fvilla-edge/Sand-Monitoring/relay/modulo-rele-biestable-flip-flop-12v.jpg

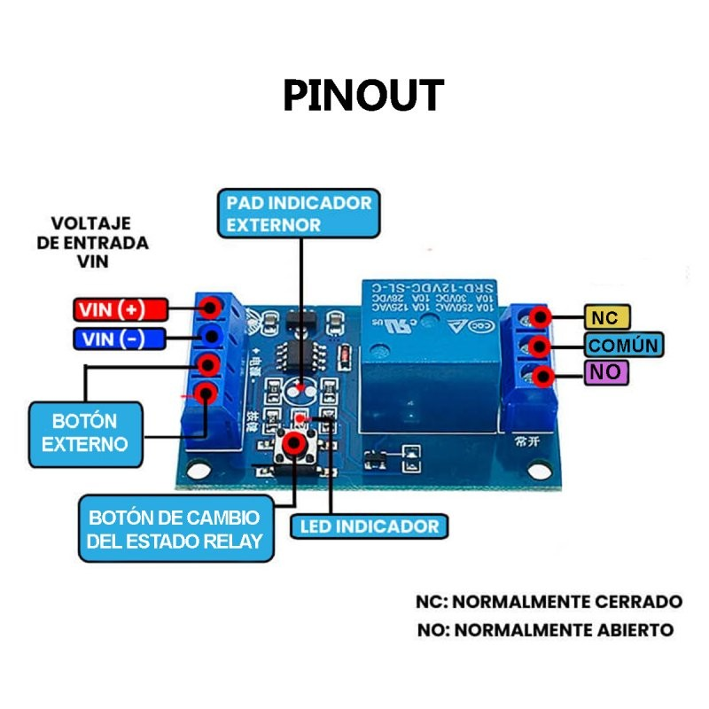
relay/modulo-rele-biestable-flip-flop-12v.jpg
