fvilla-edge/Sand-Monitoring/starlink_api/README.md

# Telemetria del dish Starlink (GPS + estado del link) para Losant

`starlink_get_location.py` lee posicion GPS y estado del link de la antena
Starlink via su API gRPC no oficial (`192.168.100.1:9200`), y expone
`build_telemetry_payload()` + `to_losant_data()` para convertir eso al formato
plano que espera Losant.

**Este modulo no corre solo en produccion.** Lo consume
`panel_solar_ble/publicar_losant.py`, que publica el estado a Losant en el
mismo Device que ya usa el panel solar (mismo `DEVICE_ID`, a proposito — ver
`panel_solar_ble/losant_config.py`). No hay un servicio ni credenciales
propias en esta carpeta: dos conexiones MQTT simultaneas con el mismo
`client_id` se pisarian entre si.

`publicar_losant.py` publica el estado de Starlink una sola vez por cada
evento `connect`/`reconnect` de Losant (la señal mas directa de "hay
internet y llega a destino") — no hay reporte periodico para esto, a
diferencia del panel solar.

## Modo hardcoded vs live

Controlado por `starlink_api.modo` en `config_campo.json` (`"hardcoded"` o
`"live"`), leido una sola vez al importar `publicar_losant.py` (mismo
reinicio de servicio que cualquier otra config leida asi, ver
`DESPLIEGUE.md`).

- **`hardcoded`** (default): usa `HARDCODED_TELEMETRY` de este archivo — un
  ejemplo real capturado el 2026-08-24. Sirve para probar toda la cadena
  (config → Losant → dashboard) sin estar conectado a la antena.
- **`live`**: llama a `build_telemetry_payload()`, que habla de verdad con el
  dish por gRPC.

## Por que `grpcurl` por subprocess y no la libreria `grpcio`

`pip install grpcio` en la placa (Red Pitaya, `armv7l`, Python 3.12) SI
encuentra un wheel binario en PyPI (`grpcio-1.83.0-cp312-cp312-linux_armv7l.whl`)
y se instala sin compilar nada — pero al importarlo tira `Illegal
instruction`. El Cortex-A9 de esta placa no soporta alguna instruccion que
ese wheel generico da por sentada (confirmado en la placa real, no una
suposicion). `piwheels` tampoco sirve: no publica `grpcio` para esta
combinacion de plataforma/version de Python.

El binario estatico `grpcurl` (Go, build `linux_armv7`) corre limpio en esta
misma placa — sin compilacion C, sin el problema de instrucciones del wheel
de `grpcio`. `build_telemetry_payload()`/`get_dish_location()` lo invocan
por `subprocess` (`bin/grpcurl`, o el del `PATH` si existe) y parsean su
salida JSON — validado contra el dish real (ver mas abajo), incluyendo el
modo `live` end-to-end.

**Ojo con las claves:** `grpcurl` devuelve JSON en **camelCase**
(`getLocation`, `dishGetStatus`, `gpsStats`, `popPingLatencyMs`, etc. — el
mapeo estandar de proto3 a JSON), no en snake_case como devolvia
`MessageToDict(..., preserving_proto_field_name=True)` de la libreria
`grpcio` que se uso originalmente. El parseo de `starlink_get_location.py`
ya usa los nombres camelCase correctos — si el dish cambia de firmware y el
esquema cambia, `grpcurl -plaintext <host> describe SpaceX.API.Device.Response`
sirve para volver a inspeccionarlo.

**Instalar el binario en una placa nueva** (no viene en git, es un binario
externo):
```bash
mkdir -p /root/starlink_api/bin && cd /root/starlink_api/bin
curl -sL -o grpcurl.tar.gz https://github.com/fullstorydev/grpcurl/releases/download/v1.9.3/grpcurl_1.9.3_linux_armv7.tar.gz
tar xzf grpcurl.tar.gz grpcurl && rm grpcurl.tar.gz && chmod +x grpcurl
```

## Atributos que hay que crear en Losant

Mismo Device que panel solar. Nombre → tipo, segun `to_losant_data()`:

| Atributo | Tipo |
|---|---|
| `posit` | string ("lat,lon") |
| `altitude` | number |
| `gps_valid` | boolean |
| `gps_satellites` | number |
| `ping_ms` | number |
| `ping_drop_rate` | number |
| `downlink_bps` | number |
| `uplink_bps` | number |
| `obstruction_fraction` | number |
| `alerts` | string |
| `uptime_s` | number |
| `hardware_version` | string |
| `software_version` | string |
| `starlink_device_id` | string |
| `software_update_state` | string |
| `software_update_progress` | number |
| `disablement_code` | string |
| `starlink_error` | string |

Si no existen en el Device antes del primer publish, Losant probablemente
los descarta silenciosamente.

**`disablement_code`** — por que el dish no esta dando servicio (viene de
`dishGetStatus.disablementCode`, enum `SpaceX.API.Satellites.Network.UtDisablementCode`,
confirmado contra el dish real via `grpcurl describe`). En operacion normal
vale `OKAY`. Valores posibles:

| Valor | Significado |
|---|---|
| `OKAY` | Sin problema, dando servicio normalmente |
| `UNKNOWN_STATE` | Sin dato todavia (recien arrancando, etc.) |
| `NO_ACTIVE_ACCOUNT` | La cuenta de Starlink asociada no esta activa |
| `ACCOUNT_DISABLED` | Cuenta deshabilitada |
| `TOO_FAR_FROM_SERVICE_ADDRESS` | El dish se movio lejos de la direccion de servicio registrada |
| `IN_OCEAN` | Detectado en el oceano, fuera de zona de servicio |
| `UNKNOWN_LOCATION` | No pudo determinar la ubicacion para validar el servicio |
| `BLOCKED_COUNTRY` | Pais bloqueado por Starlink |
| `BLOCKED_AREA` | Zona especifica bloqueada (aunque el pais no lo este) |
| `ROAM_RESTRICTED` | Roaming no permitido para este plan/cuenta en esta ubicacion |
| `DATA_OVERAGE_SANDBOX_POLICY` | Cortado por politica de exceso de datos |
| `CELL_IS_DISABLED` | La celda satelital que le corresponde esta deshabilitada |
| `MOVING_TOO_FAST_FOR_POLICY` | Se esta moviendo mas rapido de lo que permite la politica del plan |
| `UNDER_AVIATION_FLYOVER_LIMITS` | Restringido por limites de sobrevuelo (uso aviacion) |
| `UNSUPPORTED_VERSION` | Version de software del dish no soportada |

Util para diagnostico remoto: si Losant deja de recibir datos, este campo
(en el ultimo reporte que si llego) puede explicar si fue un corte de
conectividad comun o si Starlink dejo de dar servicio por una causa
puntual (cuenta, ubicacion, politica de uso).

`starlink_error` no viene de `to_losant_data()` — lo agrega
`publicar_losant.py` aparte: `None` cuando el informe salió bien, mensaje de
la excepción (string) cuando falló obtener o publicar la telemetría (ver
`_publicar_starlink`). Es la forma de enterarse en campo, sin SSH a mano,
de que algo del lado Starlink dejó de funcionar.

## Probar la transformacion sin la placa ni grpcio instalado

```bash
python3 -c "from starlink_get_location import to_losant_data, HARDCODED_TELEMETRY; print(to_losant_data(HARDCODED_TELEMETRY))"
```
