fvilla-edge/Sand-Monitoring/docs/modo_evento.md

# Modo evento — captura continua 24h, guardando solo lo que importa

Estado al 2026-11-02:

- **Campo (`rp-f0fbda`):** instalada en el sitio (PAD-118) desde el 29/10, en
  **dual** (IN1 + IN2, dec 64) con el bitstream del IN2 `20ac88b` y el
  paquete `ff47f40` (tag `campo-2026-10-21b`). Starlink en modo ventana: los
  CSV suben a GCS cada 2 h y se ven en SandVision.
- **Lab (`rp-f0fd8c`):** mismo software; ahí se prueba todo antes de campo.
- Falta: calibrar el umbral del IN2 con arena real (hoy usa el del IN1) y
  explicar los picos sueltos del IN2 de la primera noche en el sitio
  (29-30/10, kurtosis 5-850 en un solo punto, sin pase en el IN1).

Historia de cada parte en los planes: `plan_dos_canales.md` (primera versión,
IN2 de referencia; reemplazada), `plan_in2_independiente.md`,
`plan_in2_asociado.md`, `plan_cambio_canales_remoto.md`,
`plan_canales_por_tag.md`. Este documento describe **cómo funciona hoy**.

## Idea

Capturar la señal del sensor **todo el tiempo**, sin cortes, pero sin guardar
~230MB cada 30s. La FPGA calcula área y kurtosis de cada ventana de 50ms en
tiempo real; el programa de la placa guarda:

| Qué | Cuándo | Tamaño aprox. |
|---|---|---|
| Área + kurtosis de **cada** ventana (CSV) | siempre, 24h | ~30MB/día |
| Señal cruda de la ventana ±10ms (`evento_*.bin` + `.json`) | solo si kurtosis ≥ umbral (default 3.4 desde el 5/10/2026, antes 5) | ~0.5MB por evento a dec32 |

En dual, el IN2 tiene lo mismo (su CSV y sus eventos) en `<destino>/in2/`
(ver "Mono y dual").

Por qué guardar siempre el área y la kurtosis, además de los eventos:

1. **Señal de vida.** Sin el registro continuo, una carpeta sin eventos puede
   significar "no pasó arena" o "el sensor se desconectó" — no hay forma de
   distinguirlo. Con el registro, un sensor muerto se ve (área en cero o
   anormal).
2. **Historia completa del pozo**: duración de los pases, horarios,
   tendencias; no solo picos sueltos.
3. **Reanalizar hacia atrás.** Si el umbral correcto resulta ser otro (el 21/9
   el criterio viejo `fa%>25%` no vio arena real), se recalcula con los datos
   ya grabados. Lo que quedó bajo el umbral no se pierde.
4. **Validar contra el campo**: cuando el pozo dice "hubo arena de 14:50 a
   15:17", se ve qué midió el sensor en todo ese intervalo.
5. **Reconstruir la señal** en la PC con un relleno realista (ver abajo).

## Piezas

```
Placa (rp-f0fd8c / campo)                      PC
─────────────────────────                      ──
FPGA (bitstream port-2026.1)                   ventanas_a_paquete.py
  pasabanda 50-400kHz + área/kurtosis            CSV -> paquete liviano (JSON)
  por ventana (registros 0x40000328..;          ver_paquete.py
  IN2 desde 0x4000034C, bitstream 20ac88b)
        │ registros                              visor área/kurtosis, horas/días
        ▼                                      reconstruir_senal.py
scripts_campo/c/capturar_eventos (C++)           eventos + CSV -> señal continua
  - stream NET de la señal CRUDA -> buffer        (dominio filtrado, relleno
    circular en RAM                                con ruido de fondo)
  - sondea los registros de la FPGA c/2ms      verificar_etapaB.py
  - kurtosis >= umbral -> guarda la cruda        banco: eventos vs tramo real
  - escribe el CSV de todas las ventanas
scripts_campo/capturar_eventos.py (lanzador)
```

- `scripts_campo/c/capturar_eventos.cpp` — núcleo. Compilar **en la placa**:
  `make -C /root/scripts_campo/c` (usa `/root/rpsa_client/streaming_api`).
  Está en C++ porque en Python el callback no daba abasto (~63% de muestras
  perdidas, ver el comentario de cabecera).
- `scripts_campo/capturar_eventos.py` — lanzador (bitstream + streaming-server
  + `exec` del binario).
- `analisis/placa/ventanas_a_paquete.py`, `analisis/placa/reconstruir_senal.py`,
  `analisis/visores/ver_paquete.py`, `analisis/placa/verificar_etapaB.py` — PC.

## Supervisor (`modo-evento.service`)

`scripts_campo/systemd/modo-evento.service` + `scripts_campo/supervisor_eventos.sh`.

- **Arranca solo al encender** (después de `redpitaya_startup` y
  `redpitaya_e3_controller`: si carga el overlay a la vez que el del vendor,
  `overlay.sh` falla con `overlays/Full: File exists` y el acumulador no
  aparece).
- **Relanza siempre** que el proceso se cae, **sin rendirse**
  (`StartLimitIntervalSec=0`), con **60s** de espera (`RestartSec`). Cada
  relanzamiento recarga el bitstream → `window_count` vuelve a empezar → el
  CSV queda con un hueco de **~74s** y `ventanas_a_paquete.py` lo separa en
  tramos.
- Cada fin de corrida queda en `/root/logs_campo/modo_evento_reinicios.log`
  (`resultado=core-dump estado=SEGV` = caída, `success` = parada limpia).
  Core dumps en `/root/logs_campo`, podados al límite de `config_campo.json`.
- **Destino: `/mnt/usb/eventos`** (storage externo, automontaje de
  `scripts_campo_comun/udev-automount/`). La señal cruda **nunca va a la SD**:
  - al arrancar (`supervisor_eventos.sh arrancar`, el `ExecStart`), si
    `/mnt/usb` no es un disco (carpeta de la SD o `tmpfs`) **mide igual, solo
    el CSV de ventanas**, en `rutas.eventos_sd` (`/root/eventos_sd`) con la
    cruda siempre pausada (~3MB/h; queda `sin_disco` en el log de reinicios).
    El destino real queda en `/run/modo-evento/destino` (`<carpeta>` o
    `<carpeta> sin_disco`) para el anotador. Cuando el disco vuelve,
    `automount_usb.sh` relanza `modo-evento` y vuelve solo a `/mnt/usb/eventos`
    (desde el 2026-10-01; antes no arrancaba y la placa quedaba sin medir
    hasta entrar por SSH, como el 30/9 y el 1/10 con el disco de campo caído);
  - durante la corrida, `capturar_eventos` verifica antes de cada escritura
    que el destino siga en el mismo dispositivo; si el USB se desconecta
    (el automontaje hace `umount -l` y `/mnt/usb` pasa a ser carpeta de la
    SD) corta con código 4 en el mismo segundo.
  - Probado con `umount -l`: corte inmediato, 0 archivos en la SD, al
    remontar retomó solo en el siguiente reintento.
- **Espacio libre** (`modo_evento.minimo_libre_mb` en `config_campo.json`,
  default 2048; 0 = sin control): por debajo se **pausa la señal cruda** de
  los eventos y el CSV sigue (~3MB/h: la línea de tiempo no se pierde); se
  reanuda con un 25% de margen (2560MB). Mientras está pausada existe
  `/run/modo-evento/cruda_pausada`, que el anotador manda a Losant como
  `me_cruda_pausada`, y la línea `ESTADO` dice `CRUDA PAUSADA` (siempre trae
  `libre_mb=`). Si igual se llena el disco, un evento que no entra se borra y
  se cuenta (`fallidos`, en el log el 1ro y 1 de cada 100), y el CSV avisa
  una vez, se recorta a la última fila completa y retoma solo al haber lugar.
- Umbral: `Environment=UMBRAL=...` en la unit.
- **El server acepta un solo cliente**: para usar `capturar_stream.py` en la
  misma placa, antes pasar a modo clásico (`cambiar_modo.sh clasico`, abajo).
- **Mono/dual y modo del IN2** salen de `config_campo.json`
  (`modo_evento.canales`, `modo_evento.in2_modo`); ver "Mono y dual". Un
  drop-in con `Environment=CANALES=` o `DEC=` gana sobre el config (solo para
  pruebas). `UMBRAL2` (opcional) = umbral del IN2; sin él, el del IN1.
- **Archivos de estado** (`/run/modo-evento/`, RAM, los lee el anotador):
  `destino` (carpeta, `sin_disco`), `medicion` (`canales=2 dec=64
  in2=independiente`, lo escribe el supervisor al arrancar), `in2` (`si`/`no`:
  si el bitstream calcula el IN2, lo escribe `capturar_eventos`), `cruda_pausada`.
  El supervisor borra `medicion` e `in2` al parar: mientras reinicia, el
  resumen no trae `me_canales`.

```bash
cp /root/scripts_campo/systemd/modo-evento.service /etc/systemd/system/
systemctl daemon-reload && systemctl enable --now modo-evento
systemctl status modo-evento            # estado
journalctl -u modo-evento -f            # log en vivo
systemctl stop modo-evento              # parar (no lo relanza)
```

### Vuelta atrás: modo clásico (`cambiar_modo.sh`)

Si el modo evento se porta mal en campo, se vuelve al esquema anterior
(bitstream del vendor, capturas a pedido con el comando "capturar" de Losant
o `capturar_stream.py`/`repetir_captura.sh`) y después se retoma:

```bash
bash /root/scripts_campo/cambiar_modo.sh clasico   # o: evento
journalctl -u cambiar-modo -f                      # seguirlo
cat /root/logs_campo/cambiar_modo.log              # historial de cambios
```

- **El bitstream lo elige el modo**: `asegurar_servidor(bitstream_propio=True)`
  en `capturar_eventos.py` carga `/opt/stream_app/fpga.bin`
  (`overlay.sh stream_app propio`); `capturar_stream.py` carga el stream_app
  del vendor. No hay que tocar nada más para cambiar de bitstream.
- Corre como unidad transitoria de systemd (`cambiar-modo`): un corte de SSH
  o de Starlink en el medio no lo interrumpe; un segundo cambio mientras hay
  uno en curso se rechaza; repetir el mismo modo no reinicia nada.
- `clasico`: `disable --now modo-evento` (no vuelve al reiniciar), carga el
  stream_app del vendor y verifica `/tmp/loaded_fpga.inf` = `stream_app` y el
  registro del acumulador (0x40000328) en 0.
- `evento`: rechaza si hay un `capturar_stream.py` corriendo;
  `enable --now modo-evento`, espera el primer `ESTADO` (tope 4 min, cubre la
  espera de 90s de uptime al boot) y verifica `stream_app_propio` y el
  registro en 195312.
- `resumen-modo-evento` sigue en los dos modos: en clásico manda
  `me_activo=false` (y `me_seg_sin_datos` crece, es esperable) junto con la
  salud de la placa.
- Al reiniciar en clásico la placa queda con el bitstream del arranque del
  vendor (`v0.94`); cada captura carga el stream_app del vendor.

Probado en `rp-f0fd8c` (2026-09-28): evento → clásico en 7s; captura clásica
de 1 min (2 chunks, 97%/94% de eficiencia, acumulador en 0); reboot en clásico
(sigue deshabilitado); clásico → evento en 30s con la sesión SSH cortada
(`kill -9`) al segundo de lanzarlo: midiendo al 100%, `NRestarts=0`;
repetir `evento` no reinició el servicio; un segundo cambio simultáneo fue
rechazado.

## Mono y dual

| Modo | Qué mide | Decimación | Eventos |
|---|---|---|---|
| Mono (`canales` 1) | IN1 | 32 (fs 3.906MHz) | IN1 en `<destino>/` |
| Dual independiente (`canales` 2, `in2_modo` independiente) | IN1 + IN2 | 64 (fs 1.953MHz) | cada sensor dispara por **su** kurtosis y **su** umbral: IN1 en `<destino>/`, IN2 en `<destino>/in2/` |
| Dual asociado (`in2_modo` asociado) | IN1 + IN2 | 64 | el IN2 graba su cruda **solo cuando graba el IN1**, el mismo tramo y con el **mismo nombre** en `in2/` |

- **Por qué dec64 en dual:** escribiendo 1 evento/s, dual a dec32 perdió
  0.12% de muestras y 5 ventanas en 15 min; a dec64, 0.00045% y 0 (pruebas
  W15/W15d64, 2026-10-06). La banda 50-400kHz entra entera (Nyquist 976kHz).
  Al arrancar, `capturar_eventos` escribe en la FPGA el largo de ventana (50ms)
  y los coeficientes del pasabanda para esa fs y los verifica. **Mono sigue a
  dec32.**
- **Los dos canales se calculan igual** en la FPGA (filtro + acumulador propios,
  mismos coeficientes y largo de ventana), con `window_count` común: las filas
  de los dos CSV se emparejan por `window_count`.
- **El IN2 sigue con su CSV** en los dos modos de dual; asociado solo cambia qué
  dispara la grabación de su cruda. En asociado el `.json` del IN2 trae
  `"disparo": "IN1"` y el área/kurtosis **del IN2** en esa ventana. Si la cruda
  del IN1 no se pudo guardar (espacio, buffer pisado), el IN2 sigue con lo suyo
  (puede quedar uno sin el otro).
- **Bitstream sin el IN2** (`7f23f7d`, ID `0x00000000`; el del IN2 tiene
  `0x534D0002` en `0x4020007C`): en independiente mide **solo el IN1** (log
  `WARNING bitstream sin calculo del IN2`), sin CSV del IN2; en asociado graba
  igual la cruda del IN2 (el stream trae los dos canales) pero sin su
  área/kurtosis (`null`) ni su CSV. Losant informa `me_canales = 1` en
  independiente.
- **A dec64 los números no son comparables con dec32 sin recalibrar:** el umbral
  3.4 se eligió a dec32 (reposo dec64 en el lab: kurtosis mediana 2.998, máx
  3.06); `ESCALA_FPGA_DEFAULT` / `PISO_FPGA_DEFAULT` están medidos a dec32. El
  umbral del IN2 es hoy el del IN1, sin calibrar con su sensor real.
- **Asociado duplica la escritura** de cruda en cada evento (IN1 + IN2): con
  mucha arena, el doble de disco y de E/S en el mismo instante.
- En el lab el IN2 solo vio ruido: falta ver los dos sensores con arena real.

### Cambiar de modo

No editar el config a mano (comandos y ejemplos en `COMANDOS.md`, sección
"Mono / dual y modo del IN2"):

- **En la placa:** `cambiar_canales.sh 1` / `2` / `2 independiente|asociado`.
- **Losant, comando `canales`:** `{"canales": 1}`, `{"canales": 2, "in2":
  "asociado"}` (`"in2"` opcional, solo con 2). Lo recibe `publicar_losant.py`
  y lanza el script.
- **Losant, tags del Device** `canales` / `in2_modo`: el workflow los compara
  con lo que la placa informa y manda el comando solo si difieren. **En modo
  ventana usar los tags**: Losant no guarda comandos, y uno mandado con la placa
  desconectada se pierde (`plan_canales_por_tag.md`). Con los tags puestos, un
  comando a mano distinto lo deshace el workflow al minuto.

`cambiar_canales.sh` corre desacoplado (`systemd-run --unit=cambiar-canales`:
sigue aunque se corte el SSH o Starlink; un segundo cambio en curso se rechaza),
toma el lock del relé (espera hasta 200 s), escribe las claves de forma atómica
(`cfg.py --poner`: temporal + fsync + rename), reinicia **solo** `modo-evento`
(hueco de ~1-2 min en el CSV) y espera hasta 4 min a que `medicion` diga lo
pedido. Si no, **vuelve solo al modo anterior**. Pedir lo que ya mide responde
`ok ... (ya estaba)` sin reiniciar; en modo clásico no hace nada. Tarda ~30 s;
~1 de cada 10 arranques la librería del vendor se cae en `startStreaming` y
systemd la relanza a los 60 s (el cambio tarda ~1,5 min y termina igual).
Resultado en `/root/logs_campo/cambio_canales_estado` (= `me_cambio`) y
historial en `cambiar_canales.log`.

### Qué llega a Losant (anotador `resumen_modo_evento.py`, cada minuto)

Además de lo de siempre (`me_activo`, `me_estado`, `me_ventanas_1min`,
`kurt_max_1min`, `area_*`, `me_cruda_pausada`, salud de la placa):

| Atributo | Qué es |
|---|---|
| `me_canales` | lo que **se mide**: 1 o 2 (dual con bitstream sin IN2 → 1); no viene mientras la captura reinicia |
| `me_in2_modo` | `independiente` / `asociado`, solo con `me_canales` = 2 |
| `me_dec` | 32 o 64 |
| `me_cambio` | resultado del último cambio (`ok 2 asociado <hora>`, `error: ... (volvio a 1)`, ...) |
| `kurt_max_1min_in2`, `area_max_1min_in2` | del IN2, en dual, **desde el segundo minuto** (el lector arranca al final del CSV) |

Los CSV del IN2 suben a GCS con sufijo `_in2` (`_sd_in2` sin disco), porque
tienen el mismo nombre que los del IN1.

## Formatos

### Registro continuo: `ventanas_AAAAMMDD_HH.csv` (uno por hora UTC)

En la carpeta `--destino`, junto a los eventos. Se apaga con `--sin-registro`.

```
window_count,t_utc_ms,area,kurtosis,estado,perdidas_fpga,dec
7995,1790257893778,0.634819,3.24481,ok,0,32
7217,1790258000123,,,saltada,0,32
```

- `dec` (desde 2026-10-06): la escala del área cambia con la decimación. Los
  CSV viejos (6 columnas, sin `dec`) son todos dec32; la hora en que se
  actualiza el software puede mezclar filas de 6 y 7 columnas (los lectores de la PC lo
  soportan).
- El del IN2 (`<destino>/in2/ventanas_*.csv`) tiene el mismo formato y nombre.

- `window_count`: contador de ventanas de la FPGA. **Es la referencia de
  tiempo exacta** (cada ventana dura 50ms justos). No es continuo entre
  corridas (reinicios de captura/bitstream).
- `t_utc_ms`: hora UTC en que el programa **leyó** la ventana (jitter de
  ~±35ms). Sirve para anclar a la hora real, no para ubicar muestras.
- `estado=saltada`: el sondeo no llegó a leer esa ventana (el registro de la
  FPGA solo guarda la última). Área y kurtosis vacías: no hay dato.
- `perdidas_fpga`: muestras que el streaming-server reportó perdidas desde la
  fila anterior.
- Escritura en un hilo propio (flush cada 1s, cota de 10 min en RAM) para que
  la SD no frene el sondeo.

### Evento: `evento_<fecha>_<hora>_<us>_wc<window_count>.bin` + `.json`

`.bin`: int16 little-endian, señal **cruda** (sin filtrar), ventana oficial +
margen a cada lado. `.json`:

| Campo | Qué es |
|---|---|
| `window_count` | ventana de la FPGA que cruzó el umbral |
| `fs_hz`, `dec` | frecuencia de muestreo y decimación |
| `ventana_muestras`, `margen_muestras` | 195312 y 39062 a dec32, 97656 y 19531 a dec64 (50ms, ±10ms) |
| `inicio_ventana_en_archivo` | dónde empieza la ventana oficial dentro del `.bin` (ver "alineación" abajo) |
| `area`, `kurtosis` | los que calculó la FPGA para ese canal (`null` si el bitstream no calcula el IN2) |
| `con_hueco` | `true` si faltaron muestras en ese tramo (ver "huecos") |
| `canales` | 1 o 2 (corrida mono o dual) |
| `canal` | sensor guardado en ese `.bin`: `IN1` o `IN2` (este en `<destino>/in2/`) |
| `disparo` | sensor que hizo grabar: `IN1`, o `IN2` en independiente; en asociado el del IN2 dice `IN1` |
| `timestamp_iso` | hora de la detección (desde el 2026-10-15 se fija al detectar, no al escribir: así el par IN1/IN2 asociado tiene el mismo nombre) |

## Comandos

En la placa (compilar una vez):
```bash
make -C /root/scripts_campo/c
```

Captura a mano, solo para pruebas con `modo-evento` parado (umbral 3.4,
destino por defecto `/root/eventos`; en la placa la corre el servicio):
```bash
python3 /root/scripts_campo/capturar_eventos.py --umbral 3.4 --destino /root/eventos
```

Pruebas de banco (loopback OUT1->IN1 con cable, reproduciendo un tramo real
por el DAC): scripts en `/root/prueba_eth0/` de `rp-f0fd8c` (fuera de git):
`etapaB_lv.sh T RATE` (umbral 5, a la SD), `etapaB_lv_todo.sh` (umbral 1),
`etapaB_lv_shm.sh` (umbral 1, a RAM), `larga.sh T SEGUNDOS` (sin DAC, con
monitor de RAM/CPU), `pase_u1.sh T SEGUNDOS` (umbral 1 a `/mnt/usb`, peor
caso de escritura). `--dac-repetir N` repite el tramo N veces seguidas (pase
largo por cable). **El loopback digital (`--pulso-loopback-digital`) NO sirve
para reproducir el tramo con el bitstream 2026.1** (kurtosis fija ~2.99, K1 del
23/9 y PASE1 del 24/9): usar el cable OUT1->IN1 con el jumper en LV.
Antes de estas pruebas, `systemctl stop modo-evento` (un solo cliente). **Antes de lanzar, verificar que el nombre `T` no exista**
(los scripts borran `ev_T` y pisan los logs), y **espaciar las corridas
~60s** (el streaming-server queda residual si se lanzan en ráfaga).

Dos sensores con un T de OUT1 a IN1 + IN2 (2026-10-16): `etapa5_t.sh NOMBRE
partes` en el mismo directorio (humo, reposo, p64, p32, arena, tonos,
tonos32; para y vuelve a arrancar `modo-evento` solo). Análisis en la PC:
`analisis/placa/comparar_in1_in2.py` (IN1 vs IN2 por `window_count`) y
`analisis/placa/tonos_banda.py` (forma de banda). Resultados en la bitácora
de `docs/plan_in2_independiente.md`.

En la PC:
```bash
# CSV -> paquete liviano (uno por hora, o todos juntos)
.venv/bin/python analisis/placa/ventanas_a_paquete.py CARPETA/ventanas_20260924_15.csv
.venv/bin/python analisis/placa/ventanas_a_paquete.py CARPETA --unir -o dia.paquete.json

# visor (abrir el .paquete.json)
./analisis/visores/abrir_paquete.sh

# reconstruir un tramo (máx. 300s) + vista rápida
.venv/bin/python analisis/placa/reconstruir_senal.py CARPETA --desde 120 --duracion-s 10 --png

# banco: eventos guardados vs el tramo reproducido por el DAC
.venv/bin/python analisis/placa/verificar_etapaB.py tramo.bin CARPETA
```

## Reconstrucción de la señal

Idea: unir las ventanas crudas guardadas con ruido de fondo para ver una
señal continua. Decisiones:

- **Dominio filtrado.** El área de la FPGA es de la señal filtrada (50-400kHz),
  así que solo se puede imitar la parte dentro de la banda. Pegar relleno entre
  ventanas **crudas** deja un salto en cada unión (la cruda trae continua y baja
  frecuencia que el relleno no tiene). Los eventos se filtran en la PC
  (`area_kurtosis._filtrar_pasabanda`); la cruda queda en cada `.bin` para
  estudios aparte. No se guarda la filtrada de la FPGA: el DMA lleva una sola
  señal (la cruda), y guardar las dos duplicaría SD y Starlink.
- **Relleno**: ruido gaussiano pasado por el mismo pasabanda, con una
  envolvente que sigue el área de cada ventana del CSV (interpolada entre
  centros, sin escalones cada 50ms).
- **Uniones**: cada evento con peso 1 en su ventana oficial y rampa en el
  margen; eventos consecutivos se promedian (son copias del mismo stream).
- **Máscara**: 1 = real, 0 = relleno, 2 = relleno sin dato (ventana saltada).
  **El relleno es inventado: sirve para ver, no para calcular.**
- **Tamaño**: 15.6MB por segundo (float32) — una hora serían ~56GB. Se
  reconstruyen tramos de hasta 300s; para mirar días enteros está el paquete
  liviano en `ver_paquete.py`.
- **Área FPGA -> software**: `sw = sqrt((c·fpga)² − q²)`. Con señal fuerte
  c ≈ 0.999; en reposo la FPGA mide de más (piso de ruido). `c` se mide con ≥5
  eventos fuertes y `q` con eventos de reposo real (kurtosis < 4); si no hay,
  se usan los valores del banco `ESCALA_FPGA_DEFAULT = 0.9992` y
  `PISO_FPGA_DEFAULT = 0.3074` (bitstream port-2026.1, decimación 32, **jumper
  HV** como en campo; en LV da 0.2333 — **re-medir si cambia el bitstream o el
  jumper**). Que el piso cambie con el jumper indica que no es solo redondeo
  interno de la FPGA (causa sin confirmar). En HV, `c` no está medido (falta
  una prueba con señal fuerte en HV). Con umbral 5, casi nunca hay reposo
  guardado.

Validación (R2, umbral 1, simulando umbral 5): nivel del relleno +4% de
mediana (p10-p90 0.996-1.057), kurtosis del relleno 3.00 (real 3.05), 0
ventanas de relleno ≥5, uniones sin salto.

## Pruebas en la placa de pruebas (2026-09-23/24)

Todas en `rp-f0fd8c`, bitstream port-2026.1, decimación 32, loopback por cable
OUT1->IN1 (jumper IN1 en LV) reproduciendo el tramo real
`campo_reposo_20260903_144456` (10s) por el DAC, salvo L1.

| Corrida | Condición | Resultado |
|---|---|---|
| Etapa A | pulsos conocidos | alineación OK, 0 eventos sin pulso, corte de eth0 60s sin recalibrar |
| V2 | umbral 1, a SD | 11 saltadas, 1.96M muestras perdidas — la SD a ~10MB/s tira todo abajo |
| W1, W3 | umbral 1, a RAM | 0 saltadas, **0 pérdidas de sensibilidad**, 200/200 ventanas del tramo |
| W2, R1, P1 | umbral 5, a SD (como producción) | 0 saltadas; W2: 3 "pérdidas", 2 explicadas por la alineación y 1 en el umbral (5.15) |
| R2 | umbral 1, a SD | 2 saltadas marcadas en el CSV, `perdidas_fpga` = total del log |
| **HV15** | umbral 5, a SD, sin DAC, **jumper HV**, 15 min | 18000 ventanas, 0 saltadas, 0 muestras perdidas, **0 eventos**, kurtosis p50 2.98 / máx 3.06, área de reposo 0.515 |
| Supervisor | 5 SIGSEGV, matar el server, stop/start, 2 reinicios de la placa | 5/5 recuperados (~74s de hueco c/u); server caído -> el cliente muere (SIGSEGV del vendor) y se recupera; `stop` no relanza; al boot arranca solo (1er reinicio falló por la carrera con el overlay del vendor y se recuperó en el reintento; con `After=` arrancó al primer intento) |
| **PASE2** | **peor caso de escritura**: umbral 1 (todas las ventanas) a `/mnt/usb`, 30 min, HV | 35981 eventos (19GB, ~10.8MB/s), 0 perdidos por cola, **0 errores de USB/ext4**, RAM estable; **0.59% de muestras perdidas** (en ráfagas) y **18 ventanas saltadas** (0.05%) |
| **L1** | umbral 5, a SD, **sin DAC, 90 min** (15:06-16:36 UTC) | 107999 ventanas, 0 saltadas, 100% muestras; **rotación de hora OK**; RAM/CPU planas (29.6MB / 21.5%); 1 evento (pico aislado de ~1ms, probable interferencia del banco) |
| **Espacio** (2026-09-25) | disco de prueba de 400MB (ext4 en loop), umbral 1 (~11MB/s) | A, mínimo 100MB: pausa a 97MB libres, 480 eventos completos + 1319 no guardados, CSV 1800/1800. B, sin control: disco al 100%, 535 eventos fallidos borrados, 0 archivos a medias, sin caída. C/D, arranca lleno y se libera en marcha: el CSV avisa una vez, sin líneas cortadas, con encabezado, retoma solo al liberar |

Detector (FPGA vs software sobre las mismas muestras que llegaron): mediana
0.12-0.26%, 0 desacuerdos de clasificación, con la alineación corregida.

## Hallazgos y limitaciones conocidas

- **Alineación ventana FPGA vs buffer propio**: `inicio_ventana_en_archivo`
  queda **1.5-3.2ms antes** de la ventana real de la FPGA, y **varía entre
  corridas**. Causa probable: `calibrar()` toma el mínimo de
  `wc·N − muestras_recibidas` y no puede ver la latencia mínima de entrega
  DMA -> callback. El margen de ±10ms lo cubre (no se pierde señal). Decisión
  (2026-09-24): quedarse con el margen; la calibración por contenido al
  arranque no funcionaría en campo (casi todo reposo, sin contraste).
  Propuesto: alinear cada evento después, en la PC, y usarlo como monitor
  (si el desfase se acerca a 10ms, agrandar el margen).
- **Huecos** (`con_hueco: true`): en el tramo que no llegó, el `.bin` tiene
  **datos viejos** del buffer circular (~300ms antes), no ceros, y el JSON no
  dice dónde. `reconstruir_senal.py` omite esos eventos. Pendiente: guardar la
  posición del hueco en el JSON.
- **Escribir mucho hace perder muestras**: a la SD (V2) mucho; al USB
  (PASE2, ~10.8MB/s, el doble de un pase real) 0.59% de muestras y 0.05% de
  ventanas. Causa probable: el kernel vacía de golpe ~30MB de páginas sucias
  y frena la captura. Sin probar: `vm.dirty_bytes` más chico o `fsync` más
  seguido. Con umbral 5 en reposo no pasa.
- **`pkill -f streaming-server` mataba cualquier proceso** con ese texto en
  su línea de comando (una sesión SSH, un `grep`). Arreglado a
  `pkill -x streaming-serve` en `campo_common.asegurar_servidor` y
  `relanzar_captura.sh` (2026-09-24). En la placa de campo sigue el código
  viejo hasta que se actualice.
- **El streaming-server acepta una sola conexión de configuración**: un
  segundo cliente tira al primero y la librería del vendor muere por SIGSEGV.
  No correr otro cliente contra el server a la vez.
- **El DAC por red no es exacto en tiempo** (mete silencios, lee el archivo
  antes de reproducirlo): sirve para inyectar señal, no como referencia de
  tiempo. `--prueba-archivo` espera la duración real del replay antes de
  cortar.
- **Reposo del banco**: el 23/9 dio kurtosis ~5.3 (HV) / ~6.4 (LV); el 24/9
  ~3.0 en LV y 2.98 (máx 3.06, 15 min) en HV. Sin explicar qué cambió.
- **Sesgo +4%** del nivel del relleno en la reconstrucción, sin explicar.

## Pendientes

- Lab (`rp-f0fd8c`) desde el 16/10 ~20:00 UTC: jumpers de IN1 e IN2 en **HV**
  (como campo) y el **T de OUT1 a IN1 + IN2 queda puesto**: lo que captura
  el IN2 del lab es OUT1 en reposo, no un sensor. Para una prueba fina de
  banda con tonos, pasar a LV solo ese rato (en HV 0.8 V es ~4% del rango).
- Posición del hueco en el JSON del evento.
- Herramienta de alineación por evento en la PC (monitor del margen).
- Dos sensores en campo (va con el paquete integrado, `actualizar_placa_campo.md`
  sección 7): antes confirmar físicamente qué hay en el IN2 de campo y su
  jumper; probar asociado con señal en los dos sensores; calibrar el umbral
  del IN2 y re-medir escala/piso de la FPGA a dec64 con datos de campo.
- Recalibrar `FA_THRESH` / `INTERPRETACION_RESULTADOS.md` con los eventos
  reales confirmados del 21/9.
