fvilla-edge/Sand-Monitoring/docs/plan_in2_independiente.md

# Plan — IN2 como sensor independiente (área/kurtosis en la FPGA)

Estado: **etapas 1-8 hechas en lab; etapa 5 (T) hecha el 2026-10-16**
(reposo con el T cerrado el 2026-10-19 con los datos del fin de semana). Reemplaza la "opción A" de
`docs/plan_dos_canales.md` (FPGA solo IN1, IN2 crudo): el IN2 tiene que
funcionar **igual que el IN1**, como un segundo sensor. Todo en la placa de
pruebas (`rp-f0fd8c`) hasta la última etapa; la placa de campo no se toca.

Regla del plan: **una etapa a la vez, cada una con un criterio de paso
medible y una vuelta atrás probada**. Si una etapa falla, se para ahí y se
entiende antes de seguir. Ninguna etapa mezcla FPGA y software nuevos a la
vez en el hardware.

## Punto de partida (verificado 2026-10-06)

- Bitstream en las dos placas: repo `fpga_pitaya`, rama `lectura-dio`,
  `7f23f7d` (Master fijo), Vivado 2025.1 (`~/vitis/2025.1`).
- `rp_oscilloscope.v` ya instancia `osc_top` **una vez por canal**
  (`generate` sobre `NUM_CHANNELS = 2`): cada canal tiene su decimador,
  su pasabanda y su acumulador. Pero `scope_cfg.sv` solo conecta a
  registros las sumas del **canal 0** (`0x328-0x348`). Las del canal 1 no
  salen a ningún lado, así que probablemente Vivado las eliminó al
  sintetizar (a confirmar, etapa 1a).
- Coeficientes del pasabanda (`0x300-0x324`) y largo de ventana (`0x328`)
  son **compartidos** por los dos canales: el C++ actual ya los configura
  para los dos sin cambios.
- Recursos del build actual: DSP 41/80 (51%), LUT 51%, BRAM 32%. Un
  segundo filtro + acumulador suma [Suposición] ~15-25 DSP -> ~70-80%.
  Entra, pero el timing ya costó cerrarlo una vez (port a 2026.1).
- Registro de ID `0x4020007C = 0x534D0001`: sirve para que el software sepa
  qué bitstream está cargado.

## Decisiones (usuario, 2026-10-06)

1. **Eventos independientes:** cada canal dispara y guarda **sus propios**
   eventos, sin interferir con el otro. Un evento del IN1 guarda solo el
   IN1 y uno del IN2 solo el IN2 (en dual, el IN1 deja de llevar el
   `_ch2.bin` de la Fase 1).
2. **Umbral del IN2:** propio (`UMBRAL2`), con el mismo valor que el IN1
   (hoy 3.4).
3. **CSV del IN2 aparte**, mismo formato. Propuesta de implementación:
   carpeta propia del IN2 (`<destino>/in2/`) con exactamente la misma
   estructura que la del IN1 (`evento_*.bin/.json`, `ventanas_*.csv`), así
   el visor, el organizador y el conversor a paquete sirven sin cambios.
   Hay que agregarla a la subida a GCS, al anotador y al control de
   espacio.
4. **Losant:** del IN2 alcanza con `kurt_max_1min_in2` y
   `area_max_1min_in2` (el detalle queda en los CSV).
5. **Mono** (`CANALES=1`): el IN2 no se calcula ni se reporta.

## Etapas

### Etapa 1 — RTL (repo `fpga_pitaya`, rama nueva desde `lectura-dio`)

- 1a. Confirmar en el reporte de síntesis jerárquico si el filtro +
  acumulador del canal 1 existen o fueron eliminados (cuánto agregan).
- 1b. 9 registros de solo lectura para el canal 1 a continuación de los del
  canal 0 (`0x34C-0x36C`: `window_count`, sumas |x|, x², x⁴), mismo
  formato. Verificar antes que esas direcciones estén libres.
- 1c. Subir el ID a `0x534D0002` (bitstream con IN2).
- **Paso:** compila la simulación sin warnings nuevos.
- **No cambia nada del canal 0** (mismas direcciones, misma lógica).

### Etapa 2 — Simulación (flujo `xsim` standalone que ya usamos)

- 2a. Regresión del canal 0: los mismos testbenches de siempre
  (`etapa4c_sim_bandpass.sh`, `etapa_simD_*`) tienen que dar lo mismo que
  antes, bit a bit.
- 2b. Canal 1 con **otra señal** que el canal 0 (p.ej. arena real en uno,
  reposo en el otro): cada canal coincide con el modelo Python y no se
  mezclan.
- 2c. `window_count` de los dos canales avanzan juntos.
- **Paso:** 2a idéntico, 2b dentro de lo ya aceptado para el canal 0.

### Etapa 3 — Build (Vivado 2025.1)

- Bitstream + `bootgen` (`.bit.bin`). Revisar timing (no peor que el build
  del 30/9) y recursos (DSP, LUT).
- **Si no cierra timing:** parar. Opciones a evaluar en ese momento
  (pipeline extra en el acumulador del canal 1, etc.), no improvisar.

### Etapa 4 — Placa de pruebas, solo registros (sin software nuevo)

- Cargar el bitstream nuevo en `rp-f0fd8c` con el método de siempre
  (`/opt/stream_app/fpga.bin`).
- 4a. **Compatibilidad hacia atrás:** el `capturar_eventos` actual (que no
  sabe nada del IN2) tiene que andar igual que hoy en mono y dual
  (mismos números de reposo, 0 saltadas). Esto es lo que permite
  actualizar campo sin cambiar el software a la vez.
- 4b. Con el stream corriendo en dual, leer a mano los registros nuevos
  (`window_count` del canal 1 avanza a 20/s junto con el del canal 0;
  área/kurtosis de reposo del IN2 con valores razonables).
- **Vuelta atrás:** volver a cargar el `fpga.bin` de `7f23f7d`.

### Etapa 5 — Loopback (necesita el T de OUT1 a IN1 + IN2)

- La misma señal entra a los dos canales: las sumas del IN1 y del IN2
  tienen que coincidir (salvo diferencias de ganancia de cada entrada).
- Pulsos y un tramo real de arena: kurtosis alta en los dos a la vez, en
  la misma ventana.
- Aprovechar para la prueba de forma de banda a dec64 con tonos (pendiente
  de la Fase 1b).

### Etapa 6 — C++ (`capturar_eventos`)

- Leer el ID; si es `0x534D0002` y `--canales 2`, leer también las sumas
  del canal 1. Con el bitstream viejo, seguir como hoy (sin IN2).
- Área/kurtosis del IN2 por ventana, disparo propio con `--umbral2`,
  eventos y CSV del IN2 en su carpeta (decisiones 1 y 3). El IN1 deja de
  guardar `_ch2.bin`.
- Pruebas en lab: reposo dual, escritura sostenida (tipo W15d64), disco
  lleno, mono después de dual.

### Etapa 7 — Anotador, Losant, PC

- `resumen_modo_evento.py`: `kurt_max_1min_in2` y `area_max_1min_in2`.
  `subir_csv_gcs.py`: la carpeta del IN2. Visor y organizador: sin cambios
  (misma estructura de carpeta).
- Crear los atributos en Losant (`test_SC` primero).

### Etapa 8 — Prueba larga en lab y vuelta atrás completa

- Una noche en dual con todo nuevo.
- Ensayar la vuelta atrás entera: bitstream `7f23f7d` + binario anterior.

### Etapa 9 — Campo (fecha a decidir)

- Bitstream con el procedimiento de actualización remota segura (Punto 5
  del repo `fpga_pitaya`).
- Primero **solo el bitstream con el software actual en mono** (etapa 4a
  en campo); recién después el software nuevo; recién después dual.
- Antes de dual: confirmar físicamente qué hay en el IN2 de campo y su
  jumper. El umbral del IN2 se calibra con datos de campo.
- **Cambio (2026-10-15):** la placa de campo vuelve a la empresa y se instala
  todo junto en un paquete (bitstream + software + dual), sin escalonar: el
  escalonamiento era para cuando el único acceso era Starlink. Procedimiento
  en `scripts_campo/plan_campo/actualizar_placa_campo.md`, sección 7.

## Riesgos conocidos

- **Timing/recursos** (etapa 3): es donde más puede trabarse.
- **Bitstream de campo**: es la operación más delicada de todo el plan; por
  eso va sola y con el software viejo primero.
- El umbral y la escala del IN2 no se conocen hasta medir su sensor real.

## Bitácora

- 2026-10-06, etapa 1 (repo `fpga_pitaya`, rama `in2-sensor` desde
  `lectura-dio 7f23f7d`, sin commitear): `scope_cfg.sv` +32 líneas
  (registros del canal 1 `0x34C-0x368`, `AREA_ID` `0x36C = 0x534D0002`),
  `rp_oscilloscope.v` +8 líneas (cableado del canal 1 que ya instanciaba el
  `generate`). Camino de datos (`osc_top`, filtro, acumulador) sin tocar.
  OJO: `rp_oscilloscope.v` mezcla CRLF y LF; editar en binario.
- 2026-10-06, etapa 2: simulación nueva `etapa_simE_in2.sh` /
  `tb_rp_oscilloscope_simE.sv` (`rp_oscilloscope` completo, decimación 32
  por AXI, tono de 150kHz con el IN2 al doble de amplitud): **8/8 OK**,
  cocientes canal1/canal0 = 2.0014 (|x|), 4.0055 (x²), 16.04 (x⁴); ID ok;
  window_count iguales; AXI del canal 1 = salidas internas del 2.º
  `osc_top`. Regresión: diag5 7/7, bandpass 45897/45897, área 4/4, simB
  2/2, simC 2/2, dio 12/12, simD (4) completas sin error (no compilan los
  archivos tocados: idénticas por construcción).
  - Con el factor de decimación por defecto (0 = una muestra por ciclo) el
    biquad se descontrola (sumas que no dependen de la entrada): modo que
    la placa no usa; la simulación D ya corría con 32 por eso.
  - Vivado 2025.1 (`~/vitis/2025.1`) fuerza `LC_ALL=en_US.UTF-8`, que hoy no
    está instalado en la PC (aborta con `locale::facet::_S_create_c_locale`).
    Arreglo sin tocar el sistema: `localedef -i en_US -f UTF-8 DIR/en_US.UTF-8`
    y `export LOCPATH=DIR` antes de correr.
- 2026-10-06, etapa 3 (commit `20ac88b`): build Vivado 2025.1, ~20 min.
  **Timing cumplido** (WNS +0.157ns, antes +0.155ns). DSP 58/80 (72.5%,
  antes 41: +17 = filtro + acumulador del canal 1, que antes Vivado
  eliminaba), LUT 52.6% (51.5%), registros 37.2% (35.5%).
  `out/red_pitaya.bin` md5 `b34cd26f…`, mismo encabezado que el de campo.
  Copias: `~/bitstreams/in2_20ac88b_red_pitaya.bin` y
  `~/bitstreams/campo_7f23f7d_red_pitaya.bin` (md5 `1e6b2cf2…`, el de las
  placas); carpeta `out/` del 30/9 completa en
  `~/respaldo_bitstream_7f23f7d_out`. Tropiezos (documentados en
  `COMPILAR.md` del repo fpga): el objetivo es `out/red_pitaya.bin` (no
  `.bit.bin`) y `write_cfgmem` falla si quedó un `.prm` viejo.
- 2026-10-06, etapa 4 (`rp-f0fd8c`): `/opt/stream_app/fpga.bin` = bitstream
  IN2 (md5 `b34cd26f…`), respaldo `fpga.bin.bak_7f23f7d_20261006`.
  **Software actual sin tocar**: mono (dec32) y dual (dec64) andan igual que
  con el bitstream viejo (20 ventanas/s, 100% muestras, 0 saltadas, IN2 del
  stream al 100% y desfase 0). Registros nuevos (`leer_in2.py`, solo
  lectura): ID `0x534d0002`; `window_count` del canal 1 = canal 0 en cada
  ventana; reposo IN2 área ~0.507 / kurtosis ~2.97 a dec32 y ~0.563 / ~3.0
  a dec64 (IN1: ~0.515 y ~0.578), valores propios ventana a ventana.
  - **Reinicio de la placa por error mío:** leí los registros (`/dev/mem`)
    segundos después de `systemctl start`, mientras `overlay.sh` recargaba
    el bitstream. Lectura AXI con el PL reconfigurándose -> CPU colgada ->
    watchdog a los 30s (18:10:56 -> reinicio 18:11:26). El drop-in recién
    escrito quedó con 85 bytes en cero (sin `sync`). Repetido bien (leer
    recién después de "Calibracion"): sin problemas. Regla: nunca leer
    registros del PL durante un arranque de modo-evento; `sync` después de
    escribir configs en las placas.
  - Placa de pruebas queda en **mono con el bitstream IN2** y el software
    actual (prueba de compatibilidad corriendo).
- 2026-10-06, etapa 6 (rama `in2-sensor` de Sand Monitoring, binario en
  `rp-f0fd8c:/root/staging_fase1/`, sin instalar en el servicio; se
  adelantó a la 5 porque el T tarda unos días):
  - 6a: `Registros::tiene_in2()` (base 2026.1 y ID `0x534D0002`) y
    `leer(..., canal)` (canal 1 = +0x20). ESTADO del IN2 con
    `kurt_max`, `area_max` y `otra_ventana` (lectura del canal 1 en otra
    ventana que el 0: 0 en todas las corridas). 60s dual dec64: IN2
    kurt_max ~3.05, area_max ~0.568.
  - 6b: CSV del IN2 en `<destino>/in2/` (mismo formato, columna `dec`,
    pérdidas del stream del IN2). 60s: 1200 filas en cada CSV, mismos
    `window_count` y hora, valores propios.
  - 6c: eventos propios del IN2 (`--umbral2`, default = `--umbral`; en la
    unit `UMBRAL2` opcional) en `<destino>/in2/`, escritor propio. El IN1
    ya no guarda `_ch2.bin`. `.json` suma `"canal": "IN1"|"IN2"`. Log
    `[EVENTO IN1]` / `[EVENTO IN2]` (nada lee esa marca). 120s dual dec64
    umbral 3.03: IN1 81 eventos = sus 81 ventanas ≥3.03 del CSV, IN2 132 =
    sus 132; todos bien formados; solo 6 ventanas en común (por azar ~4-5):
    independientes.
  - 6d (`in2_6d.sh`): mono igual que antes (sin carpeta `in2/`); disco lleno
    en dual (tmpfs 12MB): IN1 25 escritos / 27 fallidos, IN2 20 / 36, sin
    archivos sueltos en ninguna carpeta, medición sigue; dual con el
    bitstream viejo (7f23f7d): "WARNING bitstream sin calculo del IN2 (ID
    0x00000000): se mide solo el IN1", 48 eventos del IN1, sin `in2/`, sin
    `_ch2.bin`. Al final bitstream IN2 de vuelta (md5 verificado).
- 2026-10-06, etapa 7: `resumen_modo_evento.py` lee también
  `<destino>/in2` (solo si la corrida actual es dual según
  `/run/modo-evento/medicion` y la carpeta existe) y manda
  `kurt_max_1min_in2` y `area_max_1min_in2`. `subir_csv_gcs.py`: orígenes
  `<eventos>/in2` (sufijo `_in2`) y `<eventos_sd>/in2` (`_sd_in2`), así el
  CSV del IN2 (mismo nombre de archivo) no choca con el del IN1 en el
  bucket ni en el registro. Probado en local (resumir con/sin filas del
  IN2; horas_cerradas con disco, sin disco y con el `_in2` ya subido).
  Lab (19:08 UTC, respaldo `/root/respaldo_in2_etapa7_20261006/`): todo el
  software de las etapas 6-7 instalado en el servicio; dual por drop-in:
  `canales=2 dec=64`, ESTADO con el IN2, CSV en `/mnt/usb/eventos/in2/`,
  resumen con `kurt_max_1min_in2` 3.072 y `area_max_1min_in2` 0.5705.
  - GCS en la placa de pruebas está deshabilitado por config
    (`gcs.habilitado: false`): el timer corría pero no subía nada ("no se
    sube nada" cada 5 min hasta las 18:06). El reinicio de las 18:11 solo lo
    dejó parado (no estaba habilitado al arranque); no se perdió ninguna
    subida. Para ver el IN2 en el bucket: `/root/prueba_eth0/subir_in2_prueba.py
    AAAAMMDD_HH [--subir]` (sube solo esa hora del IN1 y del IN2, sin tocar
    la config).
- 2026-10-06, etapa 8 (parte): escritura sostenida con los dos sensores
  disparando (`fase1_dual.sh W15in2 900 3.03 2 64`, 19:17-19:32 UTC): IN1
  702 + IN2 1125 eventos (~2 ev/s, ~6x el peor caso de campo de un sensor),
  todos bien formados en su carpeta, 0 fallidos, 0 perdidos, 0 saltadas,
  `otra_ventana` 0, CSV 17999 filas cada uno; pérdidas del stream 0.00056%,
  deriva máx. ~33ms (W15d64 con un solo escritor: 0.00045%, ~28ms). El
  segundo escritor no cambia nada medible.
- 2026-10-06, etapa 8 (parte): **ensayo de vuelta atrás completa** en
  `rp-f0fd8c` (19:37 UTC). Versión de campo = tag `campo-2026-10-05b`
  (`capturar_eventos.cpp/.py`, `resumen_modo_evento.py`,
  `subir_csv_gcs.py`, `supervisor_eventos.sh`, unit; binario compilado en
  la placa en `/root/rollback_campo/`) + bitstream `7f23f7d`, sin drop-in de
  dual. Anduvo como campo: log viejo (sin "Pasabanda"/"Ventana" ni
  canales), mono dec32, 100% muestras, 0 saltadas, CSV de 6 columnas,
  resumen sin `me_canales`, área ~0.515. Vuelta a lo nuevo
  (`/root/nuevo_in2/` + bitstream IN2 + `canales.conf`, 19:38): dual dec64
  con el IN2 al toque. El CSV de la hora 19 del IN1 quedó con filas de 6 y
  7 columnas mezcladas (los lectores de la PC lo soportan).
- 2026-10-16, **etapa 5 (T de OUT1 a IN1 + IN2)** en `rp-f0fd8c`, 19:05-19:39
  UTC. Jumpers de IN1 e IN2 en **LV** (el binario igual pide `A_1_20`/HV al
  streaming: no afecta, las sumas de la FPGA son cuentas crudas y la
  kurtosis no depende de la escala). Bitstream `b34cd26f`, binario
  `74b88bb2`. Script de lab `/root/prueba_eth0/etapa5_t.sh NOMBRE partes`
  (no versionado, como los otros de `prueba_eth0`): dual, IN2
  independiente, umbral 3.4/3.4, para `modo-evento` al empezar y lo vuelve
  a arrancar al terminar. Logs `etapa5_T1.log` (humo), `etapa5_T2.log`
  (reposo, p64, p32, arena), `etapa5_T3.log` (tonos); datos en
  `/mnt/usb/etapa5_T*`. Comparación ventana por ventana con
  `analisis/placa/comparar_in1_in2.py` (cruza por `window_count`).
  - **OUT1 físico anda con el bitstream del IN2** (el comentario del C++
    de que no andaba era del bitstream etapa7).
  - Pulsos por OUT1, siempre en la **misma ventana** en IN1 e IN2, kurtosis
    ~3600 en los dos: humo 4/4, p64 20/20, p32 14/14 (los otros 6 cayeron
    en ventanas saltadas por sobrecarga de escritura, ver ruido abajo).
  - Arena (tramo real 144456, `--dac-escala 8`, dec64): 205 ventanas
    >= 3.4 en los dos, **ninguna en un solo canal**; kurtosis máx. 203.7
    (IN1) / 203.5 (IN2).
  - Ganancia IN2/IN1 con la señal dominando: 0.977-0.991 (diferencia
    normal entre entradas, constante con la frecuencia, ver tonos).
  - **Ruido externo intermitente** durante la tanda T2 (también en
    `modo-evento` entre corridas: 19:02-19:03, 19:05, 19:08-19:19; limpio
    19:04, en el humo y 19:20): kurtosis de reposo IN1 4.6 / IN2 3.6, área
    IN2/IN1 0.84 -> casi toda ventana es evento. Llega más fuerte al IN1.
    Por eso p64 da 174 ventanas "solo IN1" (ruido, no pulsos) y el
    **reposo de esta tanda no sirve**: repetirlo con el ambiente limpio.
    No se investigó el origen (decisión del usuario).
  - **Forma de banda con tonos** (pendiente de la Fase 1b de
    `docs/plan_dos_canales.md`): `analisis/placa/tonos_banda.py generar`
    -> `tonos.bin` (marcador 150 kHz + 20 tonos de 5 a 900 kHz, 0.4 s
    cada uno, amplitud 12000, DAC a 3906250 Hz), partes `tonos` (dec64) y
    `tonos32` (dec32) del script. Área por tono relativa a 150 kHz contra
    el diseño (Butterworth orden 2, 50-400 kHz, Q20):

    | | 50-400 kHz vs diseño | -3 dB en 50k / 400k | IN2 vs IN1 |
    |---|---|---|---|
    | dec64 | máx. 0.19 dB | -2.9 / -3.2 dB | <= 0.15 dB (0.991 constante) |
    | dec32 | máx. 1.3 dB | -2.9 / -1.7 dB | <= 0.01 dB |

    dec64 confirma medido que los coeficientes que escribe el C++ dan la
    banda diseñada (antes solo había lectura de registros + RTL). dec32 queda
    limitado por la medición: el DAC por red tuvo cortes en esa corrida y
    la meseta de referencia de 150 kHz salta 0.6 dB; además dec32 mono es
    la configuración que ya corre en campo. Arriba de 600 kHz la medición
    se aparta 2-5 dB a -20/-40 dB (piso/decimador del vendor; fuera de la
    banda de análisis). Hallazgo de método: el DAC por red **no respeta una
    grilla fija de tiempo** (cortes y corrimientos de algunas ventanas): el
    análisis separa por mesetas. Los 141 eventos de la corrida dec64 son
    transitorios de esos cortes (artefacto de la prueba).
  - Decisión vigente que esto respalda: **mono = dec32, dual = dec64**.
  - Placa al terminar: `modo-evento` activo, **jumpers en LV y T puesto**
    (volver a HV para capturar como campo).
- 2026-10-19, **reposo dual con el T, ambiente limpio** (cierra el reposo
  que no sirvió el 16/10). No se corrió `etapa5_t.sh`: `modo-evento` quedó
  capturando todo el fin de semana con el T puesto y jumpers en **HV**
  (dual, IN2 independiente, umbral 3.4/3.4), así que se usaron los CSV de
  ventanas de `/mnt/usb/eventos` (IN1) y `eventos/in2`:

  | Día | Ventanas c/canal | Kurtosis media IN1 / IN2 | Máx. IN1 / IN2 | Eventos >= 3.4 | Área IN1 / IN2 |
  |---|---|---|---|---|---|
  | 17/10 | 1727985 | 3.006 / 3.010 | 3.11 / 3.11 | 0 / 0 | 0.565 / 0.550 |
  | 18/10 | 1727985 | 3.005 / 3.010 | 3.10 / 3.10 | 0 / 0 | 0.565 / 0.550 |
  | 19/10 (0-12 UTC) | ~872000 | 3.004 / 3.012 | 5.05 / 3.99 | 1 / 1 | 0.566 / 0.550 |

  - Cero ventanas con estado distinto de `ok` en los dos canales.
  - Ningún evento de un solo canal: el único (19/10 11:48:40 UTC) cae en
    la misma ventana en IN1 e IN2 (externo).
  - Área IN2/IN1 en reposo 0.973, coherente con la ganancia 0.977-0.991
    medida con señal (con el ruido del 16/10 había bajado a 0.84).
  - Sin muestra cruda ventana por ventana (`comparar_in1_in2.py`): para
    la pregunta del reposo alcanzan ~3.5 millones de ventanas por canal.
