fvilla-edge/Sand-Monitoring/scripts_campo/plan_campo/setup_placa.md

# Setup inicial en la placa (una sola vez)

Estos pasos se hacen una vez por placa. Después de un reset de firmware hay que repetirlos.
IPs según topología de red: ver `../PLAN_CAMPO.md` → "IPs según topología de red".

> **Alcance (2026-11-02):** esto es el setup **base** de la placa (librería de
> streaming, USB, journal, SSH, relé, RTC, panel solar). Lo que corre hoy en campo
> — modo evento (`modo-evento`, `resumen-modo-evento`, `subir-csv-gcs`), bitstream
> propio, modos de Starlink ventana/permanente, cambio de canales, registro de energía —
> se instala **por paquete** sobre una placa ya preparada: `actualizar_placa_campo.md`
> secciones 6 (procedimiento) y 7 (paquete integrado). El paquete exige USB montado y
> Starlink en permanente, así que va después de estos pasos. [No ensayado sobre una
> placa recién flasheada: la última instalación completa fue sobre la de campo, que
> ya tenía el setup base.]
>
> El paso 1 copia lo mínimo del **modo clásico** (`capturar_stream.py`); con el paquete
> eso se pisa con el árbol completo de `scripts_campo/`.

## 1. Copiar los scripts a la placa

```bash
scp scripts_campo/capturar_stream.py scripts_campo_comun/campo_common.py root@<IP_PLACA>:/root/scripts_campo/
scp scripts_campo_comun/relanzar_captura.sh root@<IP_PLACA>:/root/scripts_campo_comun/
scp scripts_campo_comun/cfg.py scripts_campo_comun/config_campo.json root@<IP_PLACA>:/root/scripts_campo_comun/
```

`cfg.py` tiene que vivir junto a `config_campo.json` en `/root/scripts_campo_comun/` — esa ruta
está hardcodeada tanto en los scripts Python (`sys.path.insert(0, '/root/scripts_campo_comun')`
en `capturar_stream.py`) como en los de Starlink (`CFG=/root/scripts_campo_comun/cfg.py` en
`control_starlink.sh` y `decidir_objetivo.sh`), y `cfg.py` busca `config_campo.json` en su propio
directorio. Sin este paso, la captura falla en el primer arranque con
`ModuleNotFoundError: No module named 'cfg'`.

## 2. Librería de streaming — persistencia automática

La placa tiene un servicio systemd (`rpsa-lib`) que extrae automáticamente la librería
`rpsa_client` al arrancar si no está presente. No hay que hacer nada en cada reinicio.

**Verificar que está activo:**
```bash
ssh root@<IP_PLACA> "systemctl is-enabled rpsa-lib && ls /root/rpsa_client/python_lib/_python_lib.so"
# Debe responder: enabled + la ruta del archivo
```

**Si la placa fue reflasheada** (firmware nuevo), reinstalar el servicio:
```bash
ssh root@<IP_PLACA> "
unzip -o /opt/redpitaya/streaming/rpsa_client-*-rp.zip -d /root/rpsa_client/
cat > /etc/systemd/system/rpsa-lib.service << 'EOF'
[Unit]
Description=Extract RPSA streaming library
Before=network.target
ConditionPathExists=!/root/rpsa_client/python_lib/_python_lib.so

[Service]
Type=oneshot
ExecStart=/bin/sh -c 'unzip -o /opt/redpitaya/streaming/rpsa_client-*-rp.zip -d /root/rpsa_client/'
RemainAfterExit=yes

[Install]
WantedBy=multi-user.target
EOF
systemctl daemon-reload && systemctl enable rpsa-lib.service"
```

## 2b. Interfaz `dummy0` — discovery de streaming resiliente a cortes de `eth0` (2026-09-22)

**Por qué hace falta:** el cliente (`capturar_stream.py`) y el `streaming-server` — aunque
corren en la MISMA placa — no se conectan por `127.0.0.1` ni por hostname/DNS/avahi. Se
descubren por un **broadcast UDP propio del vendor**: el servidor manda cada 1s un paquete a
`255.255.255.255:18902` anunciando su MAC/IP, y el cliente escucha ese broadcast para saber a
qué IP conectarse por TCP (puerto 18901). Confirmado con `strace -f -e trace=network`.

Si `eth0` no tiene una ruta válida (cae la interfaz, se pierde el lease DHCP durante el corte de
apagado del relé de Starlink, etc.), ese `sendto()` falla con `ENETUNREACH` — el cliente nunca
ve el anuncio y la captura entera falla con `ERROR: no se pudo conectar al streaming-server` /
`Host not found` (mensaje genérico del vendor, **no** es un error real de DNS pese al nombre).
Sin esta interfaz, una captura larga que atraviesa un apagado del relé de Starlink agota los 10 reintentos
del supervisor y **abandona el lote entero** — pasó de verdad en `rp-f0fbda` el 2026-09-21.

**Fix:** una interfaz `dummy0` local, siempre arriba, con su propia IP, le da a ese broadcast un
camino que no depende de `eth0`. Es aditivo — no toca `eth0`, el relé ni la configuración de
Starlink existente.

```bash
ssh root@<IP_PLACA> "cat > /etc/systemd/network/25-dummy-discovery.netdev << 'EOF'
[NetDev]
Name=dummy0
Kind=dummy
EOF
cat > /etc/systemd/network/25-dummy-discovery.network << 'EOF'
[Match]
Name=dummy0

[Network]
Address=10.250.250.1/24
LinkLocalAddressing=no

[Route]
Destination=255.255.255.255/32
EOF
networkctl reload"
```

**Verificar que quedó activa:**
```bash
ssh root@<IP_PLACA> "networkctl status dummy0 && ip route show | grep 255.255.255.255"
```

**Validado (2026-09-22, en `rp-f0fd8c` y `rp-f0fbda`):** con `eth0` completamente abajo 150s y
una captura corriendo de fondo, 0 fallos (antes: 10/10 fallos y abandono del lote). En operación
normal (`eth0` arriba, sin corte), 3 capturas de sanidad espaciadas 60s dieron 92%/84%/91% de
eficiencia — igual que sin `dummy0`, no interfiere.

**Trampa de testing, si se repite esta validación:** lanzar capturas de prueba en ráfaga rápida
(cada pocos segundos, sin pausa) puede dejar un `streaming-server` residual corriendo y dar
`Operation aborted`/baja eficiencia — esto es un punto débil ya conocido del vendor con
reconexiones muy seguidas, **no** un síntoma de que `dummy0` esté mal. Espaciar las pruebas
al menos 45-60s entre sí.

**Si la placa fue reflasheada:** esta interfaz no sobrevive un reflash (solo el `.so` de la
librería de streaming se restaura solo, vía el servicio del paso 2) — repetir este paso.

## 3. Montaje automático del USB (una sola vez)

Evita tener que hacer `lsblk` + `mount` a mano cada vez que se reconecta la placa o el
storage — apenas el kernel detecta la partición (`sd[a-z][0-9]`), una unidad systemd
dispara el montaje en `/mnt/usb`; al desconectarla, la misma unidad se para sola
(`BindsTo=dev-%i.device`) y su `ExecStop` libera el punto de montaje.

```bash
scp scripts_campo_comun/automount_usb.sh root@<IP_PLACA>:/root/scripts_campo_comun/
scp scripts_campo_comun/udev-automount/99-automount-campo.rules root@<IP_PLACA>:/etc/udev/rules.d/
scp scripts_campo_comun/udev-automount/mnt-usb-automount@.service root@<IP_PLACA>:/etc/systemd/system/

ssh root@<IP_PLACA> "
chmod +x /root/scripts_campo_comun/automount_usb.sh
udevadm control --reload-rules
systemctl daemon-reload
"
```

**Probar sin desconectar nada** (dispara el mismo evento que un hotplug real —
ajustar `sda1` según lo que muestre `lsblk`):

```bash
ssh root@<IP_PLACA> "udevadm trigger --action=add /sys/class/block/sda1 && sleep 2 && df -h /mnt/usb"
```

**Si algo no monta:** revisar el log dedicado (separado de `logs_campo/log_*.txt` de
captura, mismo directorio):

```bash
ssh root@<IP_PLACA> "cat /root/logs_campo/automount_usb.log"
```

Si el filesystem es exFAT, `exfatprogs` tiene que estar instalado en la placa (ver
"El USB no aparece con lsblk, o aparece pero no monta" en `troubleshooting.md`) — sin eso
`mount` falla silenciosamente para ese tipo de filesystem y queda registrado en el log.
Solo monta un dispositivo a la vez: si `/mnt/usb` ya está ocupado, el script lo deja
así y no pisa nada (ver el log para confirmarlo).

**Por qué no hay una unidad separada de desmontaje:** `systemd` ignora
`ENV{SYSTEMD_WANTS}` en eventos `remove` (solo lo procesa en `add`/`change` — limitación
documentada, no un bug de la regla). Por eso el desmontaje no se dispara con una segunda
regla udev sino con `BindsTo=` + `ExecStop=` en la misma unidad de montaje: cuando el
device unit desaparece, `systemd` para la unidad automáticamente y corre el `ExecStop`.

## 3b. Desactivar autosuspend en los hubs USB (una sola vez)

Sin esto, el kernel puede autosuspender el root hub o el hub externo alimentado a mitad
de una escritura pesada — visto en campo como `cannot reset (err=-110)` / "Maybe the USB
cable is bad?" en los puertos, journal de ext4 abortado, y en el peor caso el hub sin
volver a enumerar hasta un reboot físico de la placa (ver "El USB/SSD se desconecta solo"
en `troubleshooting.md`).

```bash
scp scripts_campo_comun/udev-automount/90-usb-autosuspend-hubs.rules root@<IP_PLACA>:/etc/udev/rules.d/

ssh root@<IP_PLACA> "
udevadm control --reload
udevadm trigger --action=add --subsystem-match=usb
cat /sys/bus/usb/devices/1-1/power/control /sys/bus/usb/devices/usb1/power/control
"
```

Ambos deben quedar en `on`. La regla matchea por `bDeviceClass==09` (clase hub) en vez
de por nombre de dispositivo (`usb1`, `1-1`), porque el devpath puede cambiar entre
boots — cubre el root hub y cualquier hub externo que se conecte, y se re-aplica sola en
cada `add` (incluido el boot), sin necesitar `echo on` a mano.

## 3c. Journal persistente en la SD (una sola vez)

`/var/log` es un tmpfs de 5MB a propósito (no desgastar la SD), así que por defecto el
journal vive en RAM: se pierde en cada reboot y rota en ~1 día. Sin esto no queda
rastro de un problema de un fin de semana ni del arranque anterior a una caída.
Se monta un directorio de la SD sobre `/var/log/journal` y se limita el tamaño.

**Por qué en la SD y no en el USB:** el USB lo monta `mnt-usb-automount@` recién
después de `systemd-journal-flush`, así que se perderían justo los primeros segundos del
arranque, y si el disco se desconecta journald queda con archivos abiertos en un
dispositivo que ya no existe. El volumen es chico (~8MB/día medido en modo evento).

```bash
ssh root@<IP_PLACA> '
cp -a /etc/fstab /etc/fstab.bak.$(date -u +%Y%m%d_%H%M%S)
mkdir -p /var/lib/journal-persist /etc/systemd/journald.conf.d
grep -q journal-persist /etc/fstab || echo "/var/lib/journal-persist /var/log/journal none bind,nofail,x-systemd.makedirs 0 0" >> /etc/fstab
printf "[Journal]\nStorage=persistent\nSystemMaxUse=200M\n" > /etc/systemd/journald.conf.d/persistente.conf
systemctl daemon-reload
mkdir -p /var/log/journal && mount /var/log/journal
systemctl restart systemd-journald && journalctl --flush
findmnt /var/log/journal
'
```

Verificar con un reboot real: `journalctl --list-boots` tiene que mostrar el arranque
anterior. La primera entrada de cada boot puede aparecer con fecha vieja (sin RTC la
hora se corrige después, por NTP). Reiniciar `systemd-journald` no corta los servicios
que están corriendo (probado con modo evento: 0 reinicios, 100% muestras).
La placa de campo (`rp-f0fbda`) tiene lo mismo desde el 2026-08-03 pero con
`SystemMaxUse=50M` (~6 días); la de pruebas usa 200M (~25 días).

## 4. Setup para modo RED (solo si se usa `--destino red`)

La placa necesita poder conectarse a la PC por SSH sin password.
Hacer esto desde la PC:

```bash
# 1. Asegurarse de que la PC tiene servidor SSH instalado
sudo apt install openssh-server
sudo systemctl start ssh

# 2. Copiar la clave pública de la placa a la PC
ssh-copy-id -i <(ssh root@<IP_PLACA> "cat ~/.ssh/id_rsa.pub") facu-edge@<IP_PC>
```

Verificar que funciona:

```bash
ssh root@<IP_PLACA> "ssh facu-edge@<IP_PC> 'echo OK'"
# Debe imprimir OK sin pedir contraseña
```

Crear el directorio destino en la PC **antes de correr el script** (SCP falla si no existe):

```bash
mkdir -p ~/datos_campo
```

## 4b. Hardening SSH + verificar que `fail2ban` banea de verdad (si la placa queda expuesta a internet, ej. detrás de Starlink)

Ver el detalle completo, root cause y contexto en `../../starlink_remoto/HISTORIAL_STARLINK.md`
→ "`fail2ban` nunca baneó nada de verdad — el kernel de esta placa no soporta `nftables`".

Después de instalar `PasswordAuthentication no` + `fail2ban` (jail `sshd`, backend `systemd`,
`maxretry=5`), **no asumir que ya banea de verdad** — los kernels custom de Red Pitaya/Zynq
suelen no traer `nftables` (`banaction` por defecto de `fail2ban`) ni el módulo `multiport` de
`iptables`. Verificar y arreglar:

```bash
ssh root@<IP_PLACA> "
# 1. iptables legacy (funciona sin nftables/multiport/REJECT)
update-alternatives --set iptables /usr/sbin/iptables-legacy
update-alternatives --set ip6tables /usr/sbin/ip6tables-legacy

# 2. jail.local con banaction=iptables (no multiport) + blocktype=DROP explícito
cat > /etc/fail2ban/jail.local << 'EOF'
[DEFAULT]
ignoreip = 127.0.0.1/8 ::1 <IP de confianza, ej. la de tu oficina>
banaction = iptables
banaction_allports = iptables-allports
blocktype = DROP
action_ = %(banaction)s[blocktype=%(blocktype)s, port=\"%(port)s\", protocol=\"%(protocol)s\", chain=\"%(chain)s\"]

[sshd]
enabled = true
backend = systemd
maxretry = 5
findtime = 600
bantime = 600
EOF
systemctl restart fail2ban
"
```

`ignoreip` con una IP tuya de confianza es importante — sin eso, tu propia sesión SSH puede
autobanearse (el filtro cuenta cada clave rechazada de un `ssh-agent` con varias identidades
como intento fallido). `bantime=600` (10 min, no el default de 1h) es la red de seguridad si
esa IP algún día deja de ser la tuya.

**Probar antes de confiar en el mecanismo** (IP de documentación, RFC 5737, nunca se conecta
de verdad):

```bash
ssh root@<IP_PLACA> "
fail2ban-client set sshd banip 203.0.113.1
iptables -L f2b-sshd -n -v   # debe aparecer una regla DROP para 203.0.113.1
fail2ban-client set sshd unbanip 203.0.113.1
iptables -L f2b-sshd -n -v   # la regla debe desaparecer
"
```

## 5. Starlink / control remoto del relé (si esta placa lo maneja)

Arquitectura, hallazgos de hardware y decisiones: `../../starlink_remoto/HISTORIAL_STARLINK.md`.
Depende de `cfg.py`/`config_campo.json` del paso 1 — no hace falta copiarlos de nuevo (si por algún
motivo se instala Starlink solo, sin el resto de este setup, copiarlos igual desde el paso 1 antes
de seguir).

```bash
cd starlink_remoto

# scripts + configuracion de mux compartida + boot + modo/ventana + decision/aplicacion + estado
scp control_starlink.sh mux_ps10_common.sh asegurar_mux_ps10.sh \
    modo_operacion.sh modo_operacion_common.sh ventana_starlink.sh \
    decidir_objetivo.sh aplicar_objetivo.sh starlink_manual.sh estado_starlink.sh \
    root@<IP_PLACA>:/root/starlink_remoto/

# unidades systemd
scp systemd/starlink-mux-ps10.service systemd/starlink-aplicar-objetivo.service \
    systemd/starlink-reconciliador.service \
    systemd/starlink-ventana.service systemd/starlink-ventana.timer \
    systemd/starlink-reconciliador.timer \
    root@<IP_PLACA>:/etc/systemd/system/

ssh root@<IP_PLACA> "
  chmod +x /root/starlink_remoto/*.sh
  systemctl daemon-reload
  systemctl enable --now starlink-mux-ps10.service
  /root/starlink_remoto/modo_operacion.sh permanente   # mientras se instala; despues ventana desde Losant
  systemctl enable --now starlink-ventana.timer
  systemctl enable --now starlink-reconciliador.timer
"

# alias para prender/apagar/consultar a mano por SSH (opcional, comodidad)
scp aliases.sh root@<IP_PLACA>:/root/starlink_remoto/
ssh root@<IP_PLACA> "grep -q 'prender-starlink' /root/.bashrc || cat /root/starlink_remoto/aliases.sh >> /root/.bashrc"
```

El modo queda en permanente para no cortar el acceso mientras se termina el armado; al
terminar se pasa a ventana desde Losant (tag `modo_starlink`) o con
`modo_operacion.sh ventana`. El `OnCalendar=` de `starlink-ventana.timer` es estático
(cada 2 h a los :05): si se cambia `starlink.ventana_cada_h`/`ventana_minuto`, editarlo tambien.

Uso día a día (prender/apagar a mano, cambiar el modo, etc.): ver `COMANDOS.md` →
"Starlink / control remoto del relé".

## 5b. RTC DS3231 (si esta placa lo tiene cableado)

Cableado real en `rp-f0fbda`: bus I2C 0 (compartido con la EEPROM de identificación de
modelo, dirección `0x50` — agregar el DS3231 en paralelo por las mismas líneas SDA/SCL
no la afecta, verificado en HW), dirección `0x68`. Detalle completo, por qué terminó en
ese bus y las pruebas hechas: `rtc_ds3231/probar_rtc.py` (script de diagnóstico manual)
y la memoria del proyecto, sec. RTC DS3231.

Depende de `cfg.py`/`config_campo.json` del paso 1 (clave nueva `rtc_ds3231.bus`/
`rtc_ds3231.direccion`) — no hace falta copiarlos de nuevo salvo que se haya editado
`config_campo.json` desde entonces.

```bash
cd rtc_ds3231

scp ds3231.py leer_epoch.py restaurar_hora.sh probar_rtc.py \
    root@<IP_PLACA>:/root/rtc_ds3231/

scp systemd/rtc-restaurar.service \
    root@<IP_PLACA>:/etc/systemd/system/

ssh root@<IP_PLACA> "
  chmod +x /root/rtc_ds3231/*.sh /root/rtc_ds3231/*.py
  systemctl daemon-reload
  systemctl enable --now rtc-restaurar.service
"
```

No hay guardado periódico del sistema hacia el RTC (se evaluó y se descartó a propósito:
el DS3231 ya tiene compensación de temperatura, ~1 min/año de desfasaje típico según su
datasheet — insignificante contra un horario que se maneja en ventanas de HH:MM y que el
reconciliador reevalúa cada 5 min. No vale la pena el mecanismo extra).

Verificar que el chip responde antes de instalar el servicio (si no, `rtc-restaurar`
loguea una advertencia y no bloquea el boot, pero conviene saberlo de entrada):

```bash
ssh root@<IP_PLACA> "i2cdetect -y 0; python3 /root/rtc_ds3231/probar_rtc.py"
```

**No toca** `decidir_objetivo.sh` ni la lógica de rescate del relé (`NTPSynchronized`)
— eso sigue funcionando exactamente igual que sin RTC, es una fase aparte.

## 6. Panel solar por BLE (ESP32-C3, si esta placa lo lee)

Arquitectura, por qué hace falta un ESP32-C3 como puente (la Pitaya no tiene Bluetooth
en el kernel) y el detalle de qué copiar/instalar/correr: `../../panel_solar_ble/README.md`.

Punto no obvio, documentado ahí con más detalle: instalar dependencias con
`pip install victron-ble` a secas rompe por falta de RAM en esta placa (intenta compilar
`bleak`/`dbus-fast` desde código fuente) — usar `--no-deps` + instalar las dependencias
reales sueltas, como indica ese README. Lo mismo para publicar en Losant
(`publicar_losant.py`): necesita un pin de `setuptools<81` (`pkg_resources` deprecado en
versiones nuevas), también documentado ahí.

Servicio systemd que publica el informe a Losant cuando hay conexión y cada
`panel_solar.informe_intervalo_min` mientras siga conectado (arranca solo con la placa,
se reinicia si se cae — ver comentarios de
`panel_solar_ble/systemd/panel-solar-informe.service` para el porqué de sus opciones).
Depende de `cfg.py`/`config_campo.json` del paso 1 (mismo archivo que usa
`starlink_remoto/`) — no hace falta copiarlos de nuevo salvo que `config_campo.json` se
haya editado desde entonces:

```bash
cd panel_solar_ble

# scripts (config.py y losant_config.py se copian aparte, ver README paso 2/5)
scp puerto.py victron_scanner.py leer_smartsolar_serial.py publicar_losant.py \
    root@<IP_PLACA>:/root/panel_solar_ble/

# unidad systemd
scp systemd/panel-solar-informe.service root@<IP_PLACA>:/etc/systemd/system/

ssh root@<IP_PLACA> "
  systemctl daemon-reload
  systemctl enable --now panel-solar-informe.service
"
```

Uso día a día (ver estado, logs, correr a mano para debuggear): ver `COMANDOS.md` →
"Panel solar por BLE".
