fvilla-edge/Sand-Monitoring/Click_shield_for_Red_Pitaya_v102_Schematic.pdf

# Red Pitaya Click Shield schematic v102

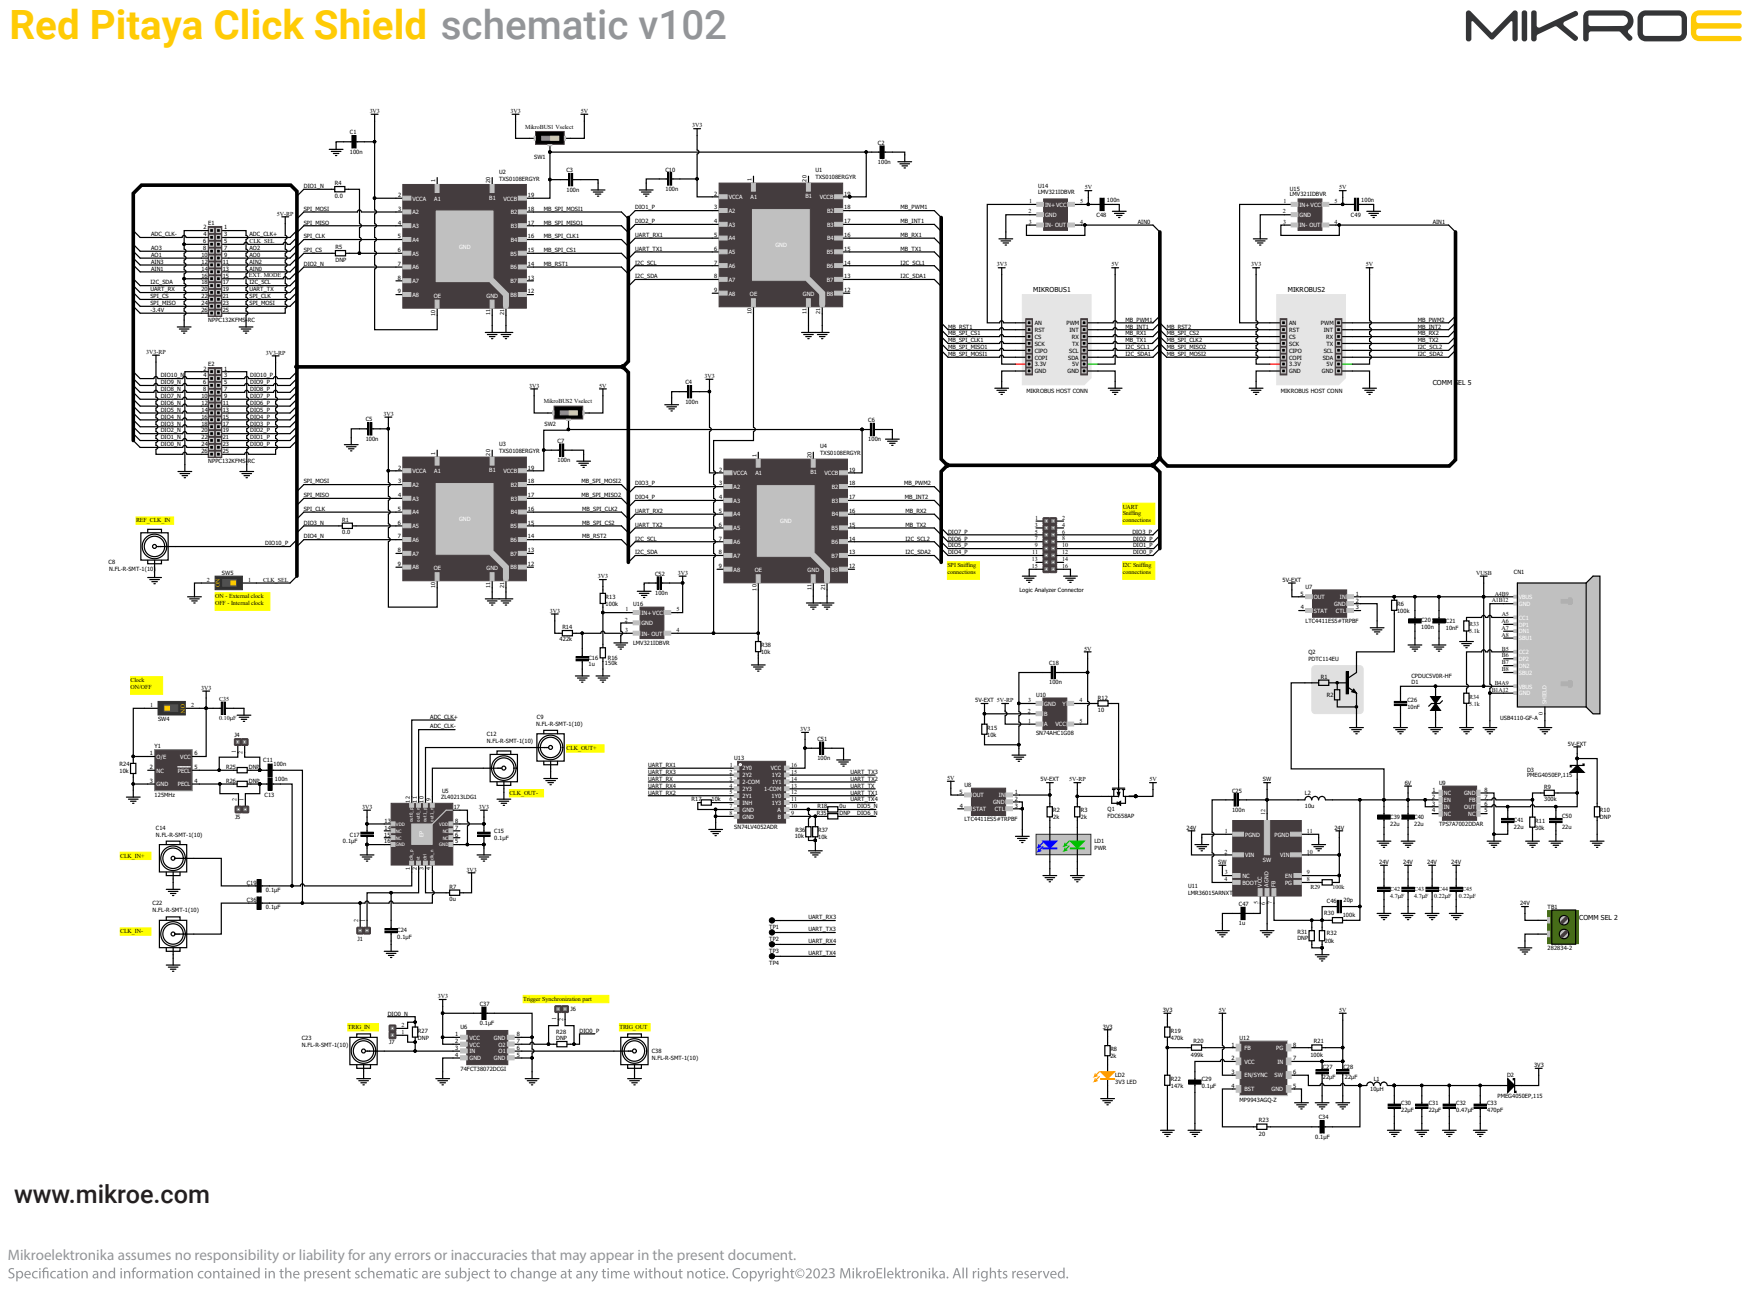
[picture p2: page 1]

GND 5 NC 6 NC 7 VDD o

Mikroelektronika assumes no responsibility or liability for any errors or inaccuracies that may appear in the present document.
