fvilla-edge/Sand-Monitoring/panel_solar_ble/balance_energia.py

"""
Balance de energia (docs/plan_perfiles_energia.md, etapa 2).

registro_energia.py le pasa cada fila de minuto que escribe; con eso se
lleva el SOC de la bateria por conteo de Ah, la energia de la hora y del
dia, y los consumos promedio con y sin Starlink. Al cerrar cada hora deja
un resumen en la cola del cartero (publicar_losant.py lo manda a Losant con
su hora original, igual que los del modo evento).

- SOC: cada minuto soc_ah += i_bat / 60 (i_bat es la corriente NETA de la
  bateria), limitado a 0..capacidad_ah. Float SOSTENIDO = 100 %: el MPPT
  dice "float" FLOAT_MINUTOS minutos seguidos con v_bat_min >= FLOAT_V_MIN
  y i_bat >= FLOAT_I_MIN. Solo "float" no alcanza: en campo (8/10 18:38 UTC)
  lo reporto 4 minutos descargando, con la bateria casi vacia. En una
  LiFePO4 la tension casi no se mueve entre ~20 y ~90 %, por eso se cuenta.
- Al arrancar se usa el ultimo SOC guardado: si la placa estuvo apagada
  porque se corto la salida LOAD, la bateria solo pudo cargarse, asi que es
  una cota inferior. Sin estado previo arranca en 50 %, no confiable.
- "Confiable" = hubo float en los ultimos DIAS_CONFIABLE dias.
- Promedios de consumo: media movil exponencial por minuto (~7 dias), con
  valores de partida del historial del MPPT (base ~7,5 W, Starlink +20 W).
- Dia local = UTC-3 (Argentina, sin horario de verano).
- El estado va a la SD con escritura atomica + fsync en cada minuto: el
  corte de LOAD apaga la placa sin aviso.
"""
import json
import os
from datetime import datetime, timedelta, timezone

DIAS_CONFIABLE = 7
TAU_PROMEDIO_MIN = 7 * 24 * 60      # media movil de ~7 dias
FLOAT_MINUTOS = 10                  # minutos seguidos para creerle al float
FLOAT_V_MIN = 13.3                  # V: float LFP del MPPT 13,5; vacia ~12,7
FLOAT_I_MIN = -0.1                  # A: en float el panel cubre las cargas
LOCAL = timezone(timedelta(hours=-3))
VERSION_ESTADO = 1


def _float(fila, clave):
    try:
        return float(fila[clave])
    except (KeyError, TypeError, ValueError):
        return None


def horas_starlink(modo, ventana_cada_h, ventana_duracion_min):
    """Horas por dia con Starlink prendida segun el modo (docs/plan_modos_starlink.md):
    permanente = 24; ventana = una ventana de ventana_duracion_min cada
    ventana_cada_h horas (12 x 10 min = 2 h con los valores de diseno)."""
    if modo == "permanente":
        return 24.0
    return 24 / ventana_cada_h * ventana_duracion_min / 60


class BalanceEnergia:
    def __init__(self, estado_file, dir_pendientes, capacidad_ah=100.0,
                 capacidad_util_wh=1150.0, p_base_w=7.5, p_starlink_w=20.0,
                 horas_sl=8 + 20 / 60):
        self.estado_file = estado_file
        self.dir_pendientes = dir_pendientes   # funcion -> carpeta del ultimo resumen (publicar_losant ULTIMO_DIR)
        self.capacidad_ah = capacidad_ah
        self.capacidad_util_wh = capacidad_util_wh
        self.horas_sl = horas_sl
        self.e = self._cargar() or {
            "version": VERSION_ESTADO,
            "soc_ah": capacidad_ah / 2,
            "ultimo_float": None,          # epoch del ultimo minuto en float
            "float_racha": 0,              # minutos seguidos que cumplen el float
            "hora": None,                  # epoch del inicio de la hora que se acumula
            "acum": self._acum_vacio(),
            "dia_local": None,
            "balance_dia_wh": 0.0,
            "p_sin_sl_w": p_base_w,
            "p_con_sl_w": p_base_w + p_starlink_w,
        }

    @staticmethod
    def _acum_vacio():
        return {"minutos": 0, "starlink_min": 0, "e_carga_wh": 0.0,
                "e_pv_wh": 0.0, "e_bat_wh": 0.0, "v_min": None}

    def _cargar(self):
        try:
            with open(self.estado_file) as f:
                e = json.load(f)
        except (OSError, ValueError):
            return None
        return e if isinstance(e, dict) and e.get("version") == VERSION_ESTADO else None

    def _guardar(self):
        carpeta = os.path.dirname(self.estado_file) or "."
        os.makedirs(carpeta, exist_ok=True)
        tmp = self.estado_file + ".tmp"
        with open(tmp, "w") as f:
            json.dump(self.e, f)
            f.flush()
            os.fsync(f.fileno())
        os.replace(tmp, self.estado_file)
        fd = os.open(carpeta, os.O_RDONLY)
        try:
            os.fsync(fd)
        finally:
            os.close(fd)

    def minuto(self, fila, minuto):
        """Procesa la fila de un minuto (dict de strings, columnas de
        registro_energia.COLUMNAS). minuto = epoch // 60."""
        v, i_bat = _float(fila, "v_bat"), _float(fila, "i_bat")
        if v is None or i_bat is None:
            return                                 # minuto solo con lecturas basura
        i_carga = _float(fila, "i_carga") or 0.0
        p_panel = _float(fila, "p_panel") or 0.0
        v_min = _float(fila, "v_bat_min") or v
        starlink = fila.get("starlink") == "on"
        t = minuto * 60
        e = self.e

        hora = t - t % 3600
        if e["hora"] is not None and hora != e["hora"]:
            self._cerrar_hora()
        e["hora"] = hora
        dia = datetime.fromtimestamp(t, LOCAL).strftime("%Y-%m-%d")
        if dia != e["dia_local"]:
            e["dia_local"], e["balance_dia_wh"] = dia, 0.0

        # SOC
        if (fila.get("estado_carga") == "float" and v_min >= FLOAT_V_MIN
                and i_bat >= FLOAT_I_MIN):
            e["float_racha"] = e.get("float_racha", 0) + 1   # estados viejos sin la clave
        else:
            e["float_racha"] = 0
        if e["float_racha"] >= FLOAT_MINUTOS:
            e["soc_ah"], e["ultimo_float"] = self.capacidad_ah, t
        else:
            e["soc_ah"] = min(self.capacidad_ah, max(0.0, e["soc_ah"] + i_bat / 60))

        # energia del minuto
        p_carga = v * i_carga
        a = e["acum"]
        a["minutos"] += 1
        a["starlink_min"] += starlink
        a["e_carga_wh"] += p_carga / 60
        a["e_pv_wh"] += p_panel / 60
        a["e_bat_wh"] += v * i_bat / 60
        a["v_min"] = v_min if a["v_min"] is None else min(a["v_min"], v_min)
        e["balance_dia_wh"] += v * i_bat / 60

        # consumo promedio con / sin Starlink
        clave = "p_con_sl_w" if starlink else "p_sin_sl_w"
        e[clave] += (p_carga - e[clave]) / TAU_PROMEDIO_MIN

        self._guardar()

    def soc_pct(self):
        return 100 * self.e["soc_ah"] / self.capacidad_ah

    def soc_confiable(self, ahora):
        f = self.e["ultimo_float"]
        return f is not None and ahora - f <= DIAS_CONFIABLE * 86400

    def resumen(self, ahora):
        """Atributos en_* para Losant con el estado actual (sin los de la hora)."""
        e = self.e
        restante = self.soc_pct() / 100 * self.capacidad_util_wh
        dia_con_sl = e["p_con_sl_w"] * self.horas_sl + e["p_sin_sl_w"] * (24 - self.horas_sl)
        return {
            "en_soc_pct": round(self.soc_pct(), 1),
            "en_soc_confiable": self.soc_confiable(ahora),
            "en_energia_restante_wh": round(restante),
            "en_autonomia_sin_sl_h": round(restante / e["p_sin_sl_w"], 1) if e["p_sin_sl_w"] > 0 else None,
            "en_autonomia_con_sl_dias": round(restante / dia_con_sl, 2) if dia_con_sl > 0 else None,
            "en_balance_dia_wh": round(e["balance_dia_wh"]),
        }

    def _cerrar_hora(self):
        e, a = self.e, self.e["acum"]
        if a["minutos"]:
            fin = e["hora"] + 3600
            data = self.resumen(fin)
            data.update({
                "en_minutos": a["minutos"],
                "en_starlink_min": a["starlink_min"],
                "en_p_carga_w": round(a["e_carga_wh"] * 60 / a["minutos"], 1),
                "en_e_carga_wh": round(a["e_carga_wh"], 1),
                "en_e_pv_wh": round(a["e_pv_wh"], 1),
                "en_e_bat_wh": round(a["e_bat_wh"], 1),
                "en_v_min": round(a["v_min"], 2) if a["v_min"] is not None else None,
            })
            self._guardar_ultimo(e["hora"] * 1000, data)
        e["acum"] = self._acum_vacio()

    def _guardar_ultimo(self, tiempo_ms, data):
        """Pisa energia.json con el resumen de la ultima hora (solo en vivo,
        docs/plan_modos_starlink.md Fase 5; el detalle va a GCS)."""
        carpeta = self.dir_pendientes()
        os.makedirs(carpeta, exist_ok=True)
        final = os.path.join(carpeta, "energia.json")
        tmp = final + ".tmp"
        with open(tmp, "w") as f:
            json.dump({"time": tiempo_ms, "data": data}, f)
        os.replace(tmp, final)
