fvilla-edge/Sand-Monitoring/scripts_campo/resumen_modo_evento.py

#!/usr/bin/env python3
"""
resumen_modo_evento.py — "anotador" del reporte a Losant del modo evento.

Cada minuto resume las filas nuevas del CSV de ventanas que escribe
capturar_eventos (docs/modo_evento.md) y deja SOLO el ultimo resumen en
ULTIMO (RAM), pisando el anterior. panel_solar_ble/publicar_losant.py (la
unica conexion MQTT al Device) lo manda a Losant con su hora original
mientras hay conexion. Sin conexion no se guarda nada mas: Losant es solo en
vivo y el detalle completo va a GCS en los CSV horarios
(docs/plan_modos_starlink.md, Fase 5). Antes era una cola por minuto en
/mnt/usb/losant_pendientes.

No sabe nada de MQTT ni del ESP32, y no toca capturar_eventos: solo lee el
CSV y el log de reinicios del supervisor.

Cuidados de carga (en NOCHE1, 2026-09-25, hasta un `ls` periodico coincidia
con perdidas de muestras):
  - proceso persistente con Nice=10 (ver el .service), no uno nuevo por minuto;
  - lectura incremental del CSV (solo los bytes nuevos desde el minuto anterior);
  - nunca lista la carpeta de eventos (puede tener decenas de miles de archivos):
    el nombre del CSV sale de la hora UTC.

Uso:
    python3 resumen_modo_evento.py [--contadores /mnt/usb/losant_pendientes]
"""
import argparse
import ctypes
import json
import os
import shutil
import statistics
import subprocess
import sys
import time
from datetime import datetime, timezone

sys.path.insert(0, "/root/scripts_campo_comun")
import cfg  # noqa: E402 (import tardio, necesita el sys.path de arriba)

SERVICIO = "modo-evento"
INTERVALO_S = 60
# Ultimo resumen (tmpfs: ni USB ni SD, se pierde con un reinicio). Lo lee
# publicar_losant.py (ULTIMO_DIR alla).
ULTIMO = "/run/losant_ultimo/evento.json"
# Destino real de la corrida en curso (supervisor_eventos.sh arrancar):
# "<carpeta>" o "<carpeta> sin_disco"
DESTINO_ACTUAL = "/run/modo-evento/destino"
# "canales=N dec=M" (en dual + " in2=<modo>") de la corrida en curso (lo escribe supervisor_eventos.sh)
MEDICION_ACTUAL = "/run/modo-evento/medicion"
# "si"/"no": si la corrida mide de verdad el IN2 (lo escribe capturar_eventos
# al leer el bitstream; dual con un bitstream sin IN2 mide solo el IN1)
IN2_ACTUAL = "/run/modo-evento/in2"
# resultado del ultimo cambio mono/dual (cambiar_canales.sh, comando "canales")
ESTADO_CAMBIO_CANALES = os.path.join(cfg.obtener("rutas.log_dir"), "cambio_canales_estado")
# Sin una ventana nueva en este tiempo, se reporta que no esta midiendo
SIN_DATOS_MAX_S = 30
LOG_REINICIOS = os.path.join(cfg.obtener("rutas.log_dir"), "modo_evento_reinicios.log")
# La crea/borra capturar_eventos al pausar/reanudar la señal cruda por espacio
BANDERA_CRUDA_PAUSADA = "/run/modo-evento/cruda_pausada"
# Sensor de temperatura del Zynq (XADC)
XADC = "/sys/bus/iio/devices/iio:device0"
_LIBC = ctypes.CDLL(None, use_errno=True)


def log(msg):
    print(f"[{datetime.now(timezone.utc):%H:%M:%S}] {msg}", flush=True)


def medicion_actual():
    """{"canales": N, "dec": M[, "in2": modo]} de la corrida en curso, o {} si no hay."""
    try:
        with open(MEDICION_ACTUAL) as f:
            return {k: int(v) if v.isdigit() else v for k, _, v in (p.partition("=") for p in f.read().split()) if v}
    except OSError:
        return {}


def mide_in2():
    """True/False segun capturar_eventos, o None si todavia no lo escribio
    (arranque en curso): en ese caso vale lo que dice medicion."""
    try:
        with open(IN2_ACTUAL) as f:
            return {"si": True, "no": False}.get(f.read().strip())
    except OSError:
        return None


def estado_servicio():
    """(activo, destino, umbral) leidos de systemd: siguen solos un cambio de
    Environment= o de drop-in en modo-evento.service."""
    try:
        salida = subprocess.run(
            ["systemctl", "show", "-p", "ActiveState", "-p", "Environment", SERVICIO],
            capture_output=True, text=True, timeout=10,
        ).stdout
    except Exception:
        return False, None, None
    activo, env = False, {}
    for linea in salida.splitlines():
        clave, _, valor = linea.partition("=")
        if clave == "ActiveState":
            activo = valor == "active"
        elif clave == "Environment":
            for par in valor.split():
                k, _, v = par.partition("=")
                env[k] = v
    try:
        umbral = float(env["UMBRAL"])
    except (KeyError, ValueError):
        umbral = None
    destino, sin_disco = env.get("DESTINO"), False
    try:
        with open(DESTINO_ACTUAL) as f:
            partes = f.read().split()
        if activo and partes:
            destino, sin_disco = partes[0], "sin_disco" in partes[1:]
    except OSError:
        pass
    return activo, destino, umbral, sin_disco


def disco_montado():
    """True si /mnt/usb es un disco de verdad (no la carpeta de la SD ni un tmpfs)."""
    if not os.path.ismount("/mnt/usb"):
        return False
    tipo = None
    try:
        with open("/proc/mounts") as f:
            for linea in f:   # el ultimo montaje sobre /mnt/usb es el que se ve
                partes = linea.split()
                if len(partes) > 2 and partes[1] == "/mnt/usb":
                    tipo = partes[2]
    except OSError:
        pass
    return tipo != "tmpfs"


def ruta_csv(destino, hora):
    return os.path.join(destino, f"ventanas_{hora:%Y%m%d_%H}.csv")


class LectorCSV:
    """Lee solo las filas nuevas de los CSV por hora, siguiendo la rotacion."""

    def __init__(self):
        self.destino = None
        self.hora = None      # datetime UTC truncado a la hora del CSV en curso
        self.offset = 0
        self.ultima_fila = None  # (t_utc_ms, area, kurtosis) de la ultima fila ok vista

    def _arrancar(self, destino, ahora):
        # Arranca al final del CSV actual: el primer resumen cubre el primer
        # minuto de este proceso, no la historia. Se siembra ultima_fila con
        # la cola del archivo para que me_seg_sin_datos tenga sentido de entrada.
        self.destino = destino
        self.hora = ahora.replace(minute=0, second=0, microsecond=0)
        ruta = ruta_csv(destino, self.hora)
        try:
            tam = os.path.getsize(ruta)
            with open(ruta, "rb") as f:
                f.seek(max(0, tam - 4096))
                for fila in self._parsear(f.read().decode(errors="replace").splitlines()[1:]):
                    if fila[4] == "ok":
                        self.ultima_fila = (fila[1], fila[2], fila[3])
            self.offset = tam
        except OSError:
            self.offset = 0

    @staticmethod
    def _parsear(lineas):
        for linea in lineas:
            partes = linea.split(",")
            # 7 columnas desde 2026-10-06 (dec al final); 6 en CSV viejos
            if len(partes) not in (6, 7) or partes[0] == "window_count":
                continue
            try:
                wc, t_ms = int(partes[0]), int(partes[1])
                area = float(partes[2]) if partes[2] else None
                kurt = float(partes[3]) if partes[3] else None
                perdidas = int(partes[5]) if partes[5] else 0
            except ValueError:
                continue
            yield wc, t_ms, area, kurt, partes[4], perdidas

    def _leer_archivo(self, ruta):
        try:
            tam = os.path.getsize(ruta)
        except OSError:
            return []
        if tam < self.offset:   # archivo recreado: empezar de cero
            self.offset = 0
        if tam == self.offset:
            return []
        with open(ruta, "rb") as f:
            f.seek(self.offset)
            datos = f.read(tam - self.offset)
        # solo lineas completas: una fila a medio escribir queda para el minuto que viene
        corte = datos.rfind(b"\n") + 1
        self.offset += corte
        return list(self._parsear(datos[:corte].decode(errors="replace").splitlines()))

    def filas_nuevas(self, destino, ahora):
        if destino != self.destino:
            self._arrancar(destino, ahora)
            return []
        hora_actual = ahora.replace(minute=0, second=0, microsecond=0)
        filas = self._leer_archivo(ruta_csv(destino, self.hora))
        if hora_actual != self.hora:
            # rotacion: se termino de leer la hora anterior, pasar a la actual.
            # Si hubo un salto de varias horas (placa apagada) no se recorren
            # las intermedias: el resumen es del ultimo minuto, no un historico.
            self.hora, self.offset = hora_actual, 0
            filas += self._leer_archivo(ruta_csv(destino, self.hora))
        for fila in filas:
            if fila[4] == "ok":
                self.ultima_fila = (fila[1], fila[2], fila[3])
        return filas


class Contadores:
    """Eventos del dia (UTC), persistidos en el USB para sobrevivir a un reinicio
    de este proceso."""

    def __init__(self, ruta):
        self.ruta = ruta
        self.dia, self.eventos = None, 0
        try:
            with open(ruta) as f:
                datos = json.load(f)
            self.dia, self.eventos = datos["dia"], int(datos["eventos"])
        except (OSError, ValueError, KeyError):
            pass

    def sumar(self, dia, n):
        if dia != self.dia:
            self.dia, self.eventos = dia, 0
        self.eventos += n
        try:
            tmp = self.ruta + ".tmp"
            with open(tmp, "w") as f:
                json.dump({"dia": self.dia, "eventos": self.eventos}, f)
            os.replace(tmp, self.ruta)
        except OSError:
            pass   # sin USB: se sigue contando en RAM


def reinicios_hoy(dia):
    """Caidas del dia (UTC) segun el supervisor: toda terminacion que no sea la
    parada limpia (resultado=success). Las lineas sin_usb no cuentan: son
    arranques rechazados, no caidas."""
    n = 0
    try:
        with open(LOG_REINICIOS) as f:
            for linea in f:
                if linea.startswith(dia) and "resultado=" in linea and "resultado=success" not in linea:
                    n += 1
    except OSError:
        return None
    return n


def ram_disponible_mb():
    """MemAvailable de /proc/meminfo: lo que el kernel puede dar sin swap
    (incluye la cache que se puede liberar), en MB."""
    try:
        with open("/proc/meminfo") as f:
            for linea in f:
                if linea.startswith("MemAvailable:"):
                    return int(linea.split()[1]) // 1024
    except (OSError, ValueError, IndexError):
        pass
    return None


def uptime_s():
    try:
        with open("/proc/uptime") as f:
            return int(float(f.read().split()[0]))
    except (OSError, ValueError, IndexError):
        return None


def temperatura_c():
    """Temperatura del chip en °C: (raw + offset) * scale / 1000."""
    try:
        valores = []
        for nombre in ("in_temp0_raw", "in_temp0_offset", "in_temp0_scale"):
            with open(os.path.join(XADC, nombre)) as f:
                valores.append(float(f.read()))
        raw, offset, escala = valores
        return round((raw + offset) * escala / 1000, 1)
    except (OSError, ValueError):
        return None


class _Timex(ctypes.Structure):
    # struct timex (linux/timex.h): solo los campos que se usan; el resto
    # queda en un relleno generoso para que adjtimex() no escriba afuera
    _fields_ = [("modes", ctypes.c_uint), ("offset", ctypes.c_long),
                ("freq", ctypes.c_long), ("maxerror", ctypes.c_long),
                ("esterror", ctypes.c_long), ("status", ctypes.c_int),
                ("_resto", ctypes.c_byte * 256)]


def ntp_sincronizado():
    """True si el reloj esta sincronizado (sin RTC, sin esto las horas del CSV
    y de Losant pueden estar corridas). Mismo criterio que NTPSynchronized de
    systemd (error maximo del kernel < 16s), pero leido directo con adjtimex:
    timedatectl cada minuto activaba systemd-timedated via PID1, sospechoso
    del reinicio por watchdog de rp-f0fd8c del 2026-09-28."""
    try:
        t = _Timex()   # modes=0: solo lectura
        if _LIBC.adjtimex(ctypes.byref(t)) < 0:
            return None
    except (OSError, AttributeError):
        return None
    return t.maxerror < 16_000_000


def salud_placa():
    """Atributos de salud de la placa (no de la medicion). Todas lecturas de
    /proc, /sys o statvfs: no agregan carga que perturbe el streaming."""
    usb_montado = disco_montado()
    data = {
        # memoria RAM disponible en MB (~300 en regimen; bajando = algo pierde memoria)
        "ram_disp_mb": ram_disponible_mb(),
        # segundos desde que arranco la placa: si baja, la placa se reinicio
        "uptime_s": uptime_s(),
        # temperatura del chip de la placa en °C
        "temp_cpu_c": temperatura_c(),
        # true si el reloj esta sincronizado por NTP
        "ntp_sincronizado": ntp_sincronizado(),
        # true si el disco USB esta montado (sin el, no se guardan eventos)
        "usb_montado": usb_montado,
    }
    try:
        # espacio libre en la SD (sistema, journal y cores de caidas), en MB
        data["sd_libre_mb"] = shutil.disk_usage("/").free // (1024 * 1024)
    except OSError:
        pass
    if usb_montado:
        try:
            # espacio libre en el disco USB, en MB
            data["usb_libre_mb"] = shutil.disk_usage("/mnt/usb").free // (1024 * 1024)
        except OSError:
            pass
    return {k: v for k, v in data.items() if v is not None}


def estado_medicion(activo, sin_disco, n_filas, seg_sin_datos):
    """Una sola palabra para Losant: "midiendo", "midiendo_sin_disco" (solo
    el CSV en la SD, sin señal cruda) o "no_midiendo"."""
    # Se juzga por la ultima ventana vista y no por las filas del minuto: al
    # cambiar de destino o arrancar el anotador el primer minuto viene vacio.
    sin_datos = n_filas == 0 if seg_sin_datos is None else seg_sin_datos > SIN_DATOS_MAX_S
    if not activo or sin_datos:
        return "no_midiendo"
    return "midiendo_sin_disco" if sin_disco else "midiendo"


def resumir(filas, lector, contadores, activo, umbral, ahora, sin_disco=False, filas_in2=None):
    ok = [f for f in filas if f[4] == "ok" and f[3] is not None]
    kurts = [f[3] for f in ok]
    areas = [f[2] for f in ok if f[2] is not None]
    en_umbral = sum(1 for k in kurts if umbral is not None and k >= umbral)
    dia = ahora.strftime("%Y-%m-%d")
    contadores.sumar(dia, en_umbral)

    t_ms = int(ahora.timestamp() * 1000)
    # Atributos del Device en Losant (mismo nombre). "Ventana" = 50 ms de señal;
    # en un minuto hay ~1200.
    data = {
        # true si el servicio de medicion (modo-evento) esta corriendo
        "me_activo": activo,
        # ventanas medidas en el ultimo minuto (~1200 si todo anda bien)
        "me_ventanas_1min": len(filas),
        # ventanas que el programa no llego a leer en el ultimo minuto (lo normal es 0)
        "me_ventanas_saltadas_1min": sum(1 for f in filas if f[4] != "ok"),
        # ventanas sobre el umbral en el dia (UTC) = eventos guardados en el USB.
        # Cota superior: no descuenta los que capturar_eventos descarte por cola llena
        "me_eventos_hoy": contadores.eventos,
        # muestras de la señal cruda que el streaming-server perdio en el ultimo
        # minuto (de ~234 millones). No afecta area/kurtosis (salen de la FPGA),
        # solo deja huecos en la cruda de un evento. Lo normal es 0
        "me_muestras_perdidas_1min": sum(f[5] for f in filas),
    }
    if lector.ultima_fila is not None:
        # segundos desde la ultima ventana medida: señal de vida (lo normal es <2)
        data["me_seg_sin_datos"] = max(0.0, round((t_ms - lector.ultima_fila[0]) / 1000, 1))
    # "midiendo" / "midiendo_sin_disco" (solo CSV en la SD, sin cruda) / "no_midiendo"
    data["me_estado"] = estado_medicion(activo, sin_disco, len(filas), data.get("me_seg_sin_datos"))
    if ok:
        ultima = ok[-1]
        data.update({
            # kurtosis de la ultima ventana (reposo ~3; arena = picos, sube)
            "kurt_ultima": round(ultima[3], 3),
            # kurtosis mas alta del ultimo minuto: no se pierde un pase breve entre reportes
            "kurt_max_1min": round(max(kurts), 3),
            # ventanas del ultimo minuto con kurtosis >= umbral (guardadas como evento)
            "ventanas_umbral_1min": en_umbral,
        })
        if ultima[2] is not None:
            # area (energia de la señal) de la ultima ventana (reposo ~0.52 en HV)
            data["area_ultima"] = round(ultima[2], 4)
        if areas:
            # area tipica del ultimo minuto (la mediana ignora picos sueltos)
            data["area_mediana_1min"] = round(statistics.median(areas), 4)
            # area mas alta del ultimo minuto
            data["area_max_1min"] = round(max(areas), 4)
    # true si capturar_eventos pauso la señal cruda de los eventos por poco
    # espacio en el USB (el registro de ventanas sigue igual)
    data["me_cruda_pausada"] = os.path.exists(BANDERA_CRUDA_PAUSADA)
    if activo:
        med = medicion_actual()
        if "canales" in med:
            # 1 = mono (solo IN1), 2 = dual (IN1 + IN2 de referencia): lo que
            # se mide, no lo pedido (dual con bitstream sin IN2 informa 1)
            data["me_canales"] = med["canales"] if mide_in2() is not False else 1
            if data["me_canales"] == 2 and "in2" in med:
                # en dual: "independiente" (el IN2 graba por su kurtosis) o
                # "asociado" (graba cuando graba el IN1)
                data["me_in2_modo"] = med["in2"]
        if "dec" in med:
            # decimacion de la captura: 32 (3.9 MHz) o 64 (1.95 MHz)
            data["me_dec"] = med["dec"]
    try:
        with open(ESTADO_CAMBIO_CANALES) as f:
            # resultado del ultimo cambio mono/dual pedido por Losant, p.ej.
            # "ok 2 2026-10-06T20:15:03Z" o "error: ... (volvio a 1) ..."
            data["me_cambio"] = f.read().strip()[:200]
    except OSError:
        pass
    # IN2 como sensor independiente (dual con el bitstream que lo calcula,
    # docs/plan_in2_independiente.md): solo maximos del ultimo minuto, el detalle
    # queda en su CSV (<destino>/in2)
    ok2 = [f for f in (filas_in2 or []) if f[4] == "ok" and f[3] is not None]
    if ok2:
        # kurtosis mas alta del IN2 en el ultimo minuto
        data["kurt_max_1min_in2"] = round(max(f[3] for f in ok2), 3)
        areas2 = [f[2] for f in ok2 if f[2] is not None]
        if areas2:
            # area mas alta del IN2 en el ultimo minuto
            data["area_max_1min_in2"] = round(max(areas2), 4)
    reinicios = reinicios_hoy(dia)
    if reinicios is not None:
        # veces que se cayo la medicion en el dia (UTC) y el supervisor la relanzo
        data["me_reinicios_hoy"] = reinicios
    data.update(salud_placa())
    return {"time": t_ms, "data": data}


def guardar(resumen):
    """Pisa ULTIMO con el resumen (escritura atomica)."""
    try:
        os.makedirs(os.path.dirname(ULTIMO), exist_ok=True)
        tmp = ULTIMO + ".tmp"
        with open(tmp, "w") as f:
            json.dump(resumen, f, separators=(",", ":"))
        os.replace(tmp, ULTIMO)
    except OSError as exc:
        log(f"no se pudo guardar {ULTIMO} ({exc})")


def main():
    ap = argparse.ArgumentParser(description=__doc__, formatter_class=argparse.RawDescriptionHelpFormatter)
    ap.add_argument("--contadores", default="/mnt/usb/losant_pendientes",
                    help="carpeta del contador de eventos del dia (.contadores.json, persiste reinicios)")
    args = ap.parse_args()

    lector = LectorCSV()
    lector_in2 = LectorCSV()
    contadores = Contadores(os.path.join(args.contadores, ".contadores.json"))
    log(f"Anotador del modo evento: un resumen cada {INTERVALO_S}s en {ULTIMO} (solo el ultimo)")
    proximo = time.monotonic()
    while True:
        ahora = datetime.now(timezone.utc)
        activo, destino, umbral, sin_disco = estado_servicio()
        filas = lector.filas_nuevas(destino, ahora) if destino else []
        # CSV del IN2 solo si la corrida actual es dual y lo esta escribiendo
        # (con el bitstream viejo o en mono no hay carpeta in2, o es de antes)
        destino_in2 = os.path.join(destino, "in2") if destino else None
        if activo and medicion_actual().get("canales") == 2 and destino_in2 and os.path.isdir(destino_in2):
            filas_in2 = lector_in2.filas_nuevas(destino_in2, ahora)
        else:
            filas_in2 = []
        resumen = resumir(filas, lector, contadores, activo, umbral, ahora, sin_disco, filas_in2)
        guardar(resumen)
        log(f"resumen: {resumen['data']}")
        # monotonic: un salto de reloj por NTP (sin RTC) no adelanta ni frena el ciclo
        proximo += INTERVALO_S
        time.sleep(max(1.0, proximo - time.monotonic()))


if __name__ == "__main__":
    try:
        main()
    except KeyboardInterrupt:
        pass
