fvilla-edge/Sand-Monitoring/scripts_campo/capturar_eventos.py

#!/usr/bin/env python3
"""capturar_eventos.py — "modo evento": streaming continuo (24h, sin cortes),
NO persiste nada salvo cuando una ventana de 50ms cruza kurtosis>=umbral — en
ese caso guarda esa ventana cruda + su área/kurtosis.

Este script solo prepara la placa (bitstream stream_app + streaming-server,
igual que capturar_stream.py) y hace exec del núcleo en C++
(`c/capturar_eventos`, compilar en la placa con `make -C c`). El recibir
muestras + buffer + sondeo de la FPGA vive en C++ porque en Python el
callback no daba abasto: leer y convertir `ch.raw` costaba ~19ms por paquete
contra 8.4ms entre paquetes a decimación 32, y el streaming-server descartaba
~63% de las muestras (medido en rp-f0fd8c, 2026-09-23 — detalle en
c/capturar_eventos.cpp).

Uso:
  python3 capturar_eventos.py [--umbral 3.4] [--destino /root/eventos]
                              [--dec 32] [--canales 1] [--in2-modo independiente]
                              [--estado-s 10] [--duracion-s 0]
                              [--host 127.0.0.1]
"""
import os
import sys
import argparse

sys.path.insert(0, '/root/scripts_campo_comun')
import campo_common as cc
import cfg

BINARIO = os.path.join(os.path.dirname(os.path.abspath(__file__)), 'c', 'capturar_eventos')


def main():
    ap = argparse.ArgumentParser(description=__doc__, formatter_class=argparse.RawDescriptionHelpFormatter)
    ap.add_argument('--umbral', type=float, default=3.4,
                     help='kurtosis minima para guardar la ventana (default 3.4 desde '
                          '2026-10-05, antes 5.0; reposo ~2.97)')
    ap.add_argument('--umbral2', type=float, default=None,
                     help='kurtosis minima del IN2 (sensor independiente, solo en dual con el '
                          'bitstream que calcula el IN2). Default: el mismo que --umbral')
    ap.add_argument('--destino', default='/root/eventos',
                     help='carpeta donde se guardan los eventos que cruzan el umbral')
    ap.add_argument('--dec', type=int, default=32, choices=[32, 64],
                     help='decimacion (default 32). El C++ ajusta la ventana y el pasabanda de la '
                          'FPGA; el umbral y el piso/escala de la PC estan medidos a 32')
    ap.add_argument('--canales', type=int, default=1, choices=[1, 2],
                     help='1 = solo IN1 (default); 2 = IN1 + IN2: con el bitstream que calcula el '
                          'IN2, es un sensor independiente (eventos y CSV propios en <destino>/in2)')
    ap.add_argument('--in2-modo', default='independiente', choices=['independiente', 'asociado'],
                     help='en dual: independiente (default) = el IN2 graba por su propia kurtosis; '
                          'asociado = graba su cruda solo cuando graba el IN1 (docs/plan_in2_asociado.md)')
    ap.add_argument('--estado-s', type=int, default=10,
                     help='cada cuantos segundos loguear una linea de ESTADO (default 10)')
    ap.add_argument('--duracion-s', type=int, default=0,
                     help='cortar solo despues de N segundos (default 0 = hasta Ctrl+C/SIGTERM)')
    ap.add_argument('--host', default='127.0.0.1',
                     help='IP del streaming-server (default 127.0.0.1). "auto" = descubrimiento '
                          'por broadcast del vendor, que ata la conexion a la IP de eth0: con '
                          'eth0 abajo (corte de Starlink) el stream se congela y se pierde la '
                          'señal cruda. Con IP fija no (probado en rp-f0fd8c, 2026-09-23).')
    ap.add_argument('--minimo-libre-mb', type=int, default=None,
                     help='debajo de estos MB libres en --destino se pausa la señal cruda de los '
                          'eventos (el CSV sigue). Default: modo_evento.minimo_libre_mb de '
                          'config_campo.json; 0 = sin control')
    args = ap.parse_args()
    minimo_libre_mb = (args.minimo_libre_mb if args.minimo_libre_mb is not None
                       else cfg.obtener('modo_evento.minimo_libre_mb'))

    if not os.access(BINARIO, os.X_OK):
        sys.exit(f'ERROR: falta {BINARIO} — compilar en la placa con: make -C {os.path.dirname(BINARIO)}')

    cc.log('INFO', 'Asegurando streaming-server (mata previo + carga bitstream)...')
    cc.asegurar_servidor('/root/capturar_eventos_server.log', bitstream_propio=True)

    # exec: el binario reemplaza a este proceso, asi SIGINT/SIGTERM le llegan directo
    os.execv(BINARIO, [BINARIO,
                       '--umbral', str(args.umbral),
                       '--destino', args.destino,
                       '--dec', str(args.dec),
                       '--canales', str(args.canales),
                       '--in2-modo', args.in2_modo,
                       '--estado-s', str(args.estado_s),
                       '--duracion-s', str(args.duracion_s),
                       '--minimo-libre-mb', str(minimo_libre_mb)]
             + ([] if args.umbral2 is None else ['--umbral2', str(args.umbral2)])
             + ([] if args.host == 'auto' else ['--host', args.host]))


if __name__ == '__main__':
    main()
