fvilla-edge/Sand-Monitoring/(commit log)

2026-06-24 semana 1: adquisicion HDF5 y pipeline de analisis
    - scripts_rp/capturar.py: adquisicion desde Red Pitaya (decimacion 64,
    1.953 MHz, 50 buffers x 16384 = ~419ms), filtro Butterworth 100-450 kHz,
    metricas (RMS, energia, kurtosis, crest factor, eventos) y guardado HDF5
    - analisis/analisis_semana1.py: carga capturas .h5, genera senyal raw,
    FFT comparativa, espectrogramas STFT y boxplots de metricas
    - .gitignore: excluye .venv/, capturas/ y outputs/ generados
2026-06-24 mejoras de hv
2026-06-24 agrega leer_h5.py y corrige boxplot en analisis
    - scripts_rp/leer_h5.py: muestra metadatos y metricas de archivos .h5
    - analisis_semana1.py: corrige parametro tick_labels en boxplot (matplotlib 3.11)
2026-06-24 mejoras captura y espectrograma
    - capturar.py: countdown 5s + delay 1s post-aviso, 300 buffers (~2.5s),
    modo HV confirmado (GAIN_5X)
    - analisis_semana1.py: espectrograma con escala anclada al ruido base del
    reposo (vmin=mediana reposo, vmax=max global) para mostrar eventos de
    arena sobre fondo oscuro; muestra duracion completa de cada captura
2026-06-26 cambios de docs
2026-06-26 revisar capturas de campo
2026-06-29 modo de captura dual
2026-07-02 cambios de estructura
2026-07-02 mejora de usb
2026-07-03 cambio en la estructura
2026-07-03 se borro lo de h5
2026-07-06 cambio de mapeo
2026-07-06 cambios en el server
2026-07-06 fix: levantar de nuevo el servidor
    [capturar_stream.py]
2026-07-06 calibracion adc
2026-07-06 script adc api python
2026-07-07 script para la issue de github
    [repro_in1_file_bug.py]
2026-07-08 se agregaron datos para mostrar
2026-07-13 regla para el montado de memoria
2026-07-13 cambio de documentacion
2026-07-13 manejo de errores
2026-07-14 alias para prender y apagar
2026-07-16 actualizacion de documentacion
2026-07-17 fix de off
2026-07-17 desactivar timers
2026-07-17 fix de memoria
2026-07-20 cambio de print
2026-07-22 maneja ahora el rele
2026-07-22 control del estado del led de rele que nos indica si esta prendido o apagado
2026-07-23 no se puede usar pin scl
2026-07-23 arranque seguro para el pin
2026-07-24 mantener estado del rele en caso que se produzca un apagado justo en el momento de escritura
2026-07-24 manejo de timer por config json
2026-07-24 mejora de documentacion
2026-07-24 guia de uso
2026-07-24 cambios en la guia
2026-07-24 se agrego el subsistema de starlink al readme
2026-07-27 graficos para los datos
2026-07-27 manejo de autolimpieza del rele
2026-07-28 watchdog para rele
2026-07-28 historial de cambios
2026-07-28 fix rescate de rele: chequear reloj sincronizado antes de contar horas
2026-07-28 cambios en la documentacion en el historial de starlink y comentarios de la script
2026-07-29 prueba de reboot completada
2026-07-29 se agrego el sync a manual
2026-07-29 fix de scp config.json
2026-07-29 integracion de instalacion en un archivo
2026-07-29 se agrego la referencia de como instalar la parte remota en la guia de uso
2026-07-29 se agrego la parte de aplicar_horario
2026-07-31 se arreglo el bug de state file y ahora se hace un pulso pull down
2026-08-03 documentacion sobre el state file
2026-08-03 actualizacion de documentacion de starlink
2026-08-03 seguridad de ssh
2026-08-03 documentacion de reboot real
2026-08-03 documentacion de como entrar a la placa
2026-08-03 cambio de password
2026-08-04 puente esp32-c3 para leer panel solar victron por ble en la pitaya
2026-08-04 publicar datos del panel solar en losant desde la pitaya
2026-08-05 publicar estado del cargador cada vez que se reconecta a internet
2026-08-05 el estado-starlink devuelve en que modo esta
2026-08-05 informe de bateria cada 15min
2026-08-05 avisar por stderr cuando el rescatet de reloj/manual vencido pisa el modo manual del rele
2026-08-06 informe de como actualizar el archivo .ino en pitaya
2026-08-06 se resolvio el tema del puerto de la esp32
2026-08-06 orgnizacion de archivos
2026-08-06 modos de led de control
2026-08-07 estado del led en modo captura
2026-08-07 post de prueba cuando termina la captura total
2026-08-07 mata el servidor para asegurar que cada vez cargue uno nuevo
2026-08-07 fix asegurar_mux_ps10 para que no se reintente cada 5 min al fallar
2026-08-11 se agregaron los argumentos de pozo y pad para las capturas
2026-08-11 se agregaron los comandos a la documentacion
2026-08-11 ahora por post se envia el nombre de la carpeta
2026-08-11 se borran los pendientes una vez confirmado el post
2026-08-12 url de prueba que paso nico
2026-08-13 documentacion de despliegue
2026-08-13 url de backend desde config json
2026-08-13 cambio de url de post
2026-08-13 se actualizo la url de post
2026-08-14 avisar sesion parcial si la captura crashea con chunks guardados
2026-08-18 se borra la carpeta cuando falla la captura
2026-08-20 cambio de horario de apagado
2026-08-21 script aislado de prueba para el RTC DS3231 por I2C
    Valida lectura/escritura de hora y temperatura via smbus2, sin tocar
    systemd/ntpsec/fake-hwclock. Probado en hardware real (bus 0, ver
    plan): sobrevive tanto un reinicio en caliente como un corte de
    energia real manteniendo la hora correcta por bateria propia.
2026-08-21 Fase 4: integrar el RTC DS3231 al arranque del sistema
    Nuevo rtc-restaurar.service (oneshot, antes de ntpsec y de Starlink)
    setea el reloj del sistema desde el DS3231 al boot, sin esperar a que
    haya red. Validado en placa real: orden de arranque correcto y hora
    del sistema correcta incluso con ntpsec bloqueado (simulacion de
    reinicio sin internet).
    No incluye guardado periodico del sistema hacia el RTC (evaluado y
    descartado: el DS3231 ya tiene compensacion de temperatura, ~1 min/ano
    de desfasaje tipico, insignificante para un horario en ventanas de
    HH:MM). Tampoco toca decidir_objetivo.sh ni la logica de rescate por
    NTPSynchronized - queda para una fase aparte.
2026-08-21 Usar el RTC DS3231 tambien para el rescate de decidir_objetivo.sh
    decidir_objetivo.sh forzaba "on" (o ignoraba el manual "off") cada vez
    que NTPSynchronized=no, aunque el reloj ya fuera confiable gracias al
    RTC restaurado al boot. Ahora confia en el horario/rescate manual si
    NTP sincronizo O si restaurar_hora.sh dejo el flag /run/rtc_ds3231_ok
    en este boot; sin ninguna de las dos fuentes, el comportamiento viejo
    queda intacto.
    Tambien corrige el bit +x de decidir_objetivo.sh, que estaba trackeado
    sin ejecutable desde antes (aplicar_objetivo.sh lo invoca directo).
    Validado con shims locales y en la placa real (rp-f0fbda), incluyendo
    un reboot real con ntpsec enmascarado y un apagado/encendi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
2026-08-25 Integrar starlink_api (GPS/status del dish) al reporte de Losant
    publicar_losant.py (panel_solar_ble) ahora tambien publica, una vez por
    cada connect/reconnect a Losant, la telemetria del dish Starlink
    (GPS + estado del link, ver starlink_api/) - va al mismo Device que ya
    usa el panel solar, a proposito (mismas credenciales encontradas en el
    starlink_api standalone), por eso vive en el mismo proceso en vez de un
    servicio separado.
    Modo "hardcoded" (default, en config_campo.json) probado end-to-end en
    la placa real: conecta, publica el ejemplo hardcodeado, no rompe el
    reporte de panel solar existente. Modo "live" queda sin implementar
    todavia: el wheel de grpcio en PyPI para esta placa (armv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
2026-08-25 se envia None en alerts de starlink
2026-08-25 starlink_api: agregar sofware_update_state/progress y disablement_code al reporte de losant
2026-08-26 panel_solar_ble: capturar fallo de publish en _publicar_informe
2026-08-26 panel_solar_ble: manejo de credenciales invalidas
2026-08-26 victron_scanner: no crashear el proceso por una linea serial corrupta
    [victron_scanner.py]
2026-08-26 rtc_ds3231: verificar que date -s haya funcionado antes de marcar FLAG_OK
2026-08-27 actualizacion de la documentacion
2026-08-28 correcion de timer de 17:15
2026-09-01 capturar_stream: agregar canal y decimacion al nombre de carpeta
    Antes de descargar una sesion desde la nube era dificil distinguir
    mono/dual y la decimacion sin abrir el json de metadata de cada una,
    con el ancho de banda limitado de campo. Se agrega como sufijo
    (mono/dual + decimacion) para no romper el glob *_${CONDICION}_* que
    usa relanzar_captura.sh para el rescate de sesiones parciales tras un
    crash. Probado en la placa real (rp-f0fbda): 2 sesiones dual y 2 mono,
    sin errores, aviso posteado ok.
    [capturar_stream.py]
2026-09-01 comandos_losant: prueba minima de Send Device Command via MQTT
    Escucha comandos de un Device de prueba (test_SC, credenciales aparte via
    losant_config_test.py gitignoreado) y los imprime, sin ejecutar ninguna
    accion todavia. Probado en real: llega nombre/payload/time del comando
    mandado desde el panel de Losant.
2026-09-01 comandos_losant: extraer y mostrar el campo mensaje del comando test
    Probado en real con el Device de prueba test_SC: al recibir el comando
    'test', imprime directamente payload['mensaje'] en vez del dict crudo.
2026-09-01 comandos_losant: comando capturar con guard anti-superposicion y dummy de prueba
    Agrega el manejo del comando 'capturar', con defaults tomados de la
    invocacion mas usada en campo (repetir_captura.sh + relanzar_captura.sh +
    capturar_stream.py, ver COMANDOS.md) y overridables por payload. Lanza via
    subprocess.Popen no bloqueante para no colgar el loop de MQTT durante la
    captura, y guarda el proceso en curso para rechazar un segundo 'capturar'
    mientras el anterior sigue vivo.
    Por ahora apunta a simular_captura.sh (dummy, sleep + echo) en vez de la
    cadena real, para poder probar el disparo/guard sin hardware de captura ni
    tocar publicar_losant.py de produccion. Probado en real contra el Device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
2026-09-02 publicar_losant: integrar comando "capturar" real (probado en HW, hotel)
    Mismo patron que comandos_losant/ (rama comandos-losant-test, f5baf8d) pero
    apuntando a las rutas reales de repetir_captura.sh/relanzar_captura.sh/
    capturar_stream.py. Probado en la placa real (rp-f0fbda, Starlink):
    dos capturas sueltas OK, y el guard anti-superposicion confirmado contra la
    cadena real (segundo comando ignorado mientras la primera seguia corriendo).
2026-09-02 publicar_losant: default de captura mono/dec32, no dual/dec64
    Corregido a pedido del usuario: mono (canales=1) con decimacion=32 es la
    invocacion mas comun en campo, no dual/dec64 como se habia asumido al
    integrar el comando (coincide con los defaults nativos de
    capturar_stream.py/config_campo.json). Probado en HW real: payload sin
    canales/decimacion sale con 1/32, sesion y nombre de carpeta ("_mono_dec32")
    correctos.
    [publicar_losant.py]
2026-09-02 publicar_losant: publicar device_state (standby/capturing) por evento y periodico
    Agrega el attribute "device_state" a Losant: se publica de inmediato cuando
    arranca o termina una captura via comando MQTT (via el loop principal, ~1s
    de cadencia), y ademas se re-afirma cada INTERVALO_INFORME_S aunque no haya
    cambio, para no quedar reportando un valor viejo si el servicio se reinicia
    a mitad de una captura real. Probado en HW real: transicion capturing/standby
    inmediata en dos corridas, y el refresco periodico confirmado forzando un
    restart del servicio (arranca con ultimo_envio_estado=0.0, publica standby
    de entrada por la rama de "vencido", no de cambio).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
2026-09-02 se publica por mqtt la memoria disponible del disco externo
2026-09-04 analisis: agregar timeline_lote.py, señal completa de un lote pegada en el tiempo
    Kurtosis y rms_diferencial por ventana de 50ms (mismo criterio que
    fraccion_activa/revisar.py), concatenados en un eje de tiempo absoluto real
    via timeCapture del header (reloj de HW), para ver como sube y baja la
    señal a lo largo de todo un lote de capturas seguidas y encontrar los
    momentos exactos en que paso arena, en vez de solo un resumen por archivo.
    revisar.py expone t_inicio_ns en el meta de _leer_canales_bin para esto.
    matplotlib agregado a requirements.txt (ya lo usaba graficar.py, faltaba
    listar la dependencia).
2026-09-04 analisis: baseline confirmado externo para rms_diferencial, via --baseline
    El baseline de rms_diferencial dependia solo del "reposo" DENTRO de cada
    lote — y un lote entero etiquetado reposo puede no estar confirmado de
    verdad (paso con un lote del 3/9 que cayo dentro de una hora de produccion
    real del pozo segun su reporte, aunque la carpeta dijera reposo).
    generar_baseline.py arma analisis/baseline_confirmado.json a partir de
    capturas confirmadas sin arena por otra via (reporte de pozo + certeza
    operativa, en este caso 1/9 antes de que el pozo arrancara a producir),
    agrupando por (canales, decimacion) y abortando si detecta arena/ruido en
    el lote pasado. revisar.py y timeline_lote.py ace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
2026-09-07 analisis de señal
2026-09-07 analisis: sacar banda/umbral de arena del timeline, agregar extraer_canal.py
    timeline_lote.py ya no pinta la banda naranja ni la linea de umbral de
    kurtosis en el grafico (se seguian fusionando picos <2s en un solo bloque,
    lo que tapaba huecos reales de la señal) - el umbral de 20 se definio en
    banco y todavia no esta confirmado para condiciones de campo, asi que no
    tiene sentido imponerlo visualmente todavia. El texto de "tramos con arena"
    en la salida sigue igual, solo cambio el grafico.
    extraer_canal.py: nuevo script de posprocesamiento (PC, no placa) para sacar
    un solo canal (IN1 o IN2) de una captura dual ya grabada, generando un .bin +
    session_info.json equivalentes a una captura mon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
2026-09-08 fix de enviar el estado del dispositivo cuando tambien se mando una captura por ssh
    [publicar_losant.py]
2026-09-09 aplicacion para ver los datos en tiempo y se aplica filtros pasabanda butterworh, corte en 25khz y 400khz
2026-09-09 se agregaron pestañas para ver las formas de onda mejor
2026-09-09 se agrega el rms
2026-09-09 fft y calculo de area bajo la curva de rms cada 50ms
2026-09-09 se agrego cruz al cursor y diferentes ventanas de tiempo para el calculo del area
2026-09-10 documentacion de lo de failban2 y la adaptacion de revisar
2026-09-10 acumulado de lote (app + calculo)
    Ventana tipo ver_forma_onda.py para ver kurtosis+acumulado de un lote
    entero pegado en el tiempo real, banda unificada de revisar.py.
    timeline_lote.py queda pineado como referencia vieja.
2026-09-10 arreglar cuelgue al cerrar la app de acumulado_lote
    Cerrar la ventana mientras el hilo de fondo seguia filtrando dejaba
    el proceso colgado (necesitaba varios Ctrl+C). Ahora el cierre
    descarta avisos pendientes al hilo de Tk y fuerza la salida.
2026-09-10 evitar acumulacion de restos en la SD interna tras un crash de captura
    Tres huecos distintos detectados hoy en vivo (SIGSEGV nativo de
    _python_lib.so + RuntimeError de chunk), sin forzar nada, en pad 42/pozo 1:
    - data_file_*.bin huerfano cuando un chunk falla con error (mem-error/
    sd-full/no-channels/ADC) antes del rename a campo_*.bin.
    - campo_*.bin ya renombrado pero nunca movido a destino, cuando el proceso
    muere entero (ej. SIGSEGV) entre el rename y el fin del move — se
    rescata a <directorio>/_recuperados/ al arrancar la siguiente sesion en
    vez de perderse en silencio.
    - 182 core dumps (1.2 GB) sin ningun limite, uno por cada crash nativo
    desde julio — se podan a los 15 m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
    [capturar_stream.py]
2026-09-11 paquete liviano de area/kurtosis para la placa (fase 1, sin GUI)
    Extrae de ver_forma_onda.py las funciones puras de filtrado pasabanda +
    area/kurtosis por ventana a analisis/area_kurtosis.py (sin matplotlib/
    tkinter, pensado para poder correr en la placa) y agrega
    exportar_paquete_area.py: exporta (t_centro_s, area, kurtosis) por ventana
    de 50ms a JSON, sin el paso de acumulado/umbral (eso queda para la PC).
    Verificado contra el propio ver_forma_onda.py sobre una captura real:
    area y kurtosis coinciden exacto, 228.5MB de .bin -> 28.4KB de paquete.
2026-09-11 procesamiento por bloques para exportar_paquete_area.py (fase 2, sin OOM en la placa)
    El modo "todo de una" (Fase 1) hace OOM en la placa: un chunk de 200MB ya
    llegaba a ~376MB de RSS y el kernel lo mataba (confirmado en HW real,
    459MiB totales sin swap). Se agrega un modo por bloques, memoria acotada
    sin importar el tamaño del archivo:
    - revisar.py: _leer_canales_bin se refactoriza sobre un nuevo generador
    _iterar_segmentos (mismo comportamiento, 58 tests en verde) que permite
    leer el .bin de a un segmento en vez de cargarlo entero.
    - area_kurtosis.py: _bloques_canal arma bloques con margen real (no
    relleno) para el asentamiento del filtro zero-phase, y
    _area_kurtosis_de_bloque ar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
2026-09-11 paquete area/kurtosis en C (fase 3: Python no llega ni cerca de tiempo real)
    Medido en la placa real, sin ninguna captura corriendo (el escenario mas
    favorable): la version Python/NumPy/SciPy tarda 245.9s para procesar 25.7s
    de audio (0.10x tiempo real) — inviable aunque nunca compita por CPU con
    una captura.
    Se reescribe la parte pesada (leer el .bin por bloques, filtrar pasabanda
    zero-phase, area/kurtosis por ventana) en C (analisis/c/paquete_area.c),
    manteniendo el diseño ya validado de margen+residual entre bloques.
    Python (exportar_paquete_area_c.py) solo calcula los coeficientes SOS con
    scipy.signal.butter (una vez, no es el cuello de botella) y se los pasa al
    binario.
    Resultado: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
2026-09-11 ordenar analisis/ en subcarpetas por tipo (visores/, lote/, utilidades/)
    analisis/ tenia 12 scripts sueltos en la raiz sin ninguna agrupacion.
    Reorganizado por tipo, sin borrar nada (no habia codigo muerto real que
    sacar - hasta timeline_lote.py, reemplazado por acumulado_lote.py para
    lotes nuevos, se mantiene a proposito como referencia historica, decision
    ya tomada en una sesion anterior):
    - analisis/revisar.py — queda en la raiz (fuente de verdad, todo lo importa)
    - analisis/visores/ — ver_forma_onda.py, ver_acumulado_lote.py + sus abrir_*.sh
    - analisis/lote/ — acumulado_lote.py, timeline_lote.py
    - analisis/utilidades/ — extraer_canal.py, generar_bas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
2026-09-11 subir minimo del pasabanda a 50kHz y borrar timeline_lote.py
    Decision de la reunion semanal de avance: el piso del pasabanda de
    25kHz->50kHz (revisar.py, ver_forma_onda.py y quienes reusan su banda).
    Verificado contra el lote de referencia con purga de 8kg confirmada
    (42_1_reposo_20260903): clasificacion identica, kurtosis en eventos
    reales sube levemente sin falsos positivos nuevos en reposo.
    timeline_lote.py se borra (reemplazado hace rato por acumulado_lote.py,
    nada lo importaba) junto con sus referencias sueltas en README/tests.
2026-09-11 merge main (orden de analisis/ + pasabanda 50kHz) y adaptar area-en-placa
    Sincroniza la rama parada (sec.169) con lo que se hizo en main mientras
    tanto: reorg de analisis/ en subcarpetas (ordenar-analisis) y la suba del
    pasabanda a 50kHz (revisar.py, ver_forma_onda.py).
    De paso, el paquete liviano para la placa (area_kurtosis.py,
    exportar_paquete_area.py, exportar_paquete_area_c.py, c/) se reubica en
    analisis/placa/ para seguir la misma convencion de subcarpetas por tipo
    que main ya adopto (visores/, lote/, utilidades/) — quedaba como la unica
    parte suelta en la raiz de analisis/. Ajustados los sys.path/paths
    relativos afectados por el movimiento (revisar.py queda un nivel mas
    arriba desd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
2026-09-11 pasar el filtro pasabanda de zero-phase a causal (Python y C)
    Sec.172: el paquete para la placa (area_kurtosis.py) heredo sin
    querer el filtro zero-phase (sosfiltfilt) de ver_forma_onda.py, el
    visor del que se extrajo — pero area/kurtosis por ventana no dependen
    de fase, solo de la distribucion de amplitud dentro de cada ventana.
    Un filtro causal (sosfilt, una sola pasada) es ~2x mas barato y ya es
    el criterio que usan revisar.py/acumulado_lote.py en la PC para el
    mismo motivo.
    Validado con datos reales (datos_campo/42_1_reposo_20260903_145033):
    - Python causal vs zero-phase: 99.3% coincidencia de clasificacion
    (kurtosis>=6), 1.36x mas rapido de punta a punta.
    - C causal vs zero-phase: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
2026-09-11 bajar el orden del filtro pasabanda de 4 a 2 en el paquete de la placa
    Sec.173: el costo escala lineal con la cantidad de secciones SOS
    (orden4=4, orden2=2) — confirmado con benchmark propio. Orden 1 baja
    demasiado la atenuacion fuera de banda (30kHz: -10.7dB vs -20.7dB de
    orden 4) y pierde clasificacion (98.8%), asi que se descarta.
    revisar.py/ver_forma_onda.py quedan en orden 4 a proposito: corren en
    la PC, sin la restriccion de tiempo real de este paquete.
    C causal orden4 2.87s -> orden2 1.95s (1.47x mas rapido), 100% de
    coincidencia de clasificacion (kurtosis>=6), 0 ventanas discrepan.
    Proyeccion combinada (causal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
2026-09-14 ver_forma_onda.py: orden de filtro propio (4), no heredar el de la placa
    _filtrar_pasabanda se llamaba sin el parametro orden, asi que el visor
    tomaba el default de area_kurtosis.py (bajado a 2 en sec.173 solo para
    el paquete de la placa). El comentario que decia que el visor "seguia
    en orden 4" era falso desde ese cambio.
2026-09-14 agregar herramienta para medir si el polling en software alcanza para leer el area/kurtosis por ventana sin FIFO en HW
    Antes de invertir en una FIFO en HW para el registro AREA_WINDOW_COUNT
    (Etapa 5/6 de RedPitaya-FPGA-Release_2025.2, que solo guarda la ultima
    ventana completa), se mide si un polling de alta prioridad en software
    alcanza para no perder ninguna ventana. Resultado en esta notebook (x86,
    sin privilegios de tiempo real): 0 ventanas perdidas en 60s. Pendiente:
    correr esto en el ARM real (mmap/dev/mem sobre el registro real) cuando
    llegue la placa nueva, con la captura real corriendo de fondo.
2026-09-14 prototipo del paquete liviano armado desde los registros de la FPGA (Etapas 4c/5/6)
    construir_paquete_desde_hw.py: valida de punta a punta el filtro de
    punto fijo + la aproximacion media=0 del acumulador (cada una ya
    validada por separado) contra el paquete 100% software, mismo archivo
    real de referencia. 95.6% de coincidencia de clasificacion (153/160),
    mas bajo que el ~100% de cada aproximacion aislada - la correlacion
    cruzada entre la señal filtrada en punto fijo y la del software es de
    solo 0.80, probablemente por diferencias de fase que la Etapa 4c nunca
    valido (solo comparo magnitud con tonos sinteticos). Las 7 ventanas que
    discrepan caen justo al filo del umbral de kurtosis, no en im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
2026-09-15 coleccionar_paquete_placa.py: elegir automaticamente los coeficientes del pasabanda segun la decimacion real
    El mock hardcodeaba un solo juego de coeficientes (dec32). Ahora
    SECTIONS_Q_POR_DECIMACION tiene los dos juegos validados en sec.177
    (dec32 y dec64, este ultimo calculado y probado contra datos reales en
    RedPitaya-FPGA-Release_2025.2) y LectorRegistrosMock elige el correcto
    leyendo el campo "decimacion" del session_info.json de cada archivo, en
    vez de asumir dec32 siempre. Una decimacion sin coeficientes validados
    tira un error explicito en vez de aplicar el juego equivocado en
    silencio.
    Agregado --archivo al modo demo para poder probar con cualquier
    archivo. Validado: demo dec32 sin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
2026-09-16 ver_forma_onda.py: panel de checkboxes para elegir que vistas mostrar por canal
    En dual, cada archivo abria 27 pestañas (9 vistas x IN1/IN2/Limpia) sin forma
    de filtrar. Ahora hay un checkbox por tipo de vista (Crudo, Filtrado, RMS,
    FFT cruda/filtrada, Area, Señal+Kurtosis, RMS diferencial, Acumulado), todos
    tildados por defecto (mismo comportamiento que antes), con botones Marcar/
    Desmarcar todo. Al cambiar un checkbox se re-grafica el archivo actual al
    toque, sin recalcular nada (ya esta cacheado por archivo).
2026-09-17 Agregar visor interactivo de paquetes livianos (area/kurtosis)
    Estilo ver_forma_onda.py: listbox con drag&drop, una pestana por canal,
    sin generar ningun archivo de salida (reemplaza el intento inicial que
    guardaba PNG). Validado contra ver_forma_onda.py sobre datos reales de
    hoy (7_2_con_arena_20260917_*): area coincide dentro de ~1% entre el
    filtro orden 2 del paquete y el orden 4 del visor de forma de onda.
2026-09-18 Documentar plan de transferencia via Google Cloud Storage
    Relevo para traer .bin crudos puntuales cuando scp directo a la PC es
    demasiado lento por el enlace Starlink de la placa de campo. Subida
    placa->GCS mide 2-2.5x mas rapido que scp directo (la placa inicia la
    conexion en vez de que la PC la pida por SSH). Sin script todavia,
    pendiente decidir si los archivos se borran de GCS tras bajar a la PC.
2026-09-18 Arreglar FFT_NPERSEG perdido en la resolucion del merge anterior
    Al reordenar el bloque del filtro zero-phase durante la resolucion del
    conflicto de merge (commit 99d8dc8), se perdio la constante FFT_NPERSEG
    que usa _calcular_espectro — el visor no abria (NameError). Encontrado
    al probar el archivo real antes de pushear.
2026-09-22 Documentar fix de discovery de streaming resiliente a cortes de eth0
    Cliente y streaming-server se descubren por broadcast UDP (255.255.255.255:18902),
    no por hostname/DNS/127.0.0.1 como se pensaba en investigaciones previas - por eso
    un eth0 sin ruta valida (ej. durante hora_off) rompe la captura con "no se pudo
    conectar al streaming-server"/"Host not found". Fix: interfaz dummy0 persistente,
    validada en rp-f0fd8c y rp-f0fbda (0 fallos con eth0 abajo 150s, antes 10/10).
2026-09-22 Implementar LectorRegistrosHW y benchmark de polling real (Etapas 7-8)
    Primera validacion en hardware real (rp-f0fd8c) del acumulador de
    area/kurtosis de la FPGA: LectorRegistrosHW lee los registros reales via
    mmap de /dev/mem, kurtosis coincide con el pipeline de software (~20%,
    misma clasificacion), area difiere por un factor de escala esperado
    (cuentas fijas vs volts calibrados, invariante para kurtosis).
    medir_polling_ventanas.c reescrito para leer AREA_WINDOW_COUNT real en
    vez de simular un contador - 1200/1200 ventanas, 0 perdidas, gap maximo
    1, con una captura real corriendo de fondo. Descarta la necesidad de
    una FIFO en HW para este problema.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
2026-09-22 WIP modo evento: streaming NET continuo, persiste solo si kurtosis>=5
    prueba_net_mode.py (Fase 1, validado en rp-f0fd8c): modo NET del vendor
    (receivePack en memoria, no FILE a disco) aguanta la carga real sin perder
    muestras - 0 fpgaLost en 10 min corridos con el sondeo de kurtosis
    compitiendo por CPU al mismo tiempo. Antes se descartaba NET por riesgo de
    ancho de banda, pero el filtrado pesado ahora vive en la FPGA, no en el ARM.
    capturar_eventos.py (Fase 2, PENDIENTE DE VALIDAR - ver abajo): streaming
    continuo 24h, buffer circular en RAM (~300ms), LectorRegistrosHW sondeando
    en paralelo. Si una ventana no cruza kurtosis>=5, no se guarda nada de
    ella. Si cruza, se guarda esa ventana cruda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
2026-09-22 Deteccion de arena por ventana, no por % sostenido del archivo
    Confirmado con el pozo (sec.182, 2026-09-22): hubo arena real en 3 franjas
    horarias del 21/9, con picos de kurtosis hasta 841 en ventanas puntuales,
    pero ninguna se sostenia lo suficiente para cruzar fa_pct>5 (el umbral real
    del codigo - el "25%" citado en sesiones anteriores era una referencia de
    texto desactualizada, no el umbral real).
    _detectar_mono: arena si CUALQUIER ventana de 50ms cruza kurtosis>=6
    (fa_pct>0), sin exigir que se sostenga un %.
    _detectar_dual: nuevo campo ventanas_arena_dual en _calcular_dual (CH1>6 y
    CH1>3xCH2 en la MISMA ventana, no en kurtosis global del archivo entero) -
    _detectar_dual lo usa en vez d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
2026-09-23 Modo evento: nucleo en C++ (el callback Python perdia ~63% de muestras)
    Medido en rp-f0fd8c: en Python, leer ch.raw cuesta 3.2ms por paquete
    (SWIG arma una list de 32768 ints) y convertirlo a numpy otros 15ms,
    contra 8.4ms entre paquetes a decimacion 32 - el streaming-server
    descartaba ~63% (fpgaLost lo reportaba, el script lo ignoraba). La
    Fase 1 no lo vio porque su callback solo contaba ch.samples. Ninguna
    variante Python llego a 100% con el sondeo de la FPGA en paralelo.
    scripts_campo/c/capturar_eventos.cpp usa la API C++ del vendor
    (raw = std::vector<int16_t>, callback ~0.1ms): 100% de muestras,
    0 fpgaLost, 0 ventanas saltadas. capturar_eventos.py queda como
    lanzador (bitstream + stream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
2026-09-23 Modo evento: conectar al streaming-server por 127.0.0.1 por defecto
    El descubrimiento por broadcast del vendor ata la conexion a la IP de
    eth0: con eth0 abajo (corte de Starlink) el stream se congelaba ~3.7 min
    y se perdia la señal cruda. Conectando a una IP fija no se congela.
    Probado en rp-f0fd8c con cortes de eth0 de 60-150s, 3 corridas por caso:
    0 congelamientos con 127.0.0.1 ni con 10.250.250.1 (dummy0). Queda un
    hipo de ~0.33s al bajar eth0 que le toca a cualquiera de los dos (no
    depende del host) y se reporta en fpgaLost, sin romper la alineacion.
    Se elige 127.0.0.1: perdio menos en total y no depende de dummy0.
    --host auto vuelve al descubrimiento por broadcast.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
2026-09-23 Modo evento Fase 3 etapa A: alineacion validada con pulsos conocidos
    Modo prueba en capturar_eventos (--prueba-pulsos N, generador_pulsos.h):
    genera pulsos por el streaming de DAC del vendor dentro del MISMO proceso
    (el streaming-server acepta una sola conexion de configuracion; un segundo
    cliente tira al primero y la libreria del vendor muere por SIGSEGV).
    --pulso-loopback-digital usa el loopback DAC->ADC interno de la FPGA
    (reg 0x40000040 bit1): con el bitstream etapa7 la salida fisica OUT1 no
    saca señal (el stream_app del vendor si) - sin impacto en campo.
    La prueba encontro y se arreglaron:
    - calibrar() media (window_count*N - muestras) en instantes cualquiera,
    pero el contador solo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
    [capturar_eventos.cpp, generador_pulsos.h]
2026-09-23 Modo evento Fase 3 etapa B: modo --prueba-archivo (reproducir señal real por el DAC)
    capturar_eventos --prueba-archivo RUTA [--dac-escala 4] [--dac-rate R]
    reproduce una vez por el DAC un tramo de señal real (int16 LE) para
    comparar los eventos del hardware contra el pipeline de software sobre
    el mismo tramo (analisis/placa/verificar_etapaB.py).
    Todavia no da resultados validos, y no por el modo evento: con el
    bitstream etapa7 (armado sobre FPGA Release_2025.2) el lado DAC no
    coincide con el streaming-server del SO 3.00-57 (que trae stream_app
    Release_2026.1) - OUT1 no saca señal y el loopback digital llega
    alterado (una senoidal pura de 150kHz sale con la energia en 450kHz /
    1.65MHz / 1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
2026-09-23 Autodetectar el bloque de registros del acumulador (etapa7 viejo o port 2026.1)
    El port del bitstream a Release_2026.1 movio los registros propios de
    0x200-0x248 a 0x300-0x348 (2026.1 ocupo 0x200-0x214 con timestamps).
    capturar_eventos.cpp, LectorRegistrosHW y medir_polling_ventanas.c
    detectan en cual responde el registro de muestras por ventana (R/W,
    default 195312; lo no mapeado se lee 0 en ambos bitstreams) y usan ese
    bloque. Si no responde en ninguno (p.ej. stream_app del vendor), error
    explicito. Compilado/parseado, sin probar todavia en HW con el bitstream
    nuevo (falta compilarlo, pide Vivado 2025.1).
    [capturar_eventos.cpp]
2026-09-23 Etapa B: compensar el loopback digital del bitstream 2026.1 y adaptar el comparador
    --dac-xor-signo (modo --prueba-archivo): con el bitstream portado a
    Release_2026.1 el loopback digital DAC->ADC invierte el bit de signo (DAC
    en 0 llega como ~-32589, medido en HW); ^0x8000 lo compensa y una
    senoidal de 150kHz sale limpia. Ojo: con señal real (tramo de arena) la
    reproduccion por loopback sigue saliendo deformada/invertida (correlacion
    -0.4..-0.8), el mapeo interno no es solo el bit de signo - no sirve
    todavia para validar sensibilidad.
    verificar_etapaB.py: con el bitstream nuevo el .bin guardado es la señal
    cruda; umbral de correlacion configurable (--corr-min), porque por el
    cable OUT1->I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
2026-09-24 Etapa B: ubicar por prediccion los eventos de baja correlacion
    Ventanas de arena con pocos picos sobre fondo tranquilo tienen kurtosis
    alta pero correlacion baja contra el tramo (casi todo es ruido del banco).
    Segunda pasada: se ubican desde el vecino mas cercano en el stream con una
    busqueda local chica (--corr-min-prediccion, default 0.3).
2026-09-24 Modo evento: registro continuo de area/kurtosis de todas las ventanas
    Ademas de los eventos (señal cruda solo si kurtosis>=umbral), escribe en
    --destino un CSV por hora UTC (ventanas_AAAAMMDD_HH.csv) con window_count,
    t_utc_ms, area, kurtosis, estado (ok|saltada) y perdidas_fpga de cada
    ventana: linea de tiempo completa, señal de vida del sensor, reanalisis con
    otro umbral y base para reconstruir la señal en la PC. Hilo propio con
    flush cada 1s y cota de 10 min en RAM; --sin-registro lo apaga.
    --prueba-archivo: esperar la duracion real del replay antes de cortar (el
    DAC por red consume el archivo antes de reproducirlo y la cola del tramo
    quedaba afuera de la captura).
    Probado en rp-f0fd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
2026-09-24 Conversor del registro continuo (ventanas_*.csv) al formato de paquete liviano
    Tiempo por window_count (exacto), anclado a la hora real por tramo con la
    mediana de t_utc_ms; tramo nuevo si window_count retrocede o no cuadra con
    el reloj (reinicio de captura). Ventanas saltadas quedan como hueco en
    t_centro_s, sin NaN. --unir junta varias horas en un solo paquete. Campos
    extra (inicio_utc, ventanas_saltadas, segmentos) que los consumidores
    actuales ignoran.
2026-09-24 ver_paquete: escalon reducido por vista para registros de horas/dias
    ax.bar con una barra por ventana tardaba ~25s en abrir 1h (72000 ventanas)
    y ~4s por zoom. Ahora escalon relleno con a lo sumo 4000 grupos por vista
    (maximo de cada grupo: un pico de una ventana no se pierde), recalculado al
    hacer zoom/pan; la linea se corta en los huecos. 24h abre en ~0.1s.
2026-09-24 Reconstruccion de la señal continua a partir de eventos + registro continuo
    En la PC, dominio filtrado (mismo pasabanda que el analisis): eventos
    filtrados en su lugar por window_count, huecos rellenos con ruido de banda
    cuya envolvente sigue el area de cada ventana del CSV. Rampa en el margen
    de cada evento, superpuestos se promedian. Mascara real/relleno/sin dato;
    salida .npz y vista rapida --png. Rango acotado (15.6MB/s).
    Area FPGA -> software: escala + piso de ruido de la FPGA (en reposo mide
    ~11% de mas, probable redondeo del filtro en punto fijo), medido con
    eventos de reposo real o default del banco (0.2333, port-2026.1 dec32).
    Eventos con hueco se omiten: el tramo perdido trae dato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
2026-09-24 reconstruir_senal: escala default del banco si faltan eventos fuertes
    Con menos de 5 eventos fuertes la escala se estimaba con eventos de nivel
    bajo, cuyo cociente ya trae el piso de ruido de la FPGA adentro: el piso se
    restaba dos veces y el relleno salia ~10% bajo (L1, 90 min de reposo con 1
    evento: c=0.88). Ahora usa ESCALA_FPGA_DEFAULT (0.9992, medida en el banco).
2026-09-24 Documentar el modo evento: registro continuo, reconstruccion y pruebas de banco
    docs/modo_evento.md: idea y motivos del registro continuo, piezas (placa y
    PC), formatos del CSV y de los eventos, comandos, decisiones de la
    reconstruccion (dominio filtrado, relleno, calibracion del area FPGA),
    resultados de las corridas en rp-f0fd8c (Etapa A/B, V2, W1-W3, R1-R2, L1),
    hallazgos/limitaciones y pendientes. Referencias en README.md y COMANDOS.md.
2026-09-24 Piso de ruido del area FPGA por defecto en HV (condicion de campo)
    Medido en rp-f0fd8c con el jumper de IN1 en HV: 0.3074 (395 ventanas de
    reposo), contra 0.2333 en LV. Que cambie con el jumper indica que no es
    solo redondeo interno de la FPGA. Doc: fila de la corrida HV15 (15 min de
    reposo en HV, 0 eventos, kurtosis max 3.06).
2026-09-24 Matar el streaming-server por nombre exacto, no por texto en la linea de comando
    pkill -f streaming-server mataba cualquier proceso con ese texto en su
    linea de comando: con el supervisor del modo evento relanzando solo, corto
    una sesion SSH en rp-f0fd8c (2026-09-24). Ahora pgrep/pkill -x
    streaming-serve (comm, truncado a 15 caracteres) en
    campo_common.asegurar_servidor y relanzar_captura.sh.
2026-09-24 Supervisor systemd del modo evento (modo-evento.service)
    Arranca al encender (despues de redpitaya_startup/e3_controller: cargar el
    overlay a la vez que el del vendor falla con 'overlays/Full: File exists'),
    relanza siempre sin limite de reintentos (StartLimitIntervalSec=0) con 60s
    de espera, y supervisor_eventos.sh poda core dumps y anota cada fin de
    corrida en /root/logs_campo/modo_evento_reinicios.log.
    Probado en rp-f0fd8c: 5 SIGSEGV recuperados (~74s de hueco c/u), server
    caido recuperado, stop no relanza, 2 reinicios de la placa (el primero
    fallo por la carrera con el overlay y se recupero en el reintento; con
    After= arranco al primer intento). Doc: seccion Supervisor en
    docs/modo_even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
2026-09-24 Modo evento: guardar en /mnt/usb y nunca caer en la SD
    El servicio apunta a /mnt/usb/eventos. Sin USB, /mnt/usb es una carpeta
    de la SD, asi que: supervisor_eventos.sh no deja arrancar si /mnt/usb no es
    un montaje real (reintenta cada 60s), y capturar_eventos anota el
    dispositivo del destino al arrancar y lo verifica antes de cada escritura
    (eventos y CSV): si el USB se desconecta corta con codigo 4. Probado en
    rp-f0fd8c con umount -l: corte en el mismo segundo, 0 archivos en la SD,
    retoma solo al remontar.
    --dac-repetir N: repetir el tramo de --prueba-archivo N veces (pase de
    arena largo sin cargar un archivo enorme en RAM).
    Doc: PASE2 (peor caso a USB, 30 min: 0.59% de muestras y 0.05% d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
2026-09-25 Reporte del modo evento a Losant cada minuto, con buffer nocturno en el USB
    Anotador (scripts_campo/resumen_modo_evento.py + resumen-modo-evento.service):
    cada minuto resume las filas nuevas del CSV de ventanas (kurtosis/area
    ultima, maximo y mediana del minuto, ventanas sobre umbral, saltadas,
    señal de vida, reinicios y eventos del dia, USB libre) y lo deja como un
    archivo atomico por minuto en /mnt/usb/losant_pendientes/, haya o no
    internet. Nice=10 + IO idle, lectura incremental, nunca lista la carpeta de
    eventos; sin USB guarda en RAM, nunca en la SD.
    Cartero (publicar_losant.py): manda los pendientes con su hora original,
    1 por segundo, del mas viejo al mas nuevo, y los borra cuando e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
2026-09-25 publicar_losant: avisar solo el primer fallo de apertura del ESP32
    Sin ESP32 (placa de pruebas) el reintento cada 60s dejaba una linea por
    minuto en el journal, que vive en RAM (5MB). Ahora se avisa una vez por
    racha y se vuelve a avisar solo si el ESP32 aparece y se pierde.
    Probado en rp-f0fd8c: 1 aviso, reintentos silenciosos, pendientes siguen
    saliendo 1/min.
2026-09-25 Modo evento: no arrancar antes de 90s de uptime al boot
    Arrancado en los primeros ~30s de encendida, startStreaming() del vendor
    falla por dentro y su camino de stop crashea (SIGSEGV en
    requestStopStreamingCommon, libstreaming_api.so, visto con gdb sobre el
    core): 7/8 arranques en rp-f0fd8c el 2026-09-25. El reintento del
    supervisor a ~90s andaba siempre. No es el salto de reloj de NTP (saltos
    de +-0.2/1/81s con la captura andando: 0 caidas) ni startup.sh del vendor
    (esperarlo no alcanzo: 2/3 caidas); causa de fondo sin identificar.
    supervisor_eventos.sh antes espera hasta 90s de /proc/uptime (con la placa
    ya andando no agrega demora) y TimeoutStartSec=150 cubre esa espera.
    Probado: 3 reboo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
2026-09-25 Modo evento: proteccion de disco lleno
    Con el USB lleno, capturar_eventos no chequeaba fwrite/fprintf: los eventos
    quedaban vacios o cortados, el CSV dejaba de crecer y el servicio seguia
    "activo" sin que nadie se enterara.
    - Bajo modo_evento.minimo_libre_mb (config_campo.json, 2048; 0 = sin
    control) se pausa la señal cruda de los eventos y el CSV sigue (~3MB/h);
    se reanuda con un 25% de margen. Bandera /run/modo-evento/cruda_pausada
    (borrada al arrancar y al terminar) -> el anotador la manda a Losant como
    me_cruda_pausada. ESTADO suma libre_mb= y CRUDA PAUSADA.
    - Evento que no entra: se borra el par .bin/.json y se cuenta (fallidos).
    - CSV que falla: se avisa una vez por racha, se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
2026-09-28 setup_placa: journal persistente en la SD (sec.3c)
    Bind mount de /var/lib/journal-persist sobre /var/log/journal y
    SystemMaxUse=200M. Validado con reboot real en la placa de pruebas.
2026-09-28 Anotador del modo evento: salud de la placa a Losant
    Suma al resumen de cada minuto ram_disp_mb, uptime_s, temp_cpu_c,
    ntp_sincronizado, usb_montado, sd_libre_mb y me_muestras_perdidas_1min.
    usb_libre_mb solo se manda con el USB montado.
2026-09-28 Vuelta atras: el bitstream lo elige el modo + cambiar_modo.sh
    asegurar_servidor(bitstream_propio=...) carga el bitstream propio solo
    para el modo evento; capturar_stream.py sigue con el del vendor. Reemplaza
    el parche a mano de la placa de pruebas (overlay.sh stream_app etapa7).
    cambiar_modo.sh evento|clasico cambia de modo como unidad transitoria de
    systemd y verifica el bitstream cargado. Probado en rp-f0fd8c.
2026-09-28 Control de Starlink compatible con el modo evento
    aplicar_objetivo.sh no verifica el rele por HW mientras el modo evento
    mide (verificar exige cargar v0.94 y cortar la medicion), salvo al
    conmutar y una verificacion cada starlink.verificacion_hw_con_modo_evento_h
    horas con Starlink prendido. control_starlink.sh detiene modo-evento
    antes de reprogramar y lo reanuda al salir; la parada no se anota como
    caida en el log de reinicios. Probado en rp-f0fd8c (sin rele), incluido
    el arranque de la placa.
2026-09-28 Anotador: ntp_sincronizado leido con adjtimex en vez de timedatectl
    timedatectl cada minuto activaba systemd-timedated via PID1; sospechoso
    del reinicio por watchdog de rp-f0fd8c del 2026-09-28. Mismo criterio
    que NTPSynchronized de systemd (error maximo < 16s).
    [resumen_modo_evento.py]
2026-09-28 Lista viva de lo que tiene que recibir la placa de campo
2026-09-28 Lista placa de campo: apt-daily/motd-news se dejan como estan
2026-09-28 Lista placa de campo: link-local, disco 1TB y piloto se verifican en campo
2026-09-28 Procedimiento de actualizacion de la placa de campo + inventario de solo lectura
    scripts_campo/actualizacion/: armar el paquete desde un commit (units,
    bitstream, binario compilado en la placa de pruebas, MANIFIESTO sha256),
    mandarlo con reintentos y verificacion, aplicarlo desacoplado con
    respaldo y vuelta atras automatica, y revertir a mano. inventario_placa.sh
    saca una foto de solo lectura del estado de una placa para compararla.
    Ensayado en rp-f0fd8c puesta en estado campo (normal, corte de paquete y
    de SSH, falla forzada, vuelta atras a mano); el ensayo encontro que en git
    los .sh estan en 644 (en campo tenian +x a mano) y el paquete los arregla.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
2026-09-28 Chequeo previo sin cambios (SOLO_CHEQUEAR) y estado_placa.sh de solo lectura
    aplicar_actualizacion.sh: SOLO_CHEQUEAR=1 corre los chequeos previos
    contra un paquete ya enviado y termina sin tocar nada; recibe la carpeta
    del paquete como argumento y la pasa al relanzarse desacoplado.
    estado_placa.sh: resumen de modo, servicios, medicion, salud, rele,
    cartero y actualizaciones. Probados en las dos placas.
2026-09-29 Visor de paquetes con umbral 5 (el del modo evento) y pasos para analizar los CSV de ventanas en el README
    ver_paquete.py usa su propio UMBRAL_KURT=5 en vez del FA_THRESH=6 de
    revisar.py (que sigue igual para revisar/acumulado).
2026-09-29 Umbral de kurtosis 5 en todo el analisis (antes 6)
    FA_THRESH de revisar.py y KURT_FIJO_ACUMULADO de ver_forma_onda.py pasan a
    5, igual que el modo evento de la placa. ver_paquete.py vuelve a tomar
    FA_THRESH de revisar.py (un solo lugar para el umbral).
2026-09-29 Leer el rele sin frenar la captura con el bitstream que trae la lectura de DIO
    Con el bitstream de fpga_pitaya rama lectura-dio (DIO2_P siempre entrada,
    pines en 0x40200078, ID 0x534D0001 en 0x4020007C), control_starlink.sh lee
    el feedback ahi y no para el modo evento ni carga v0.94; aplicar_objetivo.sh
    verifica contra el HW en cada ciclo (sin los atajos de cache). Sin ese ID
    (v0.94, stream_app del vendor, propio viejo) sigue el camino de siempre.
    lectura_rele_directa() en mux_ps10_common.sh solo lee el ID con un
    bitstream ya cargado (/tmp/loaded_fpga.inf presente y distinto de v0.94),
    para no leer la logica programable mientras se reprograma.
    Probado en rp-f0fd8c (10k a 3.3V + cable a GND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
2026-09-29 Subida de los CSV horarios del modo evento a Google Cloud Storage
    subir_csv_gcs.py (subir-csv-gcs.timer, cada 10 min): cada hora cerrada de
    /mnt/usb/eventos/ventanas_*.csv se comprime (gzip 6, ~3 MB -> ~0.7 MB) y
    se sube a <gcs.prefijo>/<hostname>/AAAA/MM/DD/ en el bucket
    vista-sandvision-scout-files, con ifGenerationMatch=0 (nunca pisa; 412 =
    ya estaba) y md5 verificado. Sin internet falla rapido y reintenta; el CSV
    del USB es la cola y gcs.subidos_file registra lo subido. Solo stdlib +
    openssl (la placa de pruebas no tiene curl): el token de 1h se firma en la
    placa y la clave va a un temporal en /run que se borra.
    La cuenta de servicio solo tiene storage.objects.create; la clave
    (gcs.cred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
2026-09-30 gitignore: API token de Losant de las pruebas de subida de CSV
2026-09-30 Leer la config de una sola vez en el camino del reconciliador
    Cada python3 cfg.py cuesta ~0.4s de CPU en la placa y el reconciliador de
    5 min hacia 16 por corrida (~7s de CPU, ~9s de duracion), coincidiendo con
    perdidas de muestras crudas del streaming. cfg.py acepta varias claves (un
    valor por linea, compatible con una sola) y aplicar_objetivo, decidir_objetivo
    y control_starlink leen todo en una llamada cada uno. En rp-f0fd8c: 1.6s de
    CPU y 2s por corrida, mismos valores y mismo resultado.
2026-09-30 Anotar en la lista de campo el bitstream Master fijo y cfg.py de una llamada
2026-09-30 Plan de la proxima actualizacion de campo y prefijo campo/ para GCS
    actualizar_placa_campo.md: seccion 0 (rele sin cortar la medicion + modo
    Master fijo, bitstream 7f23f7d): que va en el paquete, chequeos antes y
    despues, control de los primeros 5 min (si la lectura nueva del rele diera al
    reves, el siguiente ciclo apagaria Starlink) y vuelta atras. GCS viaja en el
    paquete pero se prende aparte (seccion 4b). config_campo.json: prefijo
    campo/csv_ventanas, espejo de pruebas/csv_ventanas de la placa de pruebas.
2026-09-30 Protecciones contra una lectura del rele al reves
    Con la lectura directa al reves, de dia el reconciliador pulsaria y apagaria
    Starlink, y en hora_off lo prenderia: horario invertido sin forma de entrar
    (el rele corta dish y router).
    - aplicar_actualizacion.sh: antes de reanudar los timers espera al bitstream
    con lectura directa y comprueba que el rele se lea 'on' (se actualiza por
    Starlink); si no, vuelve al respaldo. Ensayo: FALLA_EN=lectura_rele.
    - control_starlink.sh: nunca pulsa para 'on' si la antena responde en
    192.168.100.1:9200 (antena_responde en mux_ps10_common.sh); lo cuenta como
    fallo. Ensayo: /run/starlink_antena_prueba.
    Probado en rp-f0fd8c: bloque de la actualizacio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
2026-09-30 Plan de campo: protecciones automaticas contra la lectura del rele al reves
2026-09-30 Plan de campo: la Opcion 2 del rele apunta a la seccion 0 (ya mergeada)
2026-09-30 aplicar_actualizacion: documentar el ensayo FALLA_EN=lectura_rele en el encabezado
2026-09-30 Visor de los CSV del modo evento, portable como .exe de Windows
    - analisis/visores/visor_csv.py: abre ventanas_*.csv / .csv.gz directo, una
    o varias horas unidas, hora Argentina o UTC, lista de ventanas con
    kurtosis >= 5. Solo numpy+matplotlib+tkinter (umbral propio, un test lo
    compara con FA_THRESH).
    - vista_reducida.py: el dibujo reducido por maximo de ver_paquete.py, ahora
    compartido por los dos visores.
    - ventanas_a_paquete.py: lee .csv.gz y saltea una ultima fila cortada (CSV
    copiado mientras la placa lo escribia; antes contaba como saltada).
    - empaquetar/: armar_exe_windows.sh (PyInstaller dentro de Wine, un solo
    .exe en visor_windows/, fuera de git) y README con el entorno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
2026-09-30 Plan de campo: segunda actualizacion aplicada, disco USB caido y GCS apagado
    - Estado: version campo-2026-09-30 instalada el 30/9 18:05 UTC; abierto el
    disco USB que no enumera tras dos congelamientos y lo temporal en /run
    (CSV a la SD sin cruda, tmpfs en /mnt/usb para Losant) hasta el corte de
    energia.
    - Seccion 0: resultado de la actualizacion y del ensayo desde estado campo.
    - 4b: GCS apagado en campo hasta entender los congelamientos (la rafaga no
    los reproduce en la placa de pruebas).
2026-09-30 Visor de CSV: area acumulada (kurtosis > umbral editable, 3.8) y lanzador
    - visor_csv.py: tres graficos de arriba abajo, kurtosis / area bruta / area
    acumulada (suma del area de las ventanas con kurtosis estrictamente mayor
    al umbral del casillero, 3.8 por defecto); linea del umbral en el grafico
    de kurtosis; fechas del eje en formato numerico (30/09).
    - vista_reducida.py: tercera serie opcional en su propio eje.
    - abrir_visor_csv.sh: doble click, acepta CSV o carpetas.
    - test: 3.8 exacto no suma.
2026-09-30 Visor de CSV: grupos en el acumulado y nombres repetidos por carpeta
    - La seleccion se parte en grupos (A, B, ...) donde hay mas de 1 h entre
    ventanas seguidas: linea vertical y letra en cada inicio, subtotal de area
    acumulada de cada grupo en el grafico y en el panel.
    - Si el mismo nombre de CSV viene de dos carpetas, la lista muestra la
    carpeta.
    - vista_reducida: los grupos del dibujo reducido se cortan tambien en cada
    hueco (un grupo a caballo de un hueco quedaba con la hora en el medio).
2026-10-01 Estudio area del sensor vs kg de arena de las purgas del BBS
    docs/estudio_arena_vs_kg.md: verdad de campo (purgas, no el kg/h de la
    planilla), metricas M1/M2/M3 fijadas, tabla de intervalos 29/9-1/10,
    prediccion registrada antes de la purga que cierra el intervalo del 1/10
    04:00 local, parametros que pueden influir y preguntas para el pozo.
    analisis/estudio_arena/metricas_purgas.py: lee las purgas de la planilla y
    calcula las metricas por intervalo con los CSV del modo evento.
2026-10-01 Estudio arena vs kg: ruta de la planilla en datos_campo/planillas
2026-10-01 Sacar Google Cloud Storage del sistema
    Decision del 1/10: los CSV se bajan a mano cuando hacen falta y se suben a
    Google Drive desde la PC. Se borran subir_csv_gcs.py, sus units,
    transferencia_gcs/ y el bloque gcs del config. actualizar_placa_campo.md 4b
    queda como "descartado" con la limpieza a mano de cada placa (el paquete no
    borra lo ya instalado). Placa de pruebas ya limpia; campo pendiente.
2026-10-01 Plan de campo: watchdog de systemd de 5 s a 30 s
    Probado en la placa de pruebas el 1/10: con 5 s, systemctl list-unit-files
    con la captura corriendo (~5 s) reinicio la placa por watchdog al primer
    intento; con 30 s, 3 de 3 sin reinicio (daemon-reload ~3.4 s). Explica los
    reinicios de la limpieza de GCS y probablemente el del 30/9 18:11. Lab
    aplicado; campo pendiente.
2026-10-01 Plan de campo: watchdog de 30 s aplicado tambien en campo (1/10)
2026-10-01 Modo evento: medir sin disco y avisar a Losant con me_estado
    Sin disco en /mnt/usb la placa ya no queda sin medir: supervisor_eventos.sh
    arrancar (nuevo ExecStart) pasa a solo el CSV de ventanas en la SD
    (rutas.eventos_sd, cruda siempre pausada) y automount_usb.sh relanza el
    servicio cuando el disco vuelve. El anotador lee el destino real de
    /run/modo-evento/destino, deja los resumenes en /run/losant_pendientes si no
    hay disco (antes no llegaba nada a Losant), no toma un tmpfs como disco, y
    reporta me_estado = midiendo / midiendo_sin_disco / no_midiendo. El cartero
    manda las dos carpetas.
    Probado en rp-f0fd8c: con disco, sin disco, vuelta del disco y captura
    parada, 4/4.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
2026-10-01 Plan de campo: medir sin disco aplicado en campo (1/10)
2026-10-01 GCS v2: vuelve la subida de CSV, con registro en la SD y origen sin disco
    Recupera el rediseño de gcs-registro-sd (registro en la SD, gzip 1, de a 2
    por corrida con 30 s de pausa, Nice=19, CPUQuota=25%) y agrega un segundo
    origen: los CSV de rutas.eventos_sd cuando la placa mide sin disco, que suben
    con sufijo _sd para no chocar con la misma hora del disco. Vuelve el bloque
    gcs del config. Plan de campo 4b: pasos de a uno mirando.
    Probado en rp-f0fd8c: instalacion con la captura parada y subidas 3/3 con
    md5 ok, sin reinicios.
2026-10-01 GCS v2: timer cada 5 min (antes 10)
2026-10-02 Estudio arena vs kg: purga D cerrada, umbral 3.5 y estudio completo
    - Purga que cierra D (1/10 20:00 local, 14 kg): gano M1, las lomas de area
    no fueron arena (doc sec.4.1).
    - Umbral de kurtosis de M1/M2 bajado a 3.5 (decision del 2/10, post-hoc);
    metricas_purgas.py acepta --kurt (3.8 reproduce lo anterior). Prediccion
    del intervalo abierto E registrada (sec.8.1).
    - estudio_completo.py: 32 metricas por intervalo, modelos de un parametro
    con leave-one-out, referencia sin sensor y prueba de azar por permutacion.
    N ventanas k>3.5 da 2.9 kg contra 4.2 sin sensor (p~0.08) y predice
    ~220 kg para la purga de 500 kg del 21/9 (sec.9).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
2026-10-02 Estudio arena: indicador cualitativo poca/media/mucha por hora
    nivel_arena.py cuenta por hora las ventanas con kurtosis > 3.5 y clasifica
    poca (<15), media (15-80) o mucha (>=80), con resumen por intervalo entre
    purgas si se pasa la planilla. Cortes provisorios: desde el 29/9 no hubo
    ningun intervalo de mucha arena para validarlos (doc sec.10).
2026-10-02 Modelo de arena v1 que aprende con cada purga, plan y bitacora
    - docs/plan_modelo_arena.md: objetivo, restricciones (purgas por turno),
    reglas para evaluar sin enganarse, modelo v1, procedimiento por planilla,
    etapas (hasta ML y Losant) y bitacora desde el 1/10.
    - modelo_arena.py: kg por hora = a*picos(k>3.5) + b (fondo), ajuste
    bayesiano con las purgas; cada purga se predice solo con las anteriores;
    niveles poca/media/mucha con probabilidad.
    - registro_predicciones.csv: registro que solo crece (5 retro + el
    intervalo abierto E, primera prediccion anticipada).
    [registro_predicciones.csv]
2026-10-02 GCS: sacar CPUQuota del servicio de subida (la captura salteaba ventanas)
    Con CPUQuota=25% systemd enciende el controlador cpu de cgroup v2 en
    system.slice mientras el timer esta activo; la CPU pasa a repartirse por
    unidad y la captura empieza a saltear ventanas. Campo: 0 saltadas del 29/9
    al 1/10 19:21 UTC; desde el enable del timer (19:22) ~600/h de dia; tras el
    corte del 2/10, 98% y 0 saltadas hasta la primera corrida de GCS.
    Probado en la placa de pruebas y aplicado en campo el 2/10 15:28 UTC como
    drop-in (CPUQuota=) con la captura parada: 12 min con 96.7% y 0 saltadas
    con subidas en curso. Queda Nice=19 + IOSchedulingClass=idle.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
2026-10-02 CSV de campo: una carpeta por dia (organizar_csv_campo.py)
    organizar_csv_campo.py junta los CSV de ventanas bajados de la placa en
    csv_por_dia/AAAA-MM-DD/ (dia UTC) con un indice: copias identicas -> una,
    parciales -> la completa, la misma hora repartida entre SD y disco -> unida,
    NUL del corte limpiado, conflictos sin tocar. Idempotente.
    README y procedimiento del plan del modelo actualizados a la carpeta nueva;
    bitacora: horas recuperadas del disco USB (30/9 16-18 UTC).
2026-10-02 Estudio arena: Etapa C (tipos de picos) y frente del umbral minimo
    - tipos_picos.py: rafagas de k>3.5 agrupadas sin usar los kg; la separacion
    robusta es por la "loma" de area: picos sin loma = fondo parejo que no
    sigue los kg; con loma = solo 2 episodios, en los intervalos de 15 y 14 kg.
    - umbral_reposo.py: reposo 2.974 +- 0.020; umbral de deteccion 3.05-3.10
    (contraste ~80x), pero cuantifica peor que 3.5; en los episodios se corre
    toda la distribucion. Candidato "minutos activos" con su contraejemplo.
    - Plan: secciones 7 / 7.1 / 7.2 (frentes abiertos), predicciones de v1, C1
    y C2 registradas para la purga que cierre E, preguntas nuevas al pozo.
    - requirements: scikit-learn.
    Co-A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
2026-10-05 Estudio arena: purgas E/F/G (planilla 2-5/10), v1 falla en anticipadas
    Con 7 purgas completas a~0 kg/pico, b=0.70 kg/h: los picos k>3.5 no aportan.
    Solo horas: error medio 2.3 kg vs 11.5 de v1 en anticipadas. Registro +4 filas,
    bitacora y pregunta nueva para el pozo (tardes de golpes 2/10 y 3/10).
    [registro_predicciones.csv]
2026-10-05 Estudio arena: modelos solo planilla (sec.10) y sensor contra la referencia (sec.10.1)
    planilla_historia.py: 91 intervalos desde 18/8; mejor referencia sin sensor
    tasa de las ultimas 24 h x horas (3.2 kg desde 29/9); horas en control de
    separador casi no dejan arena en el BBS. sensor_vs_referencia.py: ninguna
    medida del sensor explica el residuo (LOO empeora a 4.5-6.2 kg).
2026-10-05 Estudio arena: precursores del evento de 500 kg del 21/9 (sec.10.2)
    evento_21sep.py: dos purgas seguidas en 0 kg (38 h) antes del evento; la firma
    de kurtosis extrema del 21/9 09-13 local (k>200/300) no aparece en ninguna de
    las 144 h continuas de la FPGA. Candidato a alarma de evento grande (no
    aplicado). Correccion: el efecto control de la sec.10 se mezcla con la
    alternancia 0/X kg.
2026-10-05 Estudio arena: enfoque area acumulada con k>=3.5 (sec.10.3)
    Factor kg/area varia 150x entre intervalos; LOO 8.3 kg (neta) y 5.3 kg
    (bruta) contra 3.2 kg de la referencia de la planilla. Queda como
    indicador de actividad, no de kg.
2026-10-05 Starlink tambien sabado y domingo (dias_habilitados 1-7)
    Decision del equipo: mismo horario 08:55-17:15 local todos los dias. Solo
    config (los timers ya disparan a diario y decidir_objetivo.sh lee el JSON en
    cada corrida). Aplicado y verificado en lab y en campo el 2026-10-05; falta
    confirmar el sabado 10/10 08:55 local.
2026-10-05 Estudio arena: senal cruda de los eventos del modo evento (sec.11)
    crudas_rasgos.py: rasgos por evento (filtrada 50-400 kHz, energia por banda,
    espectro del impacto menos el fondo, duracion, SNR). 2646 eventos 29/9-5/10,
    cobertura 98% de las ventanas k>=5. A igual kurtosis los golpes del 2/10 y
    3/10 son otro tipo (menos energia >400 kHz, impacto mas largo), en trenes de
    7-10 golpes/s. Sin verdad de campo de arena en esta cadena.
2026-10-05 Estudio arena: purga H (20 kg, 5/10) y planilla acumulativa unica
    v1 16.9 y tasa 24 h 16.6 kg (anticipadas); la tasa dejo de bajar y el sensor
    estuvo tranquilo en el intervalo. Horas de la bitacora del 5/10 corregidas con
    la hora de cada commit.
    [registro_predicciones.csv]
2026-10-05 Umbral de captura de la cruda 5 -> 3.4 en lab y campo (drop-in systemd)
2026-10-05 modo-evento.service: UMBRAL=3.4 tambien en la unit del repo
2026-10-05 Umbral de captura 3.4 como default en capturar_eventos (py y C++) y docs
    Probado en la placa de pruebas: corrida sin --umbral arranca en 3.40.
2026-10-05 Defaults de umbral 3.4 instalados tambien en la placa de campo
2026-10-05 Modo evento: --canales 1|2 (Fase 0 del plan de dos canales)
    Con --canales 2 se enciende el IN2 (referencia, A_1_20) y la linea de
    ESTADO agrega muestras/perdidas/raw_max del IN2; por ahora no se guarda.
    Default 1 = igual que antes. Plan y bitacora en docs/plan_dos_canales.md
    (dual dec32 en rp-f0fd8c: 15 min sin ventanas saltadas, 0.0074% de
    muestras perdidas).
2026-10-06 Modo evento dual: guardar el IN2 como _ch2.bin (Fase 1 del plan de dos canales)
    - Segundo buffer circular para el IN2, escrito antes que el IN1 en el
    callback: misma ventana, mismo indice de muestra.
    - Por evento en dual: .bin (IN1) + _ch2.bin (IN2, mismo tramo y largo).
    El .json agrega dec y canales siempre; en dual, archivo_ch2 y
    con_hueco_ch2. Si falla una escritura se borran los tres juntos.
    - ESTADO del IN2: desfase entre canales y eventos sin IN2.
    - Bitacora: D90, pulsos por loopback, W15 dual vs M15 mono, disco lleno.
2026-10-06 Modo evento: --dec 32|64 configura ventana y pasabanda de la FPGA (Fase 1b)
    - Coeficientes del pasabanda 50-400kHz por decimacion (dec32 = defaults del
    bitstream, dec64 de generar_coefs_dec64.py), escritos y verificados al
    arrancar.
    - Ventana del acumulador (0x328) escrita con el stream ya a la decimacion
    pedida, justo despues de un cambio de window_count: el RTL cierra ventana
    con sample_cnt == N-1 y achicar N tarde congelaba el contador ~36 min
    (visto en HW). Se verifica ~20 ventanas/s; si no, sale con error.
    - Bitacora: dual dec64 (0.00045% perdidas, 0 saltadas) vs dual dec32
    (0.12%, 5) escribiendo ~1 evento/s; escala FPGA/software depende de dec;
    SIGSEGV de arranque diagnos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
    [capturar_eventos.cpp, capturar_eventos.py]
2026-10-06 Modo evento: elegir mono/dual en el servicio y anotar dec en el CSV (Fase 2)
    - modo-evento.service: Environment=CANALES=1; DEC opcional (sin DEC: mono
    32, dual 64). Cambiar con un drop-in y reiniciar.
    - supervisor_eventos.sh pasa --canales/--dec y deja "canales=N dec=M" en
    /run/modo-evento/medicion; resumen_modo_evento.py manda me_canales y
    me_dec a Losant.
    - CSV de ventanas con 7.a columna dec (un cambio de modo en la misma hora
    mezclaba areas de dec32 y dec64). resumen_modo_evento.py y
    organizar_csv_campo.py aceptan 6 o 7 columnas (las viejas = dec32);
    ventanas_a_paquete.py corta tramo si cambia dec y lo anota por segmento.
    - Probado en la placa de pruebas mono -> dual -> mono,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
2026-10-06 Modo evento: connect() del vendor en un hilo propio (SIGSEGV de arranque)
    El lambda de error de ConfigStreamClient::connect() escribia en la pila de
    un connect() ya terminado y el hilo principal moria saltando a 0x4e (~30%
    de los arranques con --host, cores del 2026-10-06; misma caida que en campo
    el 5/10). Ahora connect() corre en un hilo propio, debajo de 256KB de
    relleno de pila, que queda bloqueado hasta que termina el proceso.
    Placa de pruebas: 20/20 arranques limpios y 0 "Operation aborted" (antes
    3/10 caidas).
    [capturar_eventos.cpp]
2026-10-06 Visor de forma de onda: abrir eventos del modo evento (IN1 + IN2)
    ver_forma_onda.py lista los evento_*.bin de una carpeta (el _ch2.bin se abre
    con su evento), toma fs y dec del .json y muestra IN1 y, en dual, IN2, crudos
    y filtrados como cualquier captura. El panel de info muestra la kurtosis y
    el area que calculo la FPGA para ese evento. Fase 3 de
    docs/plan_dos_canales.md, reducida a pedido del usuario (sin reconstruccion).
2026-10-06 Plan: IN2 como sensor independiente (area/kurtosis en la FPGA)
    Reemplaza la opcion A del plan de dos canales. 9 etapas con criterio de
    paso y vuelta atras; decisiones del usuario (eventos y CSV propios del IN2,
    UMBRAL2, Losant kurt/area max, mono sin IN2). Etapas 1-2 hechas en el repo
    fpga_pitaya (rama in2-sensor).
2026-10-06 Plan IN2: etapa 4 en la placa de pruebas (bitstream nuevo + software actual OK)
2026-10-06 Modo evento: IN2 como sensor independiente (etapa 6 del plan)
    Con el bitstream que calcula el IN2 (fpga_pitaya 20ac88b+, ID 0x534D0002
    en 0x36C) y --canales 2:
    - area/kurtosis del IN2 leidos de la FPGA (canal 1 = +0x20), en la misma
    ventana que el IN1 (si no, la ventana del IN2 queda saltada y se cuenta);
    - CSV y eventos propios del IN2 en <destino>/in2/ con la misma estructura
    que los del IN1, umbral propio (--umbral2 / UMBRAL2, default = el del IN1);
    - el IN1 ya no guarda _ch2.bin; el .json de cada evento dice su canal.
    Con el bitstream viejo se mide solo el IN1 y se avisa en el log.
    Probado en la placa de pruebas (6a-6d): CSV en paralelo, eventos de cada
    canal = sus ventanas sobre el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
2026-10-06 IN2 en Losant y GCS (etapa 7 del plan)
    - resumen_modo_evento.py: con la corrida en dual y <destino>/in2 presente,
    manda kurt_max_1min_in2 y area_max_1min_in2.
    - subir_csv_gcs.py: sube tambien <eventos>/in2 (sufijo _in2) y
    <eventos_sd>/in2 (_sd_in2): el CSV del IN2 tiene el mismo nombre que el
    del IN1 y asi no chocan en el bucket ni en el registro.
    Visto en Losant (test_SC) con la placa de pruebas en dual.
2026-10-06 Plan IN2: escritura con los dos sensores y ensayo de vuelta atras completa (etapa 8, parte)
2026-10-06 Cambiar mono/dual desde Losant (comando canales)
    - Modo en config_campo.json (modo_evento.canales, default 1): el supervisor
    lo lee al arrancar; una variable CANALES de un drop-in le gana (pruebas).
    La unit ya no fija CANALES: cambiar de modo no necesita daemon-reload.
    - cfg.py --poner: escritura atomica (temporal + fsync + rename + fsync).
    - cambiar_canales.sh 1|2: desacoplado (systemd-run cambiar-canales), lock
    del rele, reinicia modo-evento, espera el primer ESTADO en el modo pedido
    y, si no llega en 4 min, vuelve solo al anterior. Resultado en
    logs_campo/cambio_canales_estado.
    - Cartero: comando "canales" {"canales": 1|2}. Anotador: me_cambio.
    - fusionar_config.py: fsync.
    Proba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
2026-10-07 Cambio remoto mono/dual: pruebas de fallo forzado, lock del rele y corte de eth0 en lab
2026-10-07 Perfiles de energia: plan y registro local de energia por minuto (etapa 1)
2026-10-07 Perfiles de energia: prueba del registro con ESP32 simulado en lab
2026-10-07 Perfiles de energia: subir los CSV de energia a GCS (etapa 1b)
2026-10-07 Perfiles de energia: subida real de prueba a GCS desde lab
2026-10-07 Perfiles de energia: SOC, balance y resumen horario a Losant (etapa 2)
2026-10-07 Perfiles de energia: etapa 3 (valores de diseno) y etapa 4 (perfiles) en el plan
2026-10-07 Registro de energia: nombre de rama y estado del plan
2026-10-07 Registro de energia: camino de instalacion en campo y ruta correcta del bitstream de campo
2026-10-08 Registro de energia: aviso y atributo en_sin_lecturas_min (ESP32 sin lecturas validas)
    Minutos desde la ultima lectura valida del SmartSolar, a Losant con el
    informe cada 15 min; aviso al journal a los 10 min y al volver. Cubre
    ESP32 colgado, fuera de alcance BLE, clave cambiada o solo basura, que
    antes no se veian desde la oficina. Checklist 4c: 14 atributos.
2026-10-08 Armador de paquetes: commit real desde un tag y --bitstream-commit explicito
    --commit <tag> anotaba el hash del objeto tag (cb826cc) en vez del commit
    (3dd05e9); ahora se resuelve con ^{commit}. bitstream_repo_commit se
    deducia de la ruta del .bin (HEAD del repo FPGA, que puede no ser el del
    bitstream, o '?' fuera del repo): ahora se pasa con --bitstream-commit.
    IP del lab en el uso como <IP_LAB> (cambia segun la conexion).
2026-10-08 Registro de energia: aplicado en campo 2026-10-08 (pasos 3-9) y bug del float falso
2026-10-08 Registro de energia: SOC solo se calibra con float sostenido
    El MPPT reporto "float" 4 minutos descargando (campo 8/10 18:38 UTC) y el
    SOC quedo en 100 % confiable. Ahora hacen falta 10 minutos seguidos de float
    con v_bat_min >= 13,3 V e i_bat >= -0,1 A. Pasos para campo en 4c-bis
    (incluye resetear el SOC guardado).
    [balance_energia.py]
2026-10-08 Comando de Losant "starlink" {"accion": "off"} para apagar Starlink
    publicar_losant.py: el comando corre lo mismo que apagar-starlink
    (starlink_manual.sh off) en una unidad transitoria a los 10 s, despues de
    avisar starlink_comando="off" a Losant. Solo "off": en campo el unico
    enlace es la propia Starlink; vuelve sola por el horario o el rescate.
    Probado en el lab desde test_SC (off ejecutado, "on" ignorado).
2026-10-13 Plan de modos Starlink (ventana / permanente)
    Plan sin codigo: modos elegidos desde Losant (tag + workflow), ventana
    cada 2 h a los :05, un intento por ventana, sin cola de Losant, extension
    por firmware de la antena. Decisiones 1-18 revisadas con el usuario.
2026-10-13 Modos Starlink Fase 1: modo_operacion.sh y claves de ventana en el config
    Guarda/lee el modo (ventana|permanente) en rutas.modo_operacion_file,
    con starlink.modo_defecto si falta o es invalido. Todavia nadie lo lee.
    gcs.dias_atras 7 -> 30 (fusionar_config no lo pisa en placas existentes).
2026-10-13 Modos Starlink Fases 2 y 3a: decision por modo y ventana cada 2 h
    - decidir_objetivo.sh: reloj no confiable > permanente > ventana abierta
    (/run/starlink_ventana); manual y rescate sin cambios.
    - modo_operacion_common.sh: lectura del modo compartida (sin python extra).
    - ventana_starlink.sh + starlink-ventana.{timer,service}: cada 2 h a los :05
    hora local y al arrancar; un intento de GCS, espera Losant, extension por
    firmware, cierre garantizado por trap, log por ventana.
    - subir_csv_gcs.py: --ventana (24 CSV + toda la energia) y lock.
    Probado en el lab 11/11. Falta el instalador (Fase 3b): todavia no
    deshabilita los timers rele-on/off.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
2026-10-13 Modos Starlink Fase 3b: instalador por paquete y documentacion
    - aplicar_actualizacion.sh: exige modo permanente y sin ventana en curso,
    deshabilita starlink-rele-on/off.timer (UNITS_VIEJAS), arranca
    starlink-ventana.timer y lo verifica.
    - revertir_actualizacion.sh: units nuevas con disable --now; timers que
    estaban habilitados vuelven con enable --now.
    - armar_paquete: habilita starlink-ventana.timer.
    - Fuera aplicar_horario.sh y starlink-rele-on/off.timer.
    - COMANDOS, GUIA, DESPLIEGUE, README, setup_placa, actualizar_placa_campo 4e.
    Sin ensayar todavia en el lab.
2026-10-13 Modos Starlink Fase 4: comando "modo" y sl_modo en Losant
    - publicar_losant.py: publica sl_modo al conectar, cada informe y al
    cambiar; comando modo {"modo": "ventana"|"permanente"} guarda el modo y
    aplica el objetivo a los 10 s (unidad modo-starlink-losant).
    - balance_energia: horas de Starlink segun el modo (ventana 2 h/dia,
    permanente 24 h); nueva clave starlink.ventana_duracion_estimada_min.
    - Fuera del config hora_on/hora_off/dias_habilitados.
    Probado en el lab con el workflow real de test_SC.
2026-10-13 Modos Starlink Fase 5: Losant solo en vivo (sin cola)
    - resumen_modo_evento.py y balance_energia.py pisan un unico "ultimo"
    en /run/losant_ultimo (evento.json cada minuto, energia.json cada hora);
    el USB deja de recibir un archivo por minuto.
    - publicar_losant.py: _enviar_ultimos reemplaza al cartero; cada ultimo
    sale una vez, con su hora original, mientras hay conexion.
    - actualizar_placa_campo 4e: borrar la cola vieja tras instalar.
    PC 10/10, instalado en el lab.
2026-10-13 Modos Starlink: rescate de ventana (6 h sin ventanas => Starlink on)
    Si el timer o el servicio de la ventana deja de correr, la decision
    quedaba en "off" para siempre y se perdia el acceso. ventana_starlink.sh
    anota cada apertura en rutas.ultima_ventana_file; sin ninguna en
    starlink.rescate_ventana_horas, decidir_objetivo.sh dice "on" hasta que
    vuelva a abrir una. El manual "off" sigue ganando.
    PC 28/28; en el lab, el paso a ventana desde Losant quedo "on" por el
    rescate y la primera ventana lo levanto.
2026-10-15 Modos Starlink: tag por API REST, pausa corta en la ventana y pruebas del lab
    - comandos_losant/modo_starlink.py: cambia el tag modo_starlink desde la PC
    por la API de Losant (lee el Device, cambia solo ese tag, manda la lista
    entera y verifica). Token fuera de git (losant_api_token.txt).
    - subir_csv_gcs.py: PAUSA_VENTANA_S = 5 con --ventana (con 30 s la ventana
    de 24 CSV duraba ~12 min con la Starlink prendida esperando).
    - Plan (Fase 6): corrida de 20 ventanas en el lab, subida a GCS en ventana
    (24/24) y prueba del tag por API en test_SC.
    - COMANDOS.md y actualizar_placa_campo.md (4e) al dia.
2026-10-15 Plan modos Starlink: resultado de la pausa de 5 s en la ventana (lab 15/10)
2026-10-15 Plan cambio remoto: pruebas 1, 2 (modo clasico) y 7 con el paquete integrado (lab 15/10)
2026-10-15 me_canales informa lo que se mide (dual con bitstream sin IN2 => 1)
    capturar_eventos escribe /run/modo-evento/in2 (si/no) al leer el ID del
    bitstream; el supervisor lo borra al arrancar y al terminar; el resumen
    informa me_canales=1 si dice "no" (sin el archivo vale lo de medicion).
    No se toca /run/modo-evento/medicion: cambiar_canales.sh la usa para dar ok.
    Probado en PC (6 casos) y en el lab (dual con y sin IN2, mono, vuelta a dual).
2026-10-15 Procedimiento de instalacion del paquete integrado en la empresa (seccion 7)
    Antes / instalar / ajustes / pruebas en la empresa / primeros dias en el
    sitio / volver atras. Todo junto en un paquete, sin el escalonamiento de la
    etapa 9 del IN2 (decidido 2026-10-15: la placa esta en la empresa).
2026-10-15 IN2 asociado, etapa 1: --in2-modo asociado en capturar_eventos
    En asociado el IN2 graba su cruda solo cuando graba el IN1, la misma ventana
    y con el mismo nombre (en <destino>/in2); su CSV y su kurtosis siguen pero
    no disparan. El nombre del evento se fija al detectar. JSON con "disparo".
    Con el bitstream viejo graba la cruda sin area/kurtosis del IN2 (null).
    Probado en el lab con pulsos por loopback digital (plan, bitacora).
2026-10-15 IN2 asociado, etapas 2-4: in2_modo en config, cambio remoto y Losant
    - config modo_evento.in2_modo (default independiente); supervisor y
    capturar_eventos.py pasan --in2-modo; medicion con in2=<modo>.
    - cambiar_canales.sh 1|2 [independiente|asociado] (rechaza args de mas y el
    modo con 1; vuelve a las dos claves anteriores si falla).
    - comando "canales" de Losant con "in2" opcional; me_in2_modo en el resumen.
    - el archivo in2 dice "si" tambien en asociado con bitstream viejo.
    - actualizar_placa_campo.md seccion 7: atributo me_in2_modo y prueba en la
    empresa con los dos sensores.
    Probado en PC y en el lab (script y Losant desde test_SC).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
2026-10-15 COMANDOS.md: mono/dual y modo del IN2 (comando canales, cambiar_canales, cambiar_modo); umbral 3.4 en el ejemplo
2026-10-15 Plan canales por tag: mono/dual y modo del IN2 desde tags de Losant (modo ventana)
2026-10-16 Canales por tag: pruebas en lab 7/7 + reconexion, docs y pruebas para la empresa
    - plan_canales_por_tag: decisiones (tags canales/in2_modo dentro de "test sc")
    y bitacora del 16/10 (tabla 7/7, desconexion simulada: ok a 42 s de conectar).
    - COMANDOS.md: en modo ventana usar los tags; un comando a mano distinto del
    tag lo deshace el workflow.
    - ventana_starlink.sh / plan_modos_starlink: ventana_espera_losant_s cubre
    tambien el comando canales (solo comentarios).
    - actualizar_placa_campo 7.4: prueba de canales por tag en ventana real y
    advertencia de aplicar_objetivo con el cable puesto.
2026-10-16 Canales por tag: bitacora de la tarde (modo_starlink re-verificado, pantalla de tags desactualizada)
2026-10-16 docs/modo_evento.md al dia: mono/dual, IN2 independiente/asociado, cambio remoto y tags
    - Estado campo/lab/paquete integrado y planes de cada parte.
    - Seccion "Mono y dual": modos, dec64 en dual, bitstream sin IN2, cambiar de
    modo (script, comando, tags), atributos de Losant.
    - Formatos: columna dec del CSV; canal/disparo/dec/canales en el JSON.
    - plan_dos_canales.md: opcion A reemplazada por el IN2 independiente.
2026-10-16 Sec.7 campo: ensayo completo en lab OK; arreglos al reset del SOC y orden de los tags
    - Ensayo 16/10: vuelta atras a mano x2 hasta estado campo, aplicar 864a15c
    (ok, 80/80 archivos) y comandos literales de 7.3.
    - Reset del SOC en una sola linea (copiado crudo daba IndentationError por la
    indentacion de la lista) y con ';' antes del start (con '&&' el cartero
    quedaba parado si fallaba el python). Igual en 4c-bis.
    - Crear los tags canales/in2_modo del Device de campo recien despues de
    RESULTADO ok (en el ensayo el comando llego durante la verificacion).
2026-10-16 Etapa 5 IN2 con el T: pulsos, arena y forma de banda con tonos en lab
    T de OUT1 a IN1+IN2, jumpers en LV. Pulsos y tramo de arena en la misma
    ventana en los dos canales; ganancia IN2/IN1 ~0.99. Forma de banda dec64 a
    0.19 dB del diseño en 50-400 kHz (cierra el pendiente de la Fase 1b).
    Reposo a repetir (ruido externo). Herramientas: comparar_in1_in2.py y
    tonos_banda.py (analisis por mesetas: el DAC por red no respeta grilla fija).
2026-10-16 modo_evento.md: lab con jumpers en HV y el T de OUT1 a IN1+IN2 puesto
2026-10-19 Reposo dual con el T cerrado con los datos del fin de semana en lab
    17-18/10 con T y jumpers en HV: kurtosis 3.0 en los dos canales, cero
    eventos, cero ventanas no ok; area IN2/IN1 0.973. Se saca el pendiente
    de modo_evento.md.
2026-10-19 Sec.7.1 campo: workflow modo_starlink de SC1 probado y atributos creados
    Workflow aparte para el Device de campo SC1 (misma aplicacion que test_SC),
    probado sin la placa con Virtual Button + Device: State + Debug (casos
    permanente, ventana y sin sl_modo). Tags canales/in2_modo siguen para 7.4.
2026-10-19 Sec.7.3 campo: verificar que el timer de GCS quede habilitado
    En permanente el timer de 5 min es el unico que sube a GCS y el paquete no
    lo toca; si falta, Losant sigue recibiendo todo y nada avisa. En el lab
    estaba deshabilitado (visto 19/10).
2026-10-20 Sec.7 campo: paquete integrado instalado en la placa de campo y canales por tag
    7.1 (IN2 sin nada, jumper HV; respaldo completo previo; permanente),
    7.2 (864a15c RESULTADO ok), 7.3 completo (GCS, dias_atras 30, SOC
    reseteado) y 7.4 mono/dual/asociado por tag de SC1. Queda en mono.
2026-10-20 CSV del modo evento: recortar la linea cortada por un corte de energia al reabrir
    Al reabrir el CSV de la hora en modo "a", la fila nueva se pegaba a la
    linea que un corte de energia dejo a medias (campo 2026-10-20,
    ventanas_20261020_14.csv: timestamp truncado y area en la columna de t).
    capturar_eventos recorta lo posterior al ultimo \n (tambien los NUL) y lo
    deja en el log. Los lectores de la PC descartan las filas pegadas que ya
    estan en GCS. Probado en el lab: 11 bytes recortados, 0 filas mal formadas
    en IN1 e IN2. Seccion 8 del plan de campo con este cambio y el pendiente
    del primer pulso del rele.
2026-10-21 Sec.8 campo: sacar el fix del primer pulso del rele y sumar el reset al pasar a permanente
    El fix de pulsar_ps queda descartado (el reconciliador ya lo corrige y anduvo
    bien en campo). El reset al prender el rele va 4 de 4: el 20/10 20:36 UTC al
    pasar a permanente por Losant; despues 15 h con el rele on sin resets.
2026-10-21 Sec.8 campo: fix del CSV instalado en la placa de campo (paquete 71bc2ee)
    Paquete 20261021_122105_71bc2ee aplicado en la oficina, RESULTADO ok: binario
    igual al probado en el lab, sin reset, mono dec32, permanente, CSV sin filas
    mal formadas.
2026-10-21 Rele: frenar la captura y sync antes de prender (mitigacion del reset por hardware)
    Prender el rele despues de mas de ~35-45 s en off resetea rp-f0fbda (pruebas
    del 21/10 en la oficina: no depende de quien pulsa ni de la captura). Con
    lectura directa, control_starlink.sh ahora para modo-evento y hace sync antes
    del pulso de on para que el corte agarre menos escrituras en curso; el trap
    EXIT la reanuda. Seccion 8 del plan de campo con las pruebas y el arreglo de
    hardware pendiente.
2026-10-21 Sec.8 campo: mitigacion del rele instalada en la placa de campo (paquete ff47f40)
2026-11-02 Documentacion al dia con el modo evento (guia basica, README, COMANDOS y guias de campo)
    La guia de uso basico, el README, COMANDOS y PLAN_CAMPO seguian describiendo la
    captura a pedido con capturar_stream.py como camino principal. Ahora describen lo
    que corre hoy: modo evento 24 h, ventanas de Starlink, CSV a GCS/SandVision,
    mono/dual por tags y actualizacion por paquete; el modo clasico queda marcado
    como vuelta atras. Troubleshooting suma una seccion de modo evento; cabeceras
    de estado al 2/11 (PAD-118, dual, ventana).
2026-11-02 Guias: sacar el visor de paquetes (en desuso); los CSV se miran en SandVision
